praisejimmy/CapstoneProjectOWL/README.md

# CapstoneProjectOWL
CPE capstone repository for Project OWL
