praisejimmy/CapstoneProjectOWL/Hardware/README

Capstone Project RAFT Hardware
***
Ryan Myers
Tristan Chutka
Jake Loveland
Noah Palumbo
***

This folder contains all hardware design files for the RAFT system.
Autodesk EAGLE is used for circuit and PCB design.
