praisejimmy/CapstoneProjectOWL/Hardware/RAFT_DuckLink_RFH_BoM_2020Jan24.xlsx

Qty | Value | Device | Package | Ref Des | Description | DIGI-KEY_PART_NUMBER | DIGI-KEY_PURCHASE_URL | MF | MPN | PACKAGE.1
18 | 0.1uF | GCM155R71C104KA55J | CAPC1005X55N | C4, C6, C7, C8, C9, C10, C16, C18, C19, C20, C21, C34, C35, C36, C52, C55, C56, C62 | Cap Ceramic 0.1uF 16V X7R 10% Pad SMD 0402 125Â°C Automotive T/R | 490-7998-1-ND | https://www.digikey.com/product-detail/en/murata-electronics/GCM155R71C104KA55J/490-7998-1-ND/4380283 | Murata | GCM155R71C104KA55J | 1005 Taiyo Yuden
3 | 0R | CRCW04020000Z0ED | RESC1005X40N | R2, R3, R4 | RESISTOR, 0402, 0R, FULL REEL | 541-0.0JCT-ND | https://www.digikey.com/product-detail/en/vishay-dale/CRCW04020000Z0ED/541-0.0JCT-ND/1182611 | Vishay | CRCW04020000Z0ED | 1005 Panasonic Electronic Components
4 | 1.0uF | GCM155C71A105KE38D | CAPC1005X70N | C54, C59, C60, C61 | Cap Ceramic 1uF 10V X7S 10% Pad SMD 0402 125C Automotive T/R |  |  | Murata | GCM155C71A105KE38D | 1005 Murata
1 | 1.5pF | GCM1555C1H1R5JA16D | CAPC1005X55N | C26 | CAP AUTO-GRADE 1.5PF 50VDC C0G 5% SMD 0402 | 490-16452-1-ND | https://www.digikey.com/product-detail/en/murata-electronics/GCM1555C1H1R5JA16D/490-16452-1-ND/7363434 | Murata Electronics | GCM1555C1H1R5JA16D | 1005 Taiyo Yuden
1 | 1.5uH | LQM18PN1R5MFRL | INDC1608X95N | L9 | FIXED IND 1.5UH 800MA 288 MOHM | 490-17890-1-ND | https://www.digikey.com/product-detail/en/murata-electronics/LQM18PN1R5MFRL/490-17890-1-ND/8540126 | Murata | LQM18PN1R5MFRL | 1608 Murata
1 | 1.7pF | GCM1555C1H1R7CA16D | CAPC1005X55N | C12 | CAP CER 1.7PF 50V NP0 0402 | GCM1555C1H1R7CA16D-ND | https://www.digikey.com/product-detail/en/murata-electronics/GCM1555C1H1R7CA16D/GCM1555C1H1R7CA16D-ND/4903569 | Murata | GCM1555C1H1R7CA16D | 1005 Taiyo Yuden
1 | 1.8pF | GCM1555C1H1R8CA16D | CAPC1005X55N | C30 | CAP AUTO-GRADE 1.8PF 50VDC C0G 0.25PF SMD 0402 | 490-17746-1-ND | https://www.digikey.com/product-detail/en/murata-electronics/GCM1555C1H1R8CA16D/490-17746-1-ND/8539982 | Murata Electronics | GCM1555C1H1R8CA16D | 1005 Taiyo Yuden
1 | 10 | CRCW040210R0JNEDC | RESC1005X35N | R15 |  | 541-4122-1-ND | https://www.digikey.com/product-detail/en/vishay-dale/CRCW040210R0JNEDC/541-4122-1-ND/7928805 | Vishay | CRCW040210R0JNEDC | 1005 Yageo
3 | 100k | CRCW0402100KFKED | RESC1005X40N | R19, R5, R10 | RES, THICK FILM, 100K, 1%, 0.063W, 0402 | 541-100KLCT-ND | https://www.digikey.com/product-detail/en/vishay-dale/CRCW0402100KFKED/541-100KLCT-ND/1183351 | Vishay | CRCW0402100KFKED | 1005 Panasonic Electronic Components
2 | 100pF | GCM1555C1H101JA16D | CAPC1005X55N | C5, C33 | Cap Ceramic 100pF 50V C0G 10% Pad SMD 0402 125Â°C Automotive T/R | 490-10669-1-ND | https://www.digikey.com/product-detail/en/murata-electronics/GCM1555C1H101JA16D/490-10669-1-ND/5251436 | Murata | GCM1555C1H101JA16D | 1005 Taiyo Yuden
3 | 10K | CRCW040210K0JNED | RESC1005X40N | R16, R17, R9 | RES, THICK FILM, 10K, 5%, 0.063W, 0402, | 541-10KJCT-ND | https://www.digikey.com/product-detail/en/vishay-dale/CRCW040210K0JNED/541-10KJCT-ND/1182708 | Vishay Dale | CRCW040210K0JNED | 1005 Panasonic Electronic Components
3 | 10nF | GCM155R71H103KA55D | CAPC1005X55N | C14, C15, C25 | 10000pF Â±10% 50V Ceramic Capacitor X7R 0402 (1005 Metric)
1 | 10nH | LQG15HS10NJ02D | INDC1005X55N | L3 | Ind RF Chip Multi-Layer 10nH 5% 100MHz 8Q-Factor Air 300mA 0402 Paper T/R | 490-2623-1-ND | https://www.digikey.com/product-detail/en/murata-electronics/LQG15HS10NJ02D/490-2623-1-ND/662903 | Murata | LQG15HS10NJ02D | 1005 Murata
8 | 10uF | GRM155C80J106ME11D | CAPC1005X70N | C40, C50, C51, C53, C63, C64, C65, C68 | 10µF ±20% 6.3V Ceramic Capacitor X6S 0402 (1005 Metric) | 490-13233-1-ND | https://www.digikey.com/product-detail/en/murata-electronics/GRM155C80J106ME11D/490-13233-1-ND/5877441 | Murata Electronics | GRM155C80J106ME11D | 1005 Murata
1 | 10uH | LQM18FN100M00D | INDC1608X90N | L10 | Inductor Power Chip Shielded Multi-Layer 10uH 20% 1MHz Ferrite 50mA 1.17Ohm DCR 0603 T/R | 490-4025-1-ND | https://www.digikey.com/product-detail/en/murata-electronics/LQM18FN100M00D/490-4025-1-ND/1016285 | Murata Electronics | LQM18FN100M00D | 1608 Murata
1 | 150k | CRCW0402150KFKEDC | RESC1005X35N | R7 |  | 541-4008-1-ND | https://www.digikey.com/product-detail/en/vishay-dale/CRCW0402150KFKEDC/541-4008-1-ND/7928691 | Vishay Dale | CRCW0402150KFKEDC | 1005 Yageo
1 | 15K | CRCW040215K0JNED | RESC1005X40N | R1 | Res Thick Film 0402 15K Ohm 5% 1/16W Â±200ppm/Â°C Molded SMD SMD Paper T/R | 541-15KJCT-ND | https://www.digikey.com/product-detail/en/vishay-dale/CRCW040215K0JNED/541-15KJCT-ND/1182712 | Vishay Dale | CRCW040215K0JNED | 1005 Panasonic Electronic Components
9 | 15pF | GCM1555C1H150JA16D | CAPC1005X55N | C1, C17, C22, C31, C32, C43, C44, C45, C46 | Cap Ceramic 15pF 50V C0G 5% Pad SMD 0402 125C Automotive T/R | 490-11147-1-ND | https://www.digikey.com/product-detail/en/murata-electronics/GCM1555C1H150JA16D/490-11147-1-ND/5332987 | Murata | GCM1555C1H150JA16D | 1005 Taiyo Yuden
2 | 1nF | GCM155R71H102KA37D | CAPC1005X55N | C11 | Cap Ceramic 0.001uF 50V X7R 10% Pad SMD 0402 125C Automotive T/R | 490-4761-1-ND | https://www.digikey.com/product-detail/en/murata-electronics/GCM155R71H102KA37D/490-4761-1-ND/1641680 | Murata | GCM155R71H102KA37D | 1005 Taiyo Yuden
3 | 1uF | GCM155C71A105KE38D | CAPC1005X70N | C37, C38, C39 | Cap Ceramic 1uF 10V X7S 10% Pad SMD 0402 125C Automotive T/R | 490-13409-1-ND | https://www.digikey.com/product-detail/en/murata-electronics/GCM155C71A105KE38D/490-13409-1-ND/6012281 | Murata | GCM155C71A105KE38D | 1005 Murata
1 | 2.2uF | GRM155D80J225ME95D | CAPC1005X55N | C58 | CAP CER 2.2UF 6.3V X6T 0402 | 490-10450-1-ND | https://www.digikey.com/product-detail/en/murata-electronics/GRM155D80J225ME95D/490-10450-1-ND/5026360 | Murata | GRM155D80J225ME95D | 1005 Taiyo Yuden
1 | 20m | ERJ-3BWFR020V | RESC1608X55N | R_SR |  | P17461CT-ND | https://www.digikey.com/product-detail/en/panasonic-electronic-components/ERJ-3BWFR020V/P17461CT-ND/5647945 | Panasonic | ERJ-3BWFR020V | 1608 Panasonic Electronic Components
1 | 22pF | GCM1555C1H220JA16J | CAPC1005X55N | C67 | Cap Ceramic 22pF 50V C0G 5% Pad SMD 0402 125C Automotive T/R | 490-17747-1-ND | https://www.digikey.com/product-detail/en/murata-electronics/GCM1555C1H220JA16J/490-17747-1-ND/8539983 | Murata | GCM1555C1H220JA16J | 1005 Taiyo Yuden
3 | 22uF | GRM188R60J226MEA0D | CAPC1608X100N | C47, C48, C49 | Cap Ceramic 22uF 6.3V X5R 20% Pad SMD 0603 85Â°C T/R | 490-7611-1-ND | https://www.digikey.com/product-detail/en/murata-electronics/GRM188R60J226MEA0D/490-7611-1-ND/4280544 | Murata | GRM188R60J226MEA0D | 1608 Murata
2 | 270pF | GRM1555C1H271JA01D | CAPC1005X55N | C41, C42 | Multilayer Ceramic Capacitor, GRM Series, 270 pF, 5%, C0G / NP0, 50 V, 0402 [1005 Metric] | 490-1294-1-ND | https://www.digikey.com/product-detail/en/murata-electronics/GRM1555C1H271JA01D/490-1294-1-ND/587902 | Murata | GRM1555C1H271JA01D | 1005 Taiyo Yuden
1 | 2k | CRCW04022K00FKED | RESC1005X40N | R14 | RESISTOR, 0402, 2K, 1%, FULL REEL | 541-2.00KLCT-ND | https://www.digikey.com/product-detail/en/vishay-dale/CRCW04022K00FKED/541-2.00KLCT-ND/1183155 | Vishay Dale | CRCW04022K00FKED | 1005 Panasonic Electronic Components
1 | 2N7002 | 2N7002 | SOT23 | Q3 |  |  |  | STMicroelectronics | 2N7002 | SOT-23-3 Vishay
1 | 2nH | LQG15HN2N0C02D | INDC1005X55N | L7 | FIXED IND 2NH 900MA 90 MOHM | 490-15076-1-ND | https://www.digikey.com/product-detail/en/murata-electronics/LQG15HN2N0C02D/490-15076-1-ND/6799741 | Murata | LQG15HN2N0C02D | 1005 Murata
1 | 32.768kHz | FC-13532.768KA-AG0 | OSCCC150X320X80-2N | Y1 | FC-135 series 32.768kHz Â±20ppm Crystal 9pF 50 kOhms, -40Â°C ~ 85Â°C, Surface Mount 2-SMD, No Lead |  |  | EPSON | FC-135R 32.7680KA-AC3 | SMD-2 Epson
2 | 32MHz | NX2016SA-32M | SMD-4 | U$1, U$2 | 32MHz Crystal 10pF 60 Ohms 4-SMD, No Lead
1 | 33nF | LQG15HS33NJ02D | INDC1005X55N | L2 | LQG Series 0402 33 nH Â±5 % Tol. 200 mA SMT High Frequency Multilayer Inductor | 490-2629-1-ND | https://www.digikey.com/product-detail/en/murata-electronics/LQG15HS33NJ02D/490-2629-1-ND/662909 | Murata | LQG15HS33NJ02D | 1005 Murata
1 | 33pF | GCM1555C1H330JA16D | CAPC1005X55N | C27 | 33pF Â±5% 50V Ceramic Capacitor C0G, NP0 0402 (1005 Metric) |  |  | Murata | GCM1555C1H330JA16D | 1005 Taiyo Yuden
1 | 36k | CRCW040236K0FKED | RESC1005X40N | R13 | Surface Mount Thick Film Resistor, AEC-Q200 CRCW Series, 36 kohm, 63 mW, - 1%, 50 V | 541-36.0KLCT-ND | https://www.digikey.com/product-detail/en/vishay-dale/CRCW040236K0FKED/541-36.0KLCT-ND/1183299 | Vishay | CRCW040236K0FKED | 1005 Panasonic Electronic Components
1 | 4.7k | CRCW04024K70JNEDC | RESC1005X35N | R8 | D10/CRCW0402-C 200 4K7 5% ET7 | 541-3974-1-ND | https://www.digikey.com/product-detail/en/vishay-dale/CRCW04024K70JNEDC/541-3974-1-ND/7928657 | Vishay | CRCW04024K70JNEDC | 1005 Yageo
2 | 4.7pF | GCM1555C1H4R7CA16D | CAPC1005X55N | C28, C29 | Cap Ceramic 4.7pF 50V C0G 0.25pF SMD 0402 125Â°C Paper T/R | 490-12652-1-ND | https://www.digikey.com/product-detail/en/murata-electronics/GCM1555C1H4R7CA16D/490-12652-1-ND/5797621 | Murata Electronics | GCM1555C1H4R7CA16D | 1005 Taiyo Yuden
2 | 4.7uF | GRM155R60J475ME87D | CAPC1005X55N | C57, C66 | Cap Ceramic 4.7uF 6.3V X5R 20% SMD 0402 85Â°C Paper T/R |  |  | Murata | GRM155R60J475ME87D | 1005 Taiyo Yuden
1 | 40MHz | R2520-40 | SMD-4 | U$3 | 40MHz Â±10ppm Crystal 12pF 60 Ohms 4-SMD, No Lead
1 | 470k | CRCW0402470KFKEDC | RESC1005X35N | R6 |  | 541-4081-1-ND | https://www.digikey.com/product-detail/en/vishay-dale/CRCW0402470KFKEDC/541-4081-1-ND/7928764 | Vishay | CRCW0402470KFKEDC | 1005 Yageo
2 | 470pF | GCM1555C1H471JA16D | CAPC1005X55N | C2, C13 | Cap Ceramic 470pF 50V C0G/NP0 5% Pad SMD 0402 125C Automotive T/R | 490-4758-1-ND | https://www.digikey.com/product-detail/en/murata-electronics/GCM1555C1H471JA16D/490-4758-1-ND/1641677 | Murata | GCM1555C1H471JA16D | 1005 Taiyo Yuden
2 | 47nF | GCM155R71C473KA37D | CAPC1005X55N | C23, C24 | Cap Ceramic 0.047uF 16V X7R 10% Pad SMD 0402 125C Automotive T/R | 490-6042-1-ND | https://www.digikey.com/product-detail/en/murata-electronics/GCM155R71C473KA37D/490-6042-1-ND/3845242 | Murata | GCM155R71C473KA37D | 1005 Taiyo Yuden
3 | 499R | CRCW0402499RFKEDC | RESC1005X35N | R11, R12, R18 | 499 Ohms Â±1% 0.063W, 1/16W Chip Resistor 0402 (1005 Metric) Thick Film | 541-4007-1-ND | https://www.digikey.com/product-detail/en/vishay-dale/CRCW0402499RFKEDC/541-4007-1-ND/7928690 | Vishay | CRCW0402499RFKEDC | 1005 Yageo
2 | 5.6nH | LQG15HS5N6C02D | INDC1005X55N | L4, L8 | FIXED IND 5.6NH 650MA 180 MOHM | 490-15129-1-ND | https://www.digikey.com/product-detail/en/murata-electronics/LQG15HS5N6C02D/490-15129-1-ND/6799794 | Murata | LQG15HS5N6C02D | 1005 Murata
1 | 6.8nH | LQG15HS6N8J02D | INDC1005X55N | L1 | 6.8nH Unshielded Multilayer Inductor 600mA 240mOhm Max 0402 (1005 Metric)
1 | 7.5nH | LQG15HN7N5H02D | INDC1005X55N | L6 | FIXED IND 7.5NH 500MA 240 MOHM | 490-15095-1-ND | https://www.digikey.com/product-detail/en/murata-electronics/LQG15HN7N5H02D/490-15095-1-ND/6799760 | Murata | LQG15HN7N5H02D | 1005 Murata
1 | 750pF | GCM1885C2A751JA16D | CAPC1608X90N | C3 | Cap Ceramic 750pF 100V C0G 5% SMD 0603 125Â°C Paper T/R | GCM1885C2A751JA16D-ND | https://www.digikey.com/product-detail/en/murata-electronics/GCM1885C2A751JA16D/GCM1885C2A751JA16D-ND/2591804 | Murata | GCM1885C2A751JA16D | 1608 Murata
1 | 8.2nH | LQG15HS8N2J02D | INDC1005X55N | L5 | Ind RF Chip Multi-Layer 8.2nH 5% 100MHz 8Q-Factor Air 300mA 0402 Paper T/R | 490-2622-6-ND | https://www.digikey.com/product-detail/en/murata-electronics/LQG15HS8N2J02D/490-2622-6-ND/1825762 | Murata | LQG15HS8N2J02D | 1005 Murata
3 | AMPHENOL_132134 | AMPHENOL_132134 | AMPHENOL_132134-15 | J1, J2, J3 | Rf Coaxial, Sma, Straight Jack, Pcb |  |  | Amphenol RF | 132134-15 | None
1 | BAT54C | BAT54C | SOT23 | D2 | Schottky Diodes
1 | BQ24650RVAR | BQ24650RVAR | QFN50P350X350X100-17N | U8 | Synchronous Switch-Mode Battery Charge Controller |  |  | Texas Instruments | BQ24650RVAR | VFQFN-16 Murata Power Solutions
1 | ESP32-D0WD | ESP32-D0WD | QFN35P500X500X90-49N | U3 | ESP32 is a single 2.4 GHz Wi-Fi-and-Bluetooth combo chip designed with the TSMC ultra-low-power 40 nm technology. It is designed to achieve the best power and RF performance, showing robustness, versatility and reliability in a wide variety of applications and power scenarios. |  |  | Espressif Systems | ESP32-D0WD | VFQFN-48 Espressif Systems
1 | INTERFACE-CP2102-GMR(QFN28) | INTERFACE-CP2102-GMR(QFN28) | QFN28G_0.5-5X5MM | U5 | 310070003 |  |  | Silicon | CP2102-GMR | VFQFN-28 Vishay Siliconix
2 | LTST-C190GKT | LTST-C190GKT | 0603 | D3, D4 | https://octopart.com/ltst-c190gkt-lite-on-549821 |  |  | Lite-On Inc. | LTST-C190GKT | 0603 Lite-On
1 | MAX2771ETI+ | MAX2771ETI+ | QFN50P500X500X80-29N | U2 | None |  |  | Maxim Integrated | MAX2771ETI+ | TQFN-28 Maxim
1 | Micro-USB | 105017-0001FIXED | MOLEX_105017-0001 | J4 |  | Through Hole | WM1399CT-ND |  |  | 1050170001
1 | PDS1040-13 | PDS1040-13 | DIO_PDS1040-13 | D1 | PDS1040 Series 40 V 10 A Surface Mount Schottky Barrier Rectifier - PowerDIÂ™ 5 |  |  | Diodes Inc. | PDS1040-13 | PowerDI™ 5 Diodes Inc.
2 | PE4259 | PE4259 | SOT65P215X110-6N | U6 | SPDT High Power UltraCMOS 10 MHzâ€“3.0 GHz RF Switch |  |  | pSemi | PE4259 | SOT-363 Peregrine Semiconductor
1 | SI7288DP | SI7288DP | POWERPAK-SO8_1 | Q2 | Trans MOSFET N-CH 40V 10An Vishay SI7288DP-T1-GE3 Dual N-channel MOSFET Transistor, 20 A, 40 V, 8-Pin PowerPAK SO
1 | SIA817EDJ | SIA817EDJ | SC70-6L-DUAL | Q1 | P-Channel 30V 4.5A (Tc) 1.9W (Ta), 6.5W (Tc) Surface Mount PowerPAKÂ® SC-70-6 Dual
1 | SP0503BAHT | SP0503BAHT | SOT143 | U7 |  | SP0503BAHT-ND | https://www.digikey.com/product-detail/en/littelfuse-inc/SP0503BAHT/SP0503BAHT-ND/485122 | Littelfuse Inc. | SP0503BAHT | SOT-143 Littelfuse
1 | SX1276 | SX1276 | QFN65P600X600X100-29N | U1 | RF Transceiver FSK/GFSK/MSK/GMSK/LoRa/OOK 137MHz to 1020MHz 28-Pin QFN |  |  | Semtech Corporation | SX1276 | VQFN-28 Semtech Corporation
1 | TPS63070RNMT | TPS63070RNMT | QFN50P250X300X100-15N | U9 | Wide Input Voltage (2V-16V) Buck-Boost Converter 15-VQFN-HR |  |  | Texas Instruments | TPS63070RNMT | VQFN-15 Texas Instruments
1 | W25Q16BVSSIG | W25Q16BVSSIG | SOIC127P790X216-8N | U4 | Flash, pin, soic, flash, Memory, Semiconductors and Actives, serial, ic |  |  | Winbond | W25Q16BVSSIG | SOIC-8 Winbond
