praisejimmy/CapstoneProjectOWL/Hardware/schematics/DuckLink_RFH_schematics_2.0.pdf

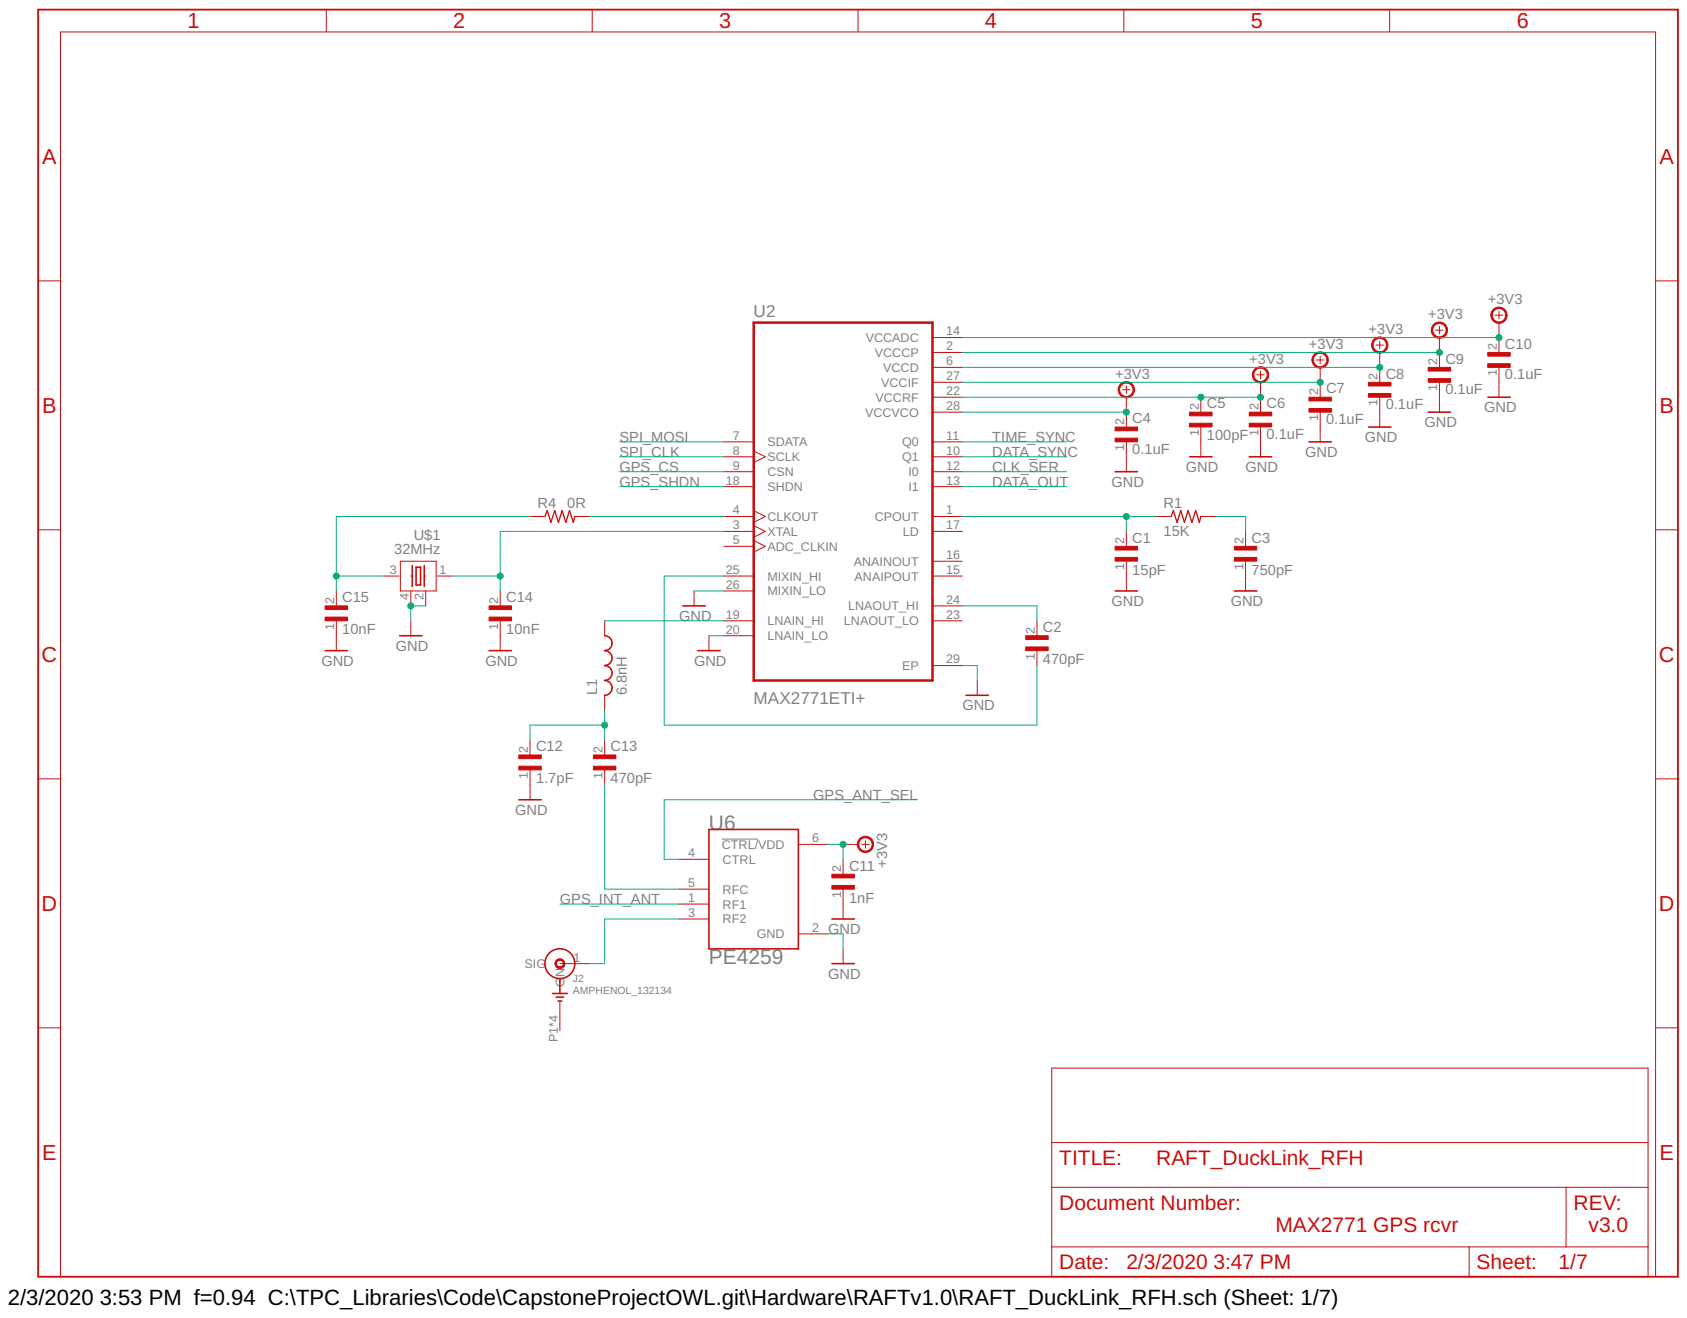
[picture p1: page 1]

2 VCCD
6 VCCIF
27 VCCRF 22 VCCVCO

Document Number: MAX2771 GPS rcvr | REV: v3.0

Date: 2/3/2020 3:47 PM | Sheet: 1/7

2/3/2020 3:53 PM f=0.94 C:\TPC_Libraries\Code\CapstoneProjectOWL.git\Hardware\RAFTv1.0\RAFT_DuckLink_RFH.sch (Sheet: 1/7)

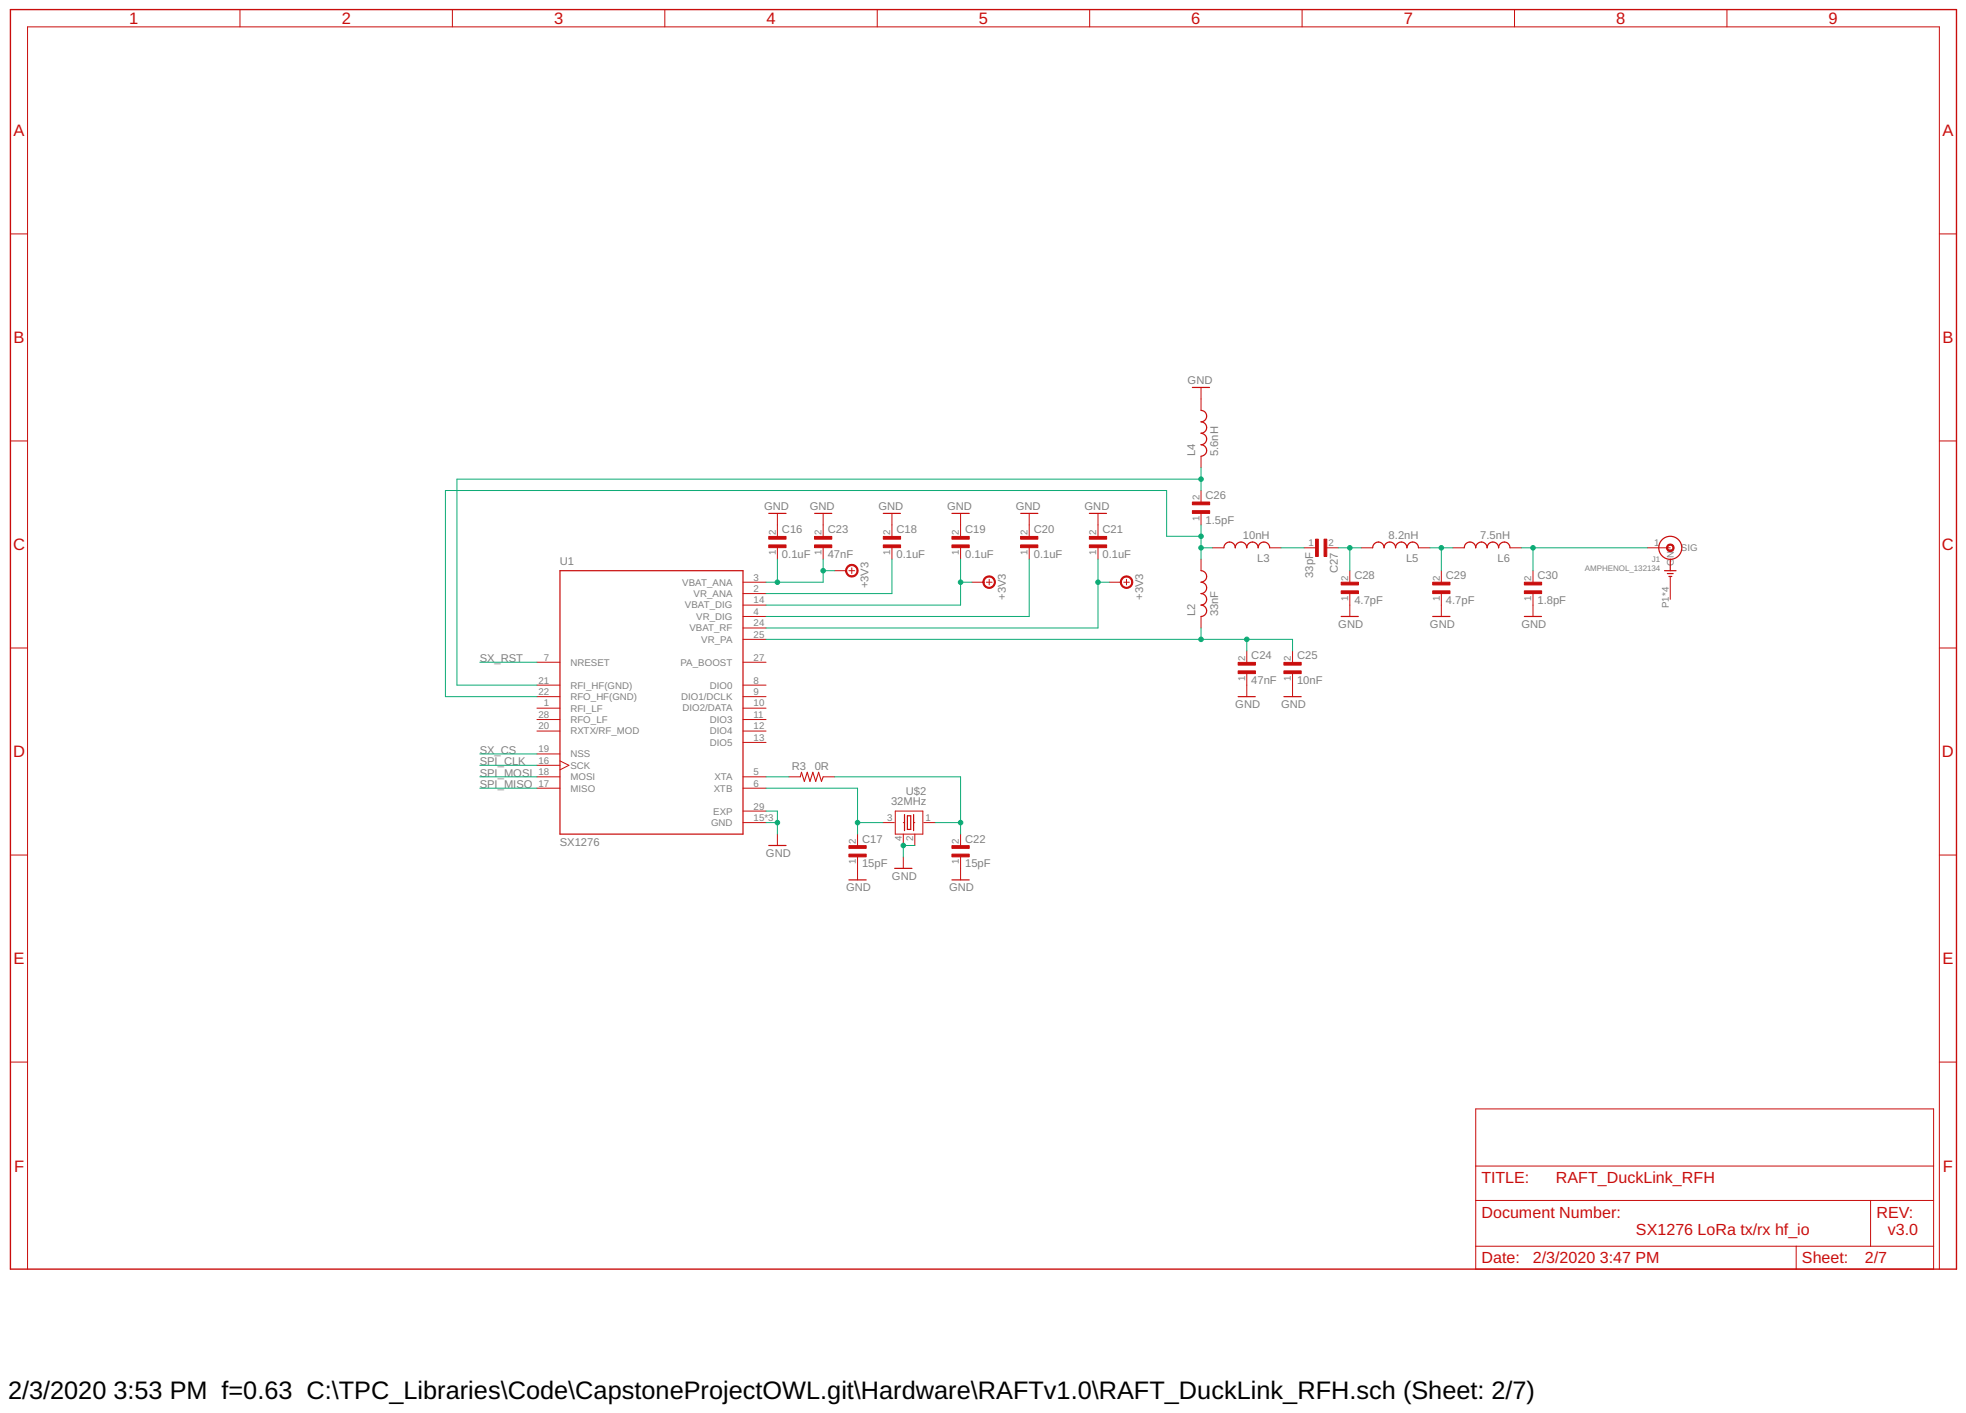
[picture p2: page 2]

2/3/2020 3:53 PM f=0.63 C:\TPC_Libraries\Code\CapstoneProjectOWL.git\Hardware\RAFTv1.0\RAFT_DuckLink_RFH.sch (Sheet: 2/7)

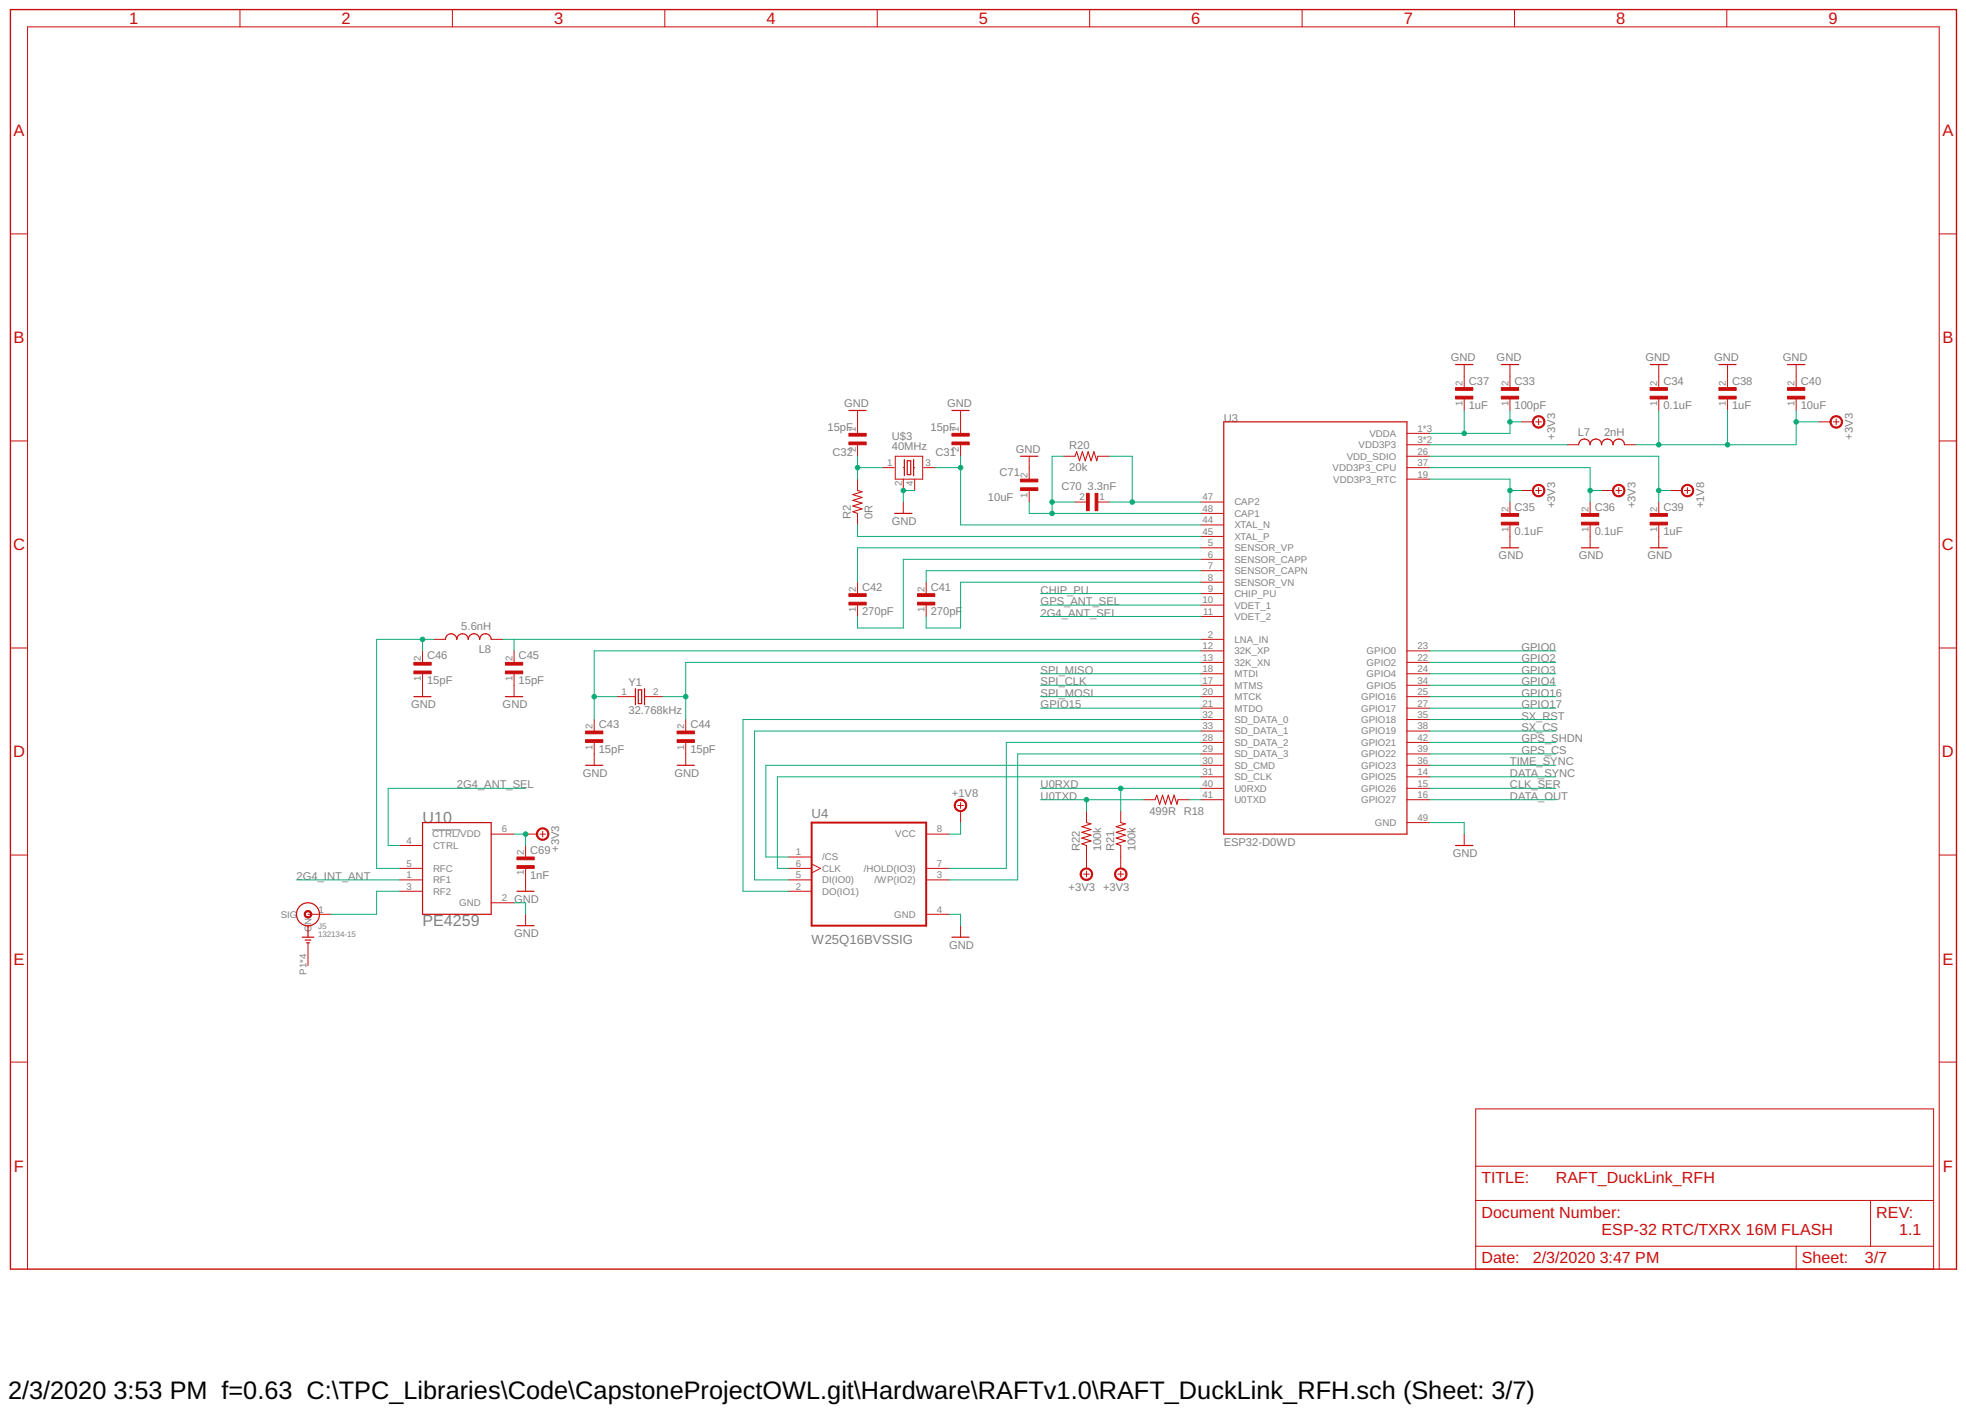
[picture p3: page 3]

2/3/2020 3:53 PM f=0.63 C:\TPC_Libraries\Code\CapstoneProjectOWL.git\Hardware\RAFTv1.0\RAFT_DuckLink_RFH.sch (Sheet: 3/7)

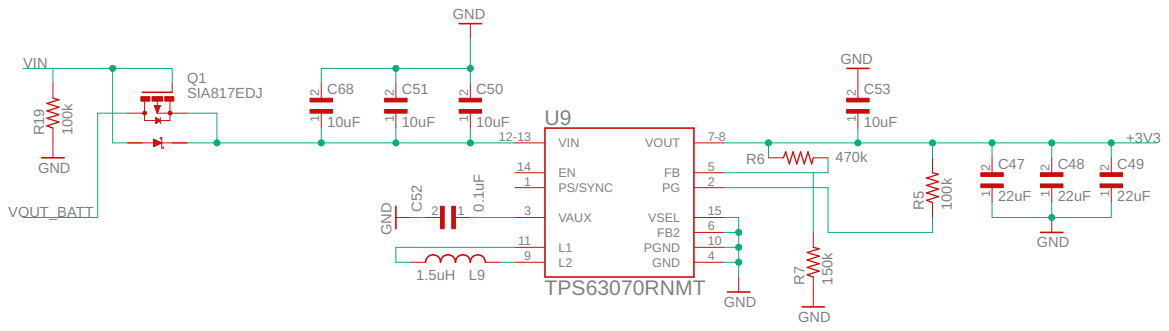
[picture p4: page 4]

2/3/2020 3:53 PM f=0.94 C:\TPC_Libraries\Code\CapstoneProjectOWL.git\Hardware\RAFTv1.0\RAFT_DuckLink_RFH.sch (Sheet: 4/7)

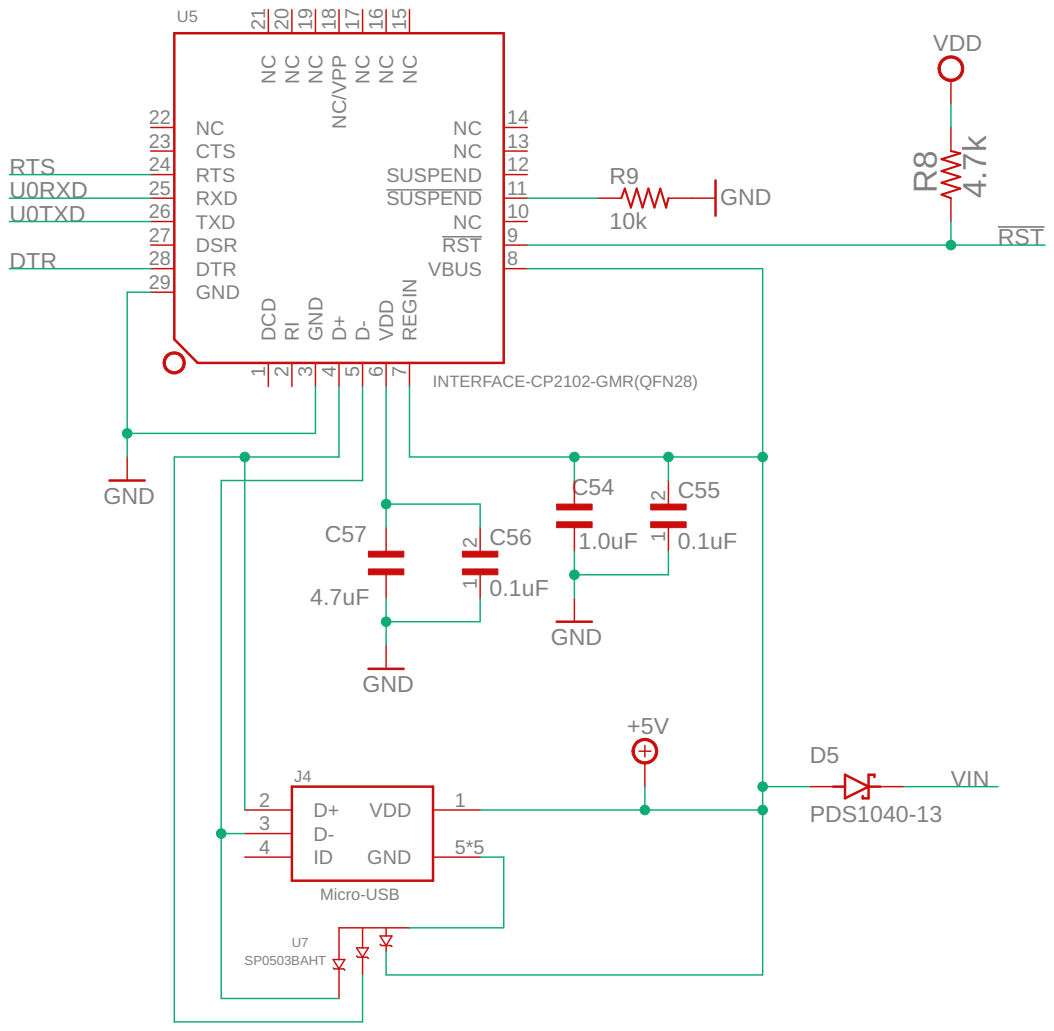
[picture p5: page 5]

2/3/2020 3:53 PM f=0.94 C:\TPC_Libraries\Code\CapstoneProjectOWL.git\Hardware\RAFTv1.0\RAFT_DuckLink_RFH.sch (Sheet: 5/7)

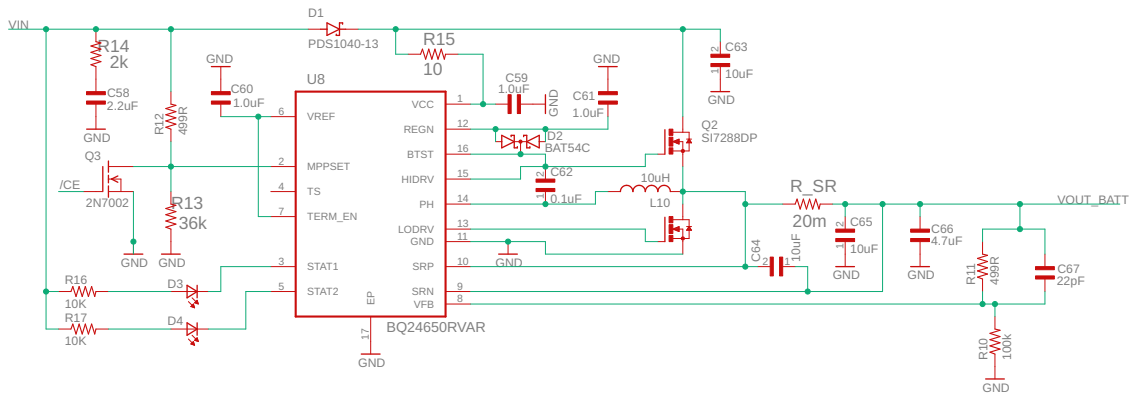
[picture p6: page 6]

2/3/2020 3:53 PM f=0.94 C:\TPC_Libraries\Code\CapstoneProjectOWL.git\Hardware\RAFTv1.0\RAFT_DuckLink_RFH.sch (Sheet: 6/7)

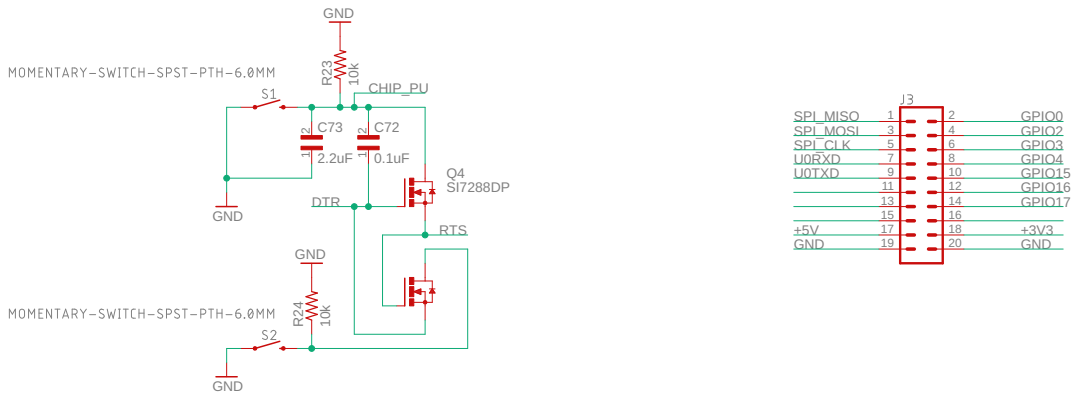
[picture p7: page 7]

2/3/2020 3:53 PM f=0.94 C:\TPC_Libraries\Code\CapstoneProjectOWL.git\Hardware\RAFTv1.0\RAFT_DuckLink_RFH.sch (Sheet: 7/7)
