praisejimmy/CapstoneProjectOWL/Hardware/schematics/DuckLink_RFH_schematics_2.1.pdf

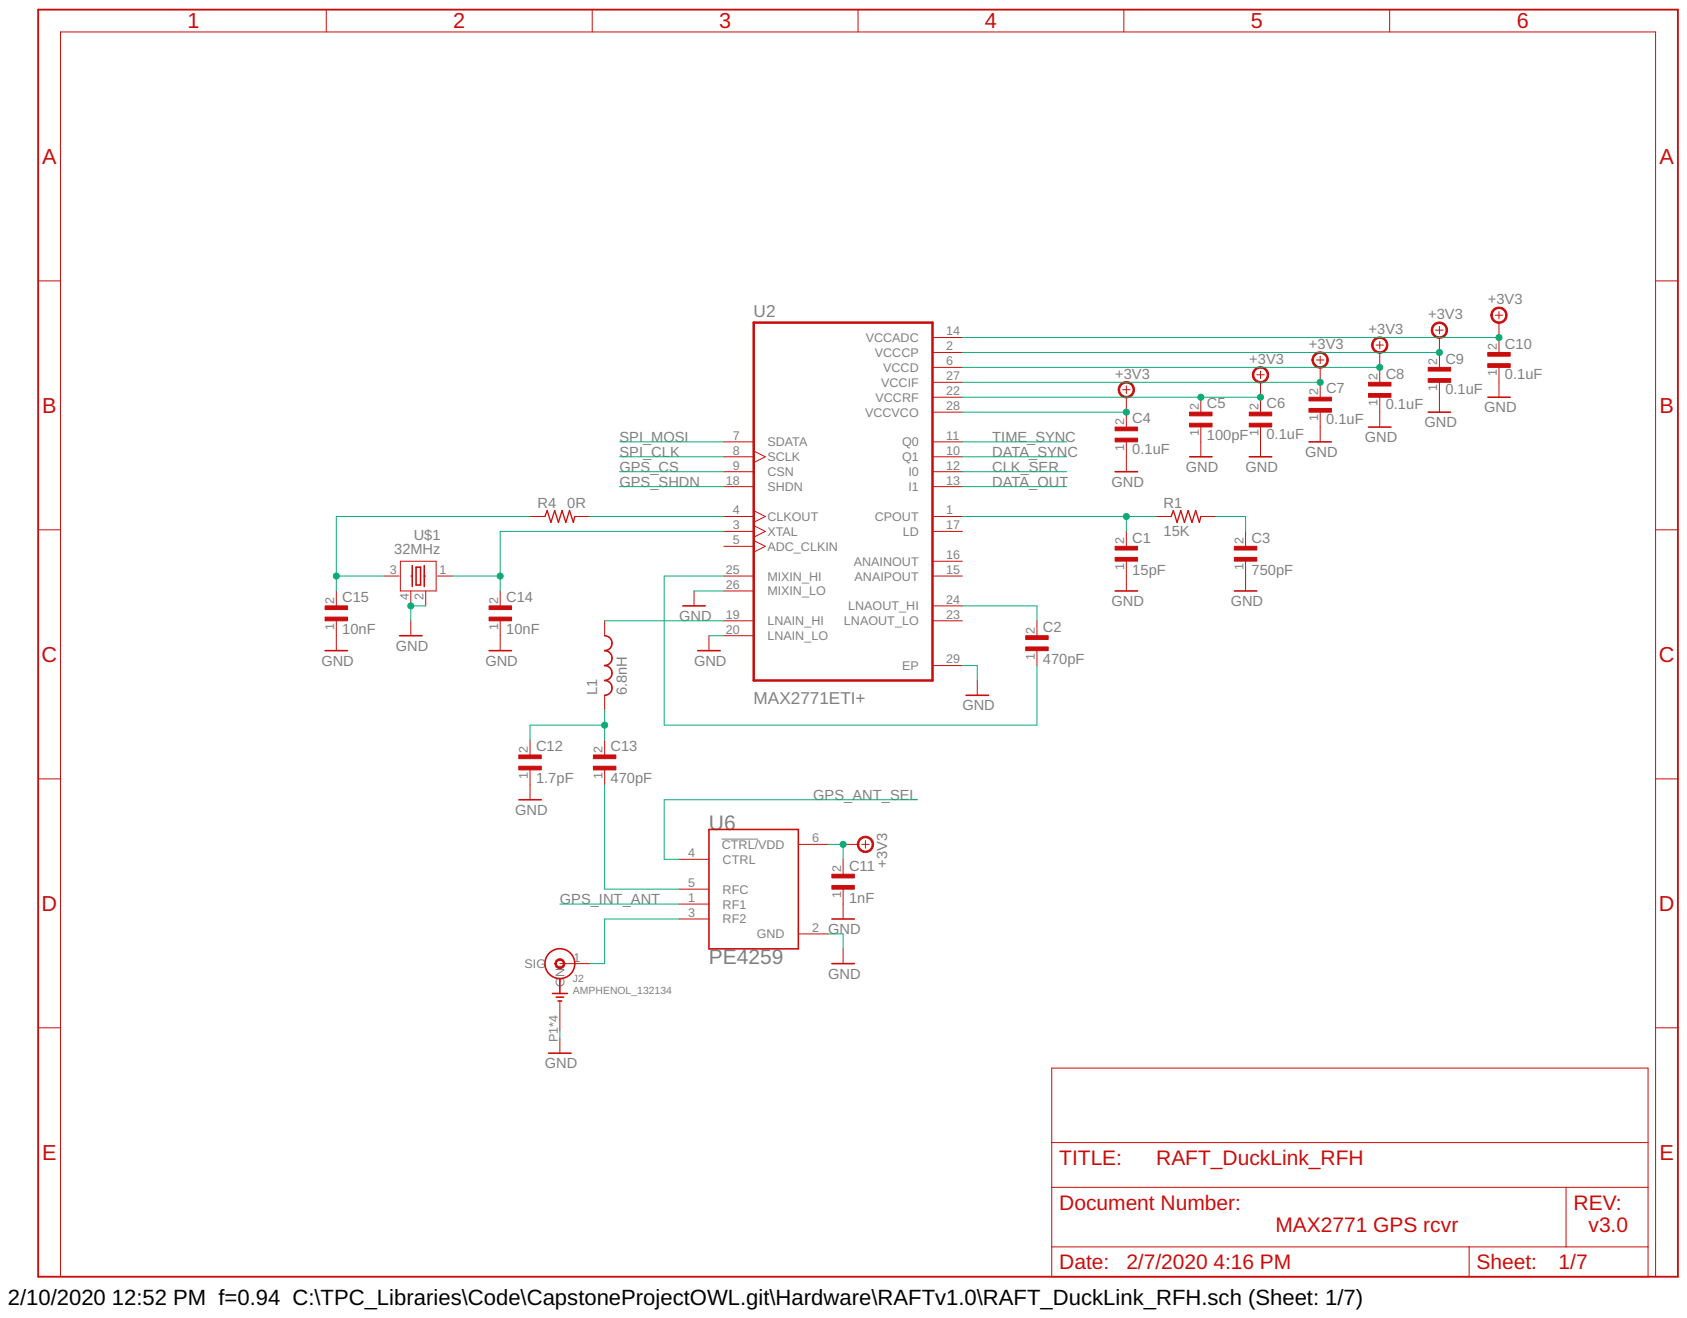
[picture p8: page 1]

2 VCCD
6 VCCIF
27 VCCRF 22 VCCVCO

Document Number: MAX2771 GPS rcvr | REV: v3.0

Date: 2/7/2020 4:16 PM | Sheet: 1/7

2/10/2020 12:52 PM f=0.94 C:\TPC_Libraries\Code\CapstoneProjectOWL.git\Hardware\RAFTv1.0\RAFT_DuckLink_RFH.sch (Sheet: 1/7)

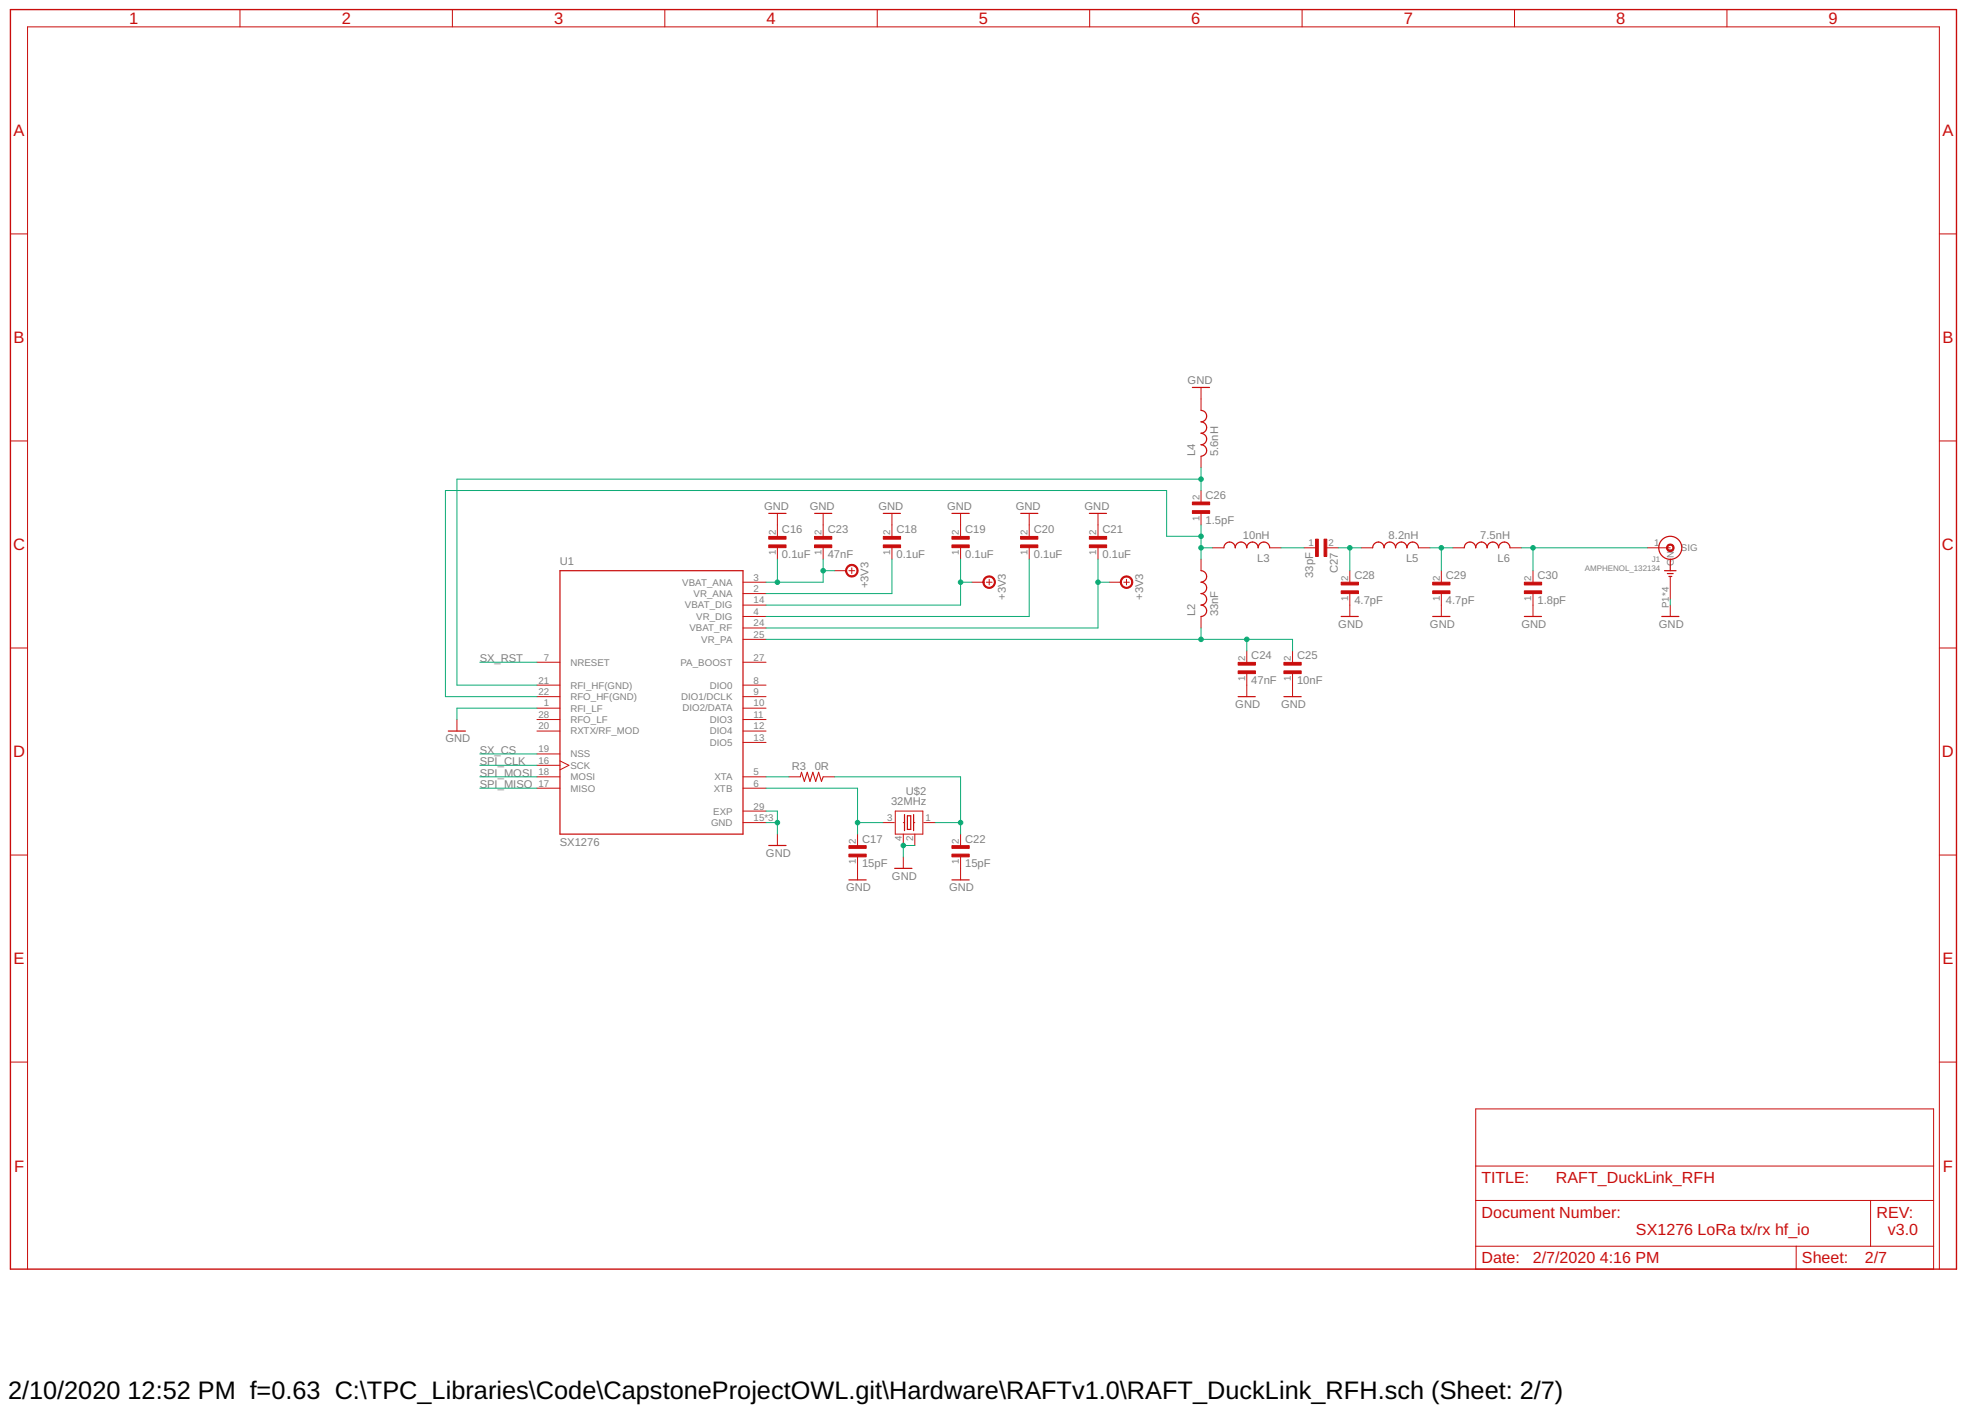
[picture p9: page 2]

2/10/2020 12:52 PM f=0.63 C:\TPC_Libraries\Code\CapstoneProjectOWL.git\Hardware\RAFTv1.0\RAFT_DuckLink_RFH.sch (Sheet: 2/7)

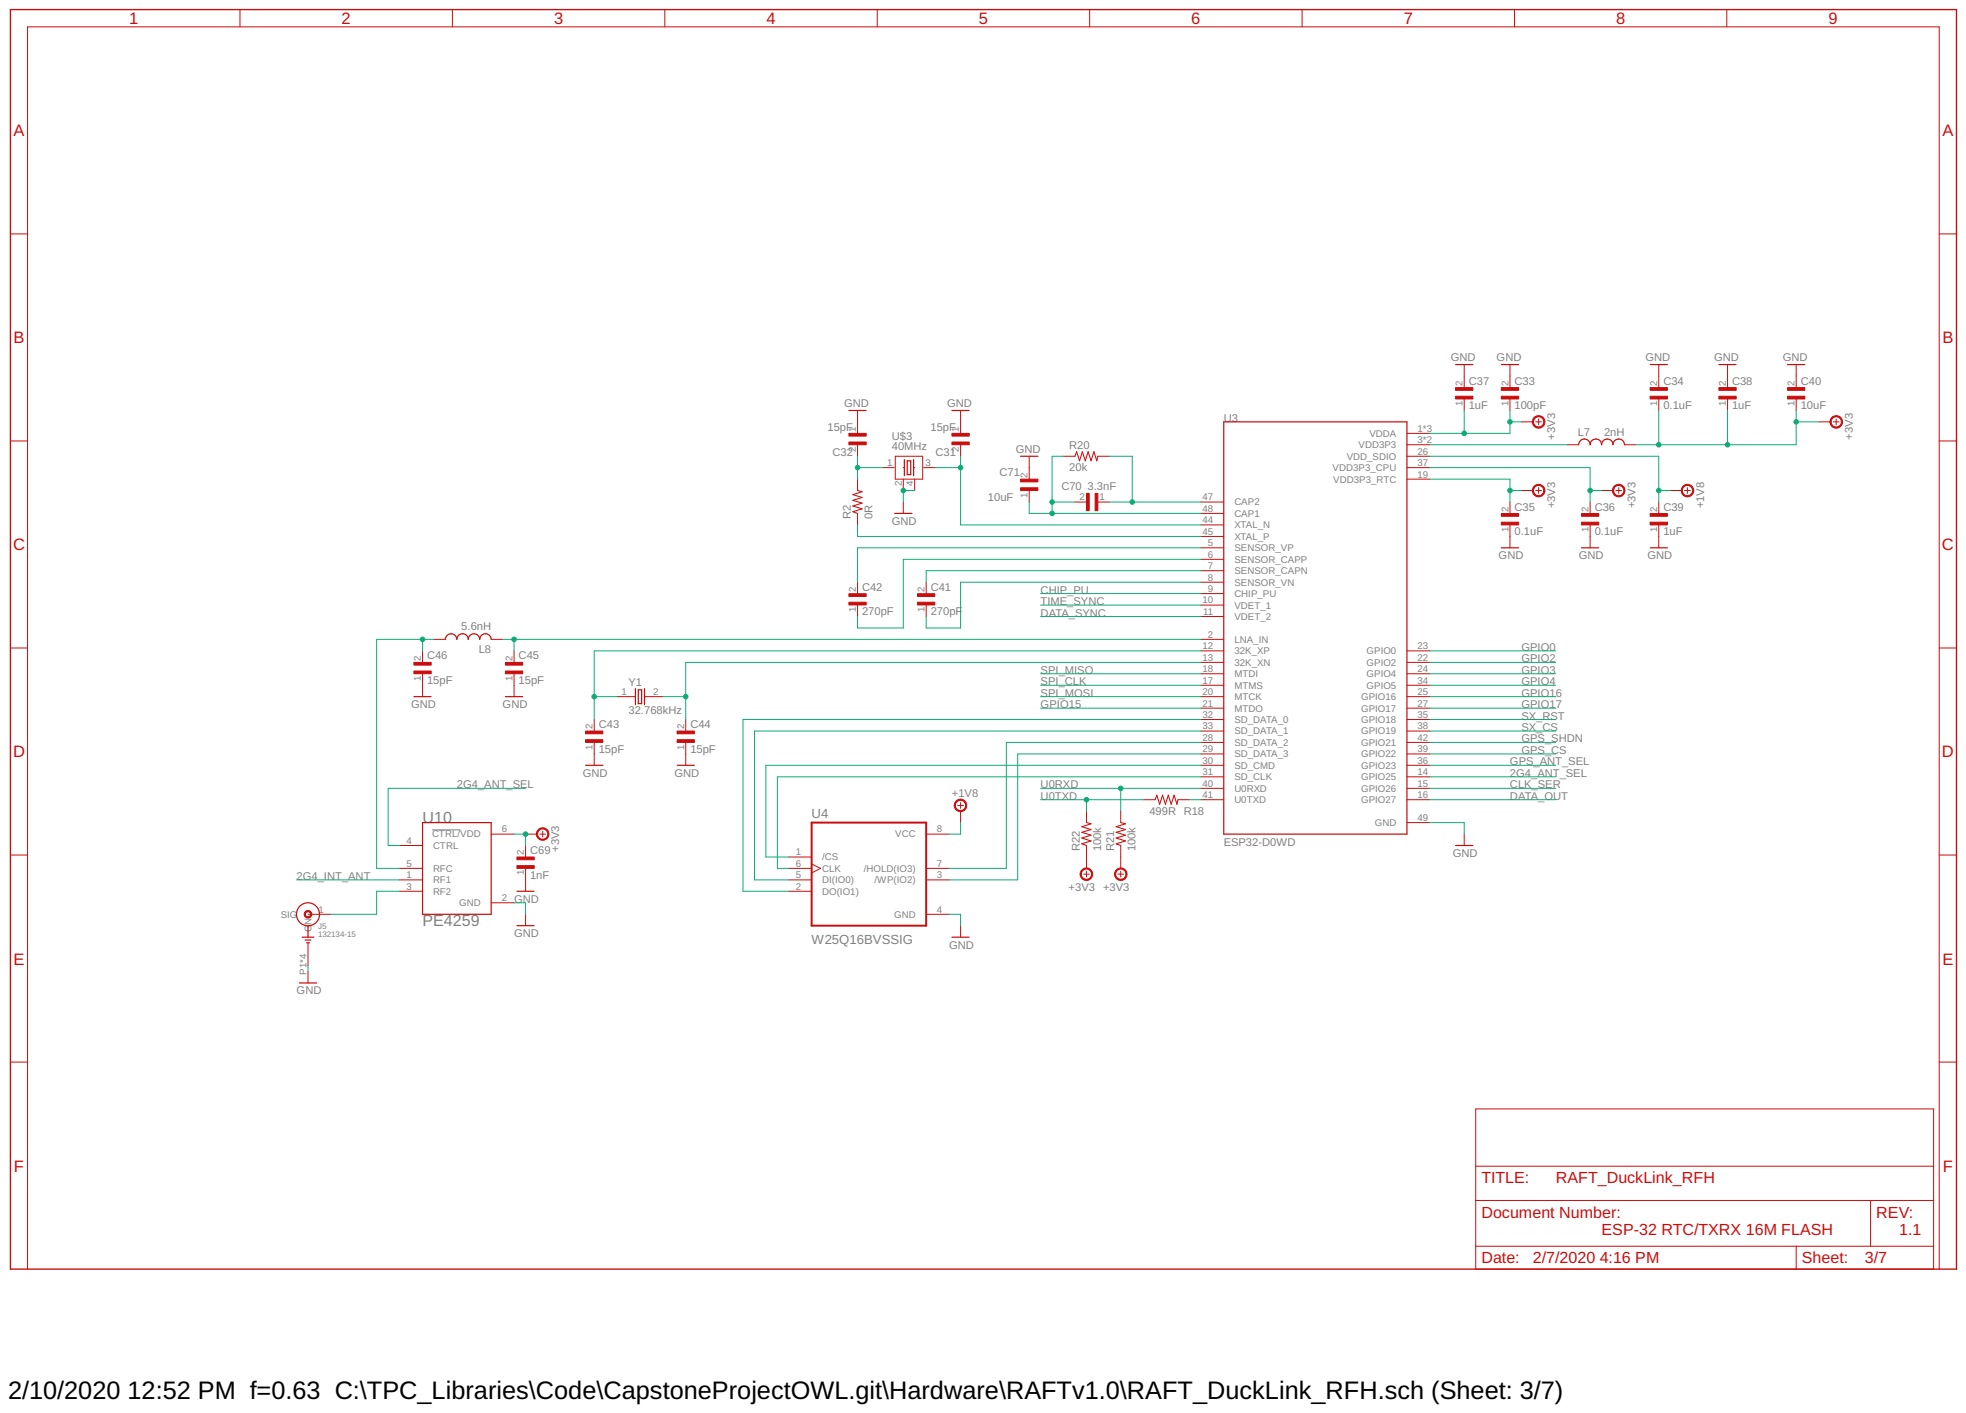
[picture p10: page 3]

2/10/2020 12:52 PM f=0.63 C:\TPC_Libraries\Code\CapstoneProjectOWL.git\Hardware\RAFTv1.0\RAFT_DuckLink_RFH.sch (Sheet: 3/7)

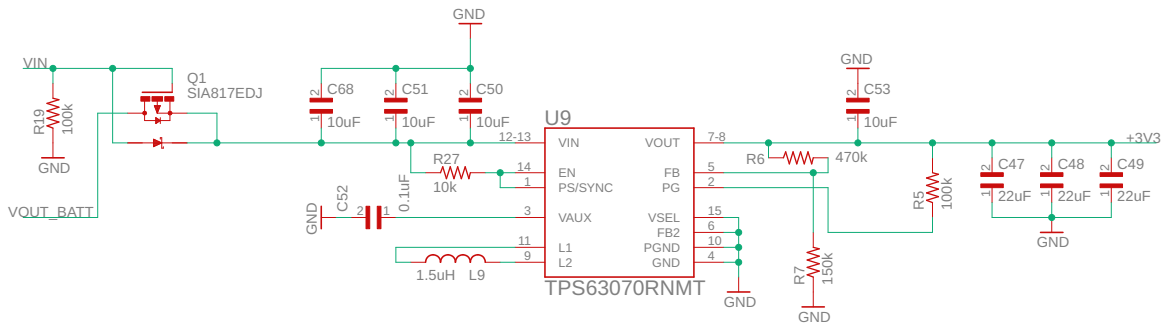
[picture p11: page 4]

2/10/2020 12:52 PM f=0.94 C:\TPC_Libraries\Code\CapstoneProjectOWL.git\Hardware\RAFTv1.0\RAFT_DuckLink_RFH.sch (Sheet: 4/7)

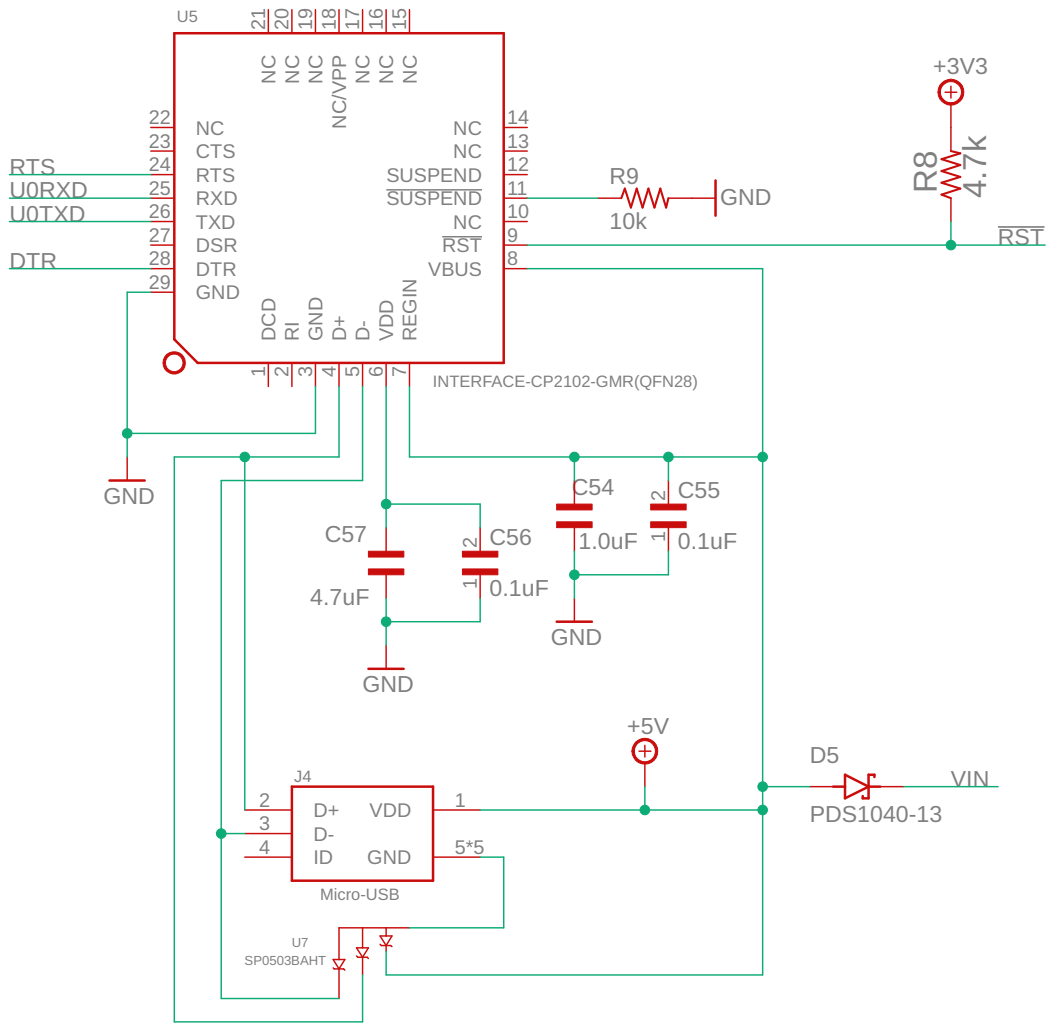
[picture p12: page 5]

2/10/2020 12:52 PM f=0.94 C:\TPC_Libraries\Code\CapstoneProjectOWL.git\Hardware\RAFTv1.0\RAFT_DuckLink_RFH.sch (Sheet: 5/7)

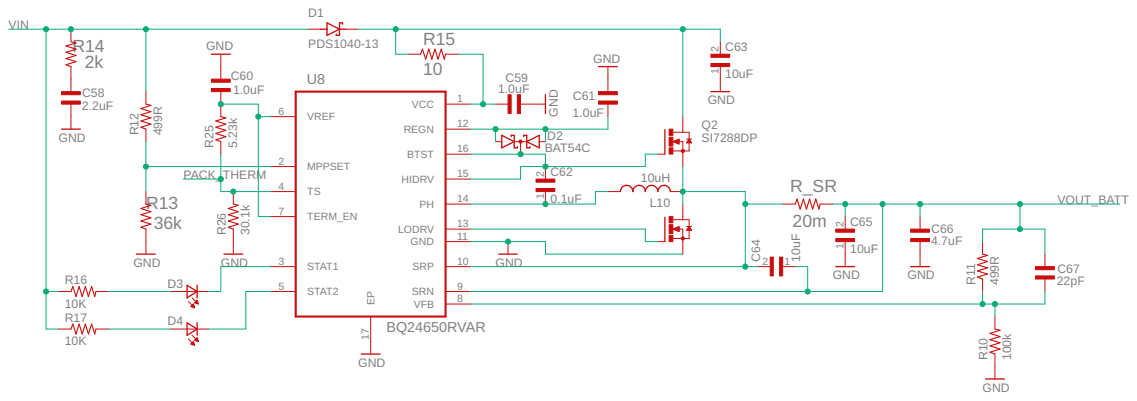
[picture p13: page 6]

2/10/2020 12:52 PM f=0.94 C:\TPC_Libraries\Code\CapstoneProjectOWL.git\Hardware\RAFTv1.0\RAFT_DuckLink_RFH.sch (Sheet: 6/7)

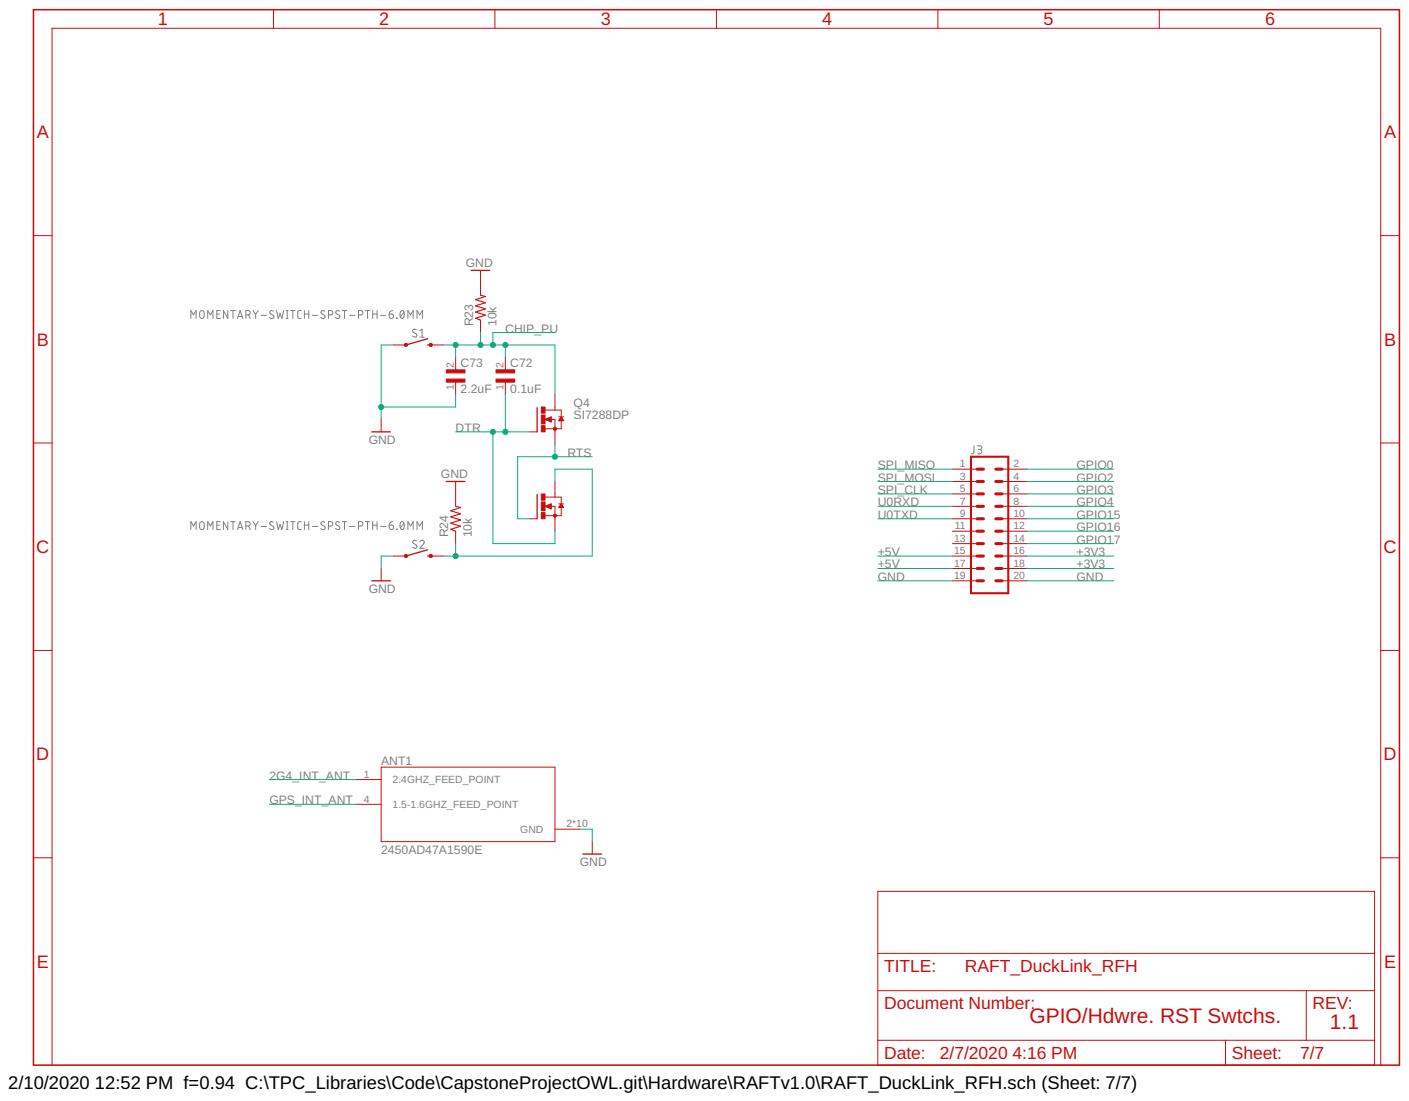
[picture p14: page 7]

2/10/2020 12:52 PM f=0.94 C:\TPC_Libraries\Code\CapstoneProjectOWL.git\Hardware\RAFTv1.0\RAFT_DuckLink_RFH.sch (Sheet: 7/7)
