praisejimmy/CapstoneProjectOWL/Hardware/schematics/DuckLink_GPS_MAX2771_schematic_1.0.0.pdf

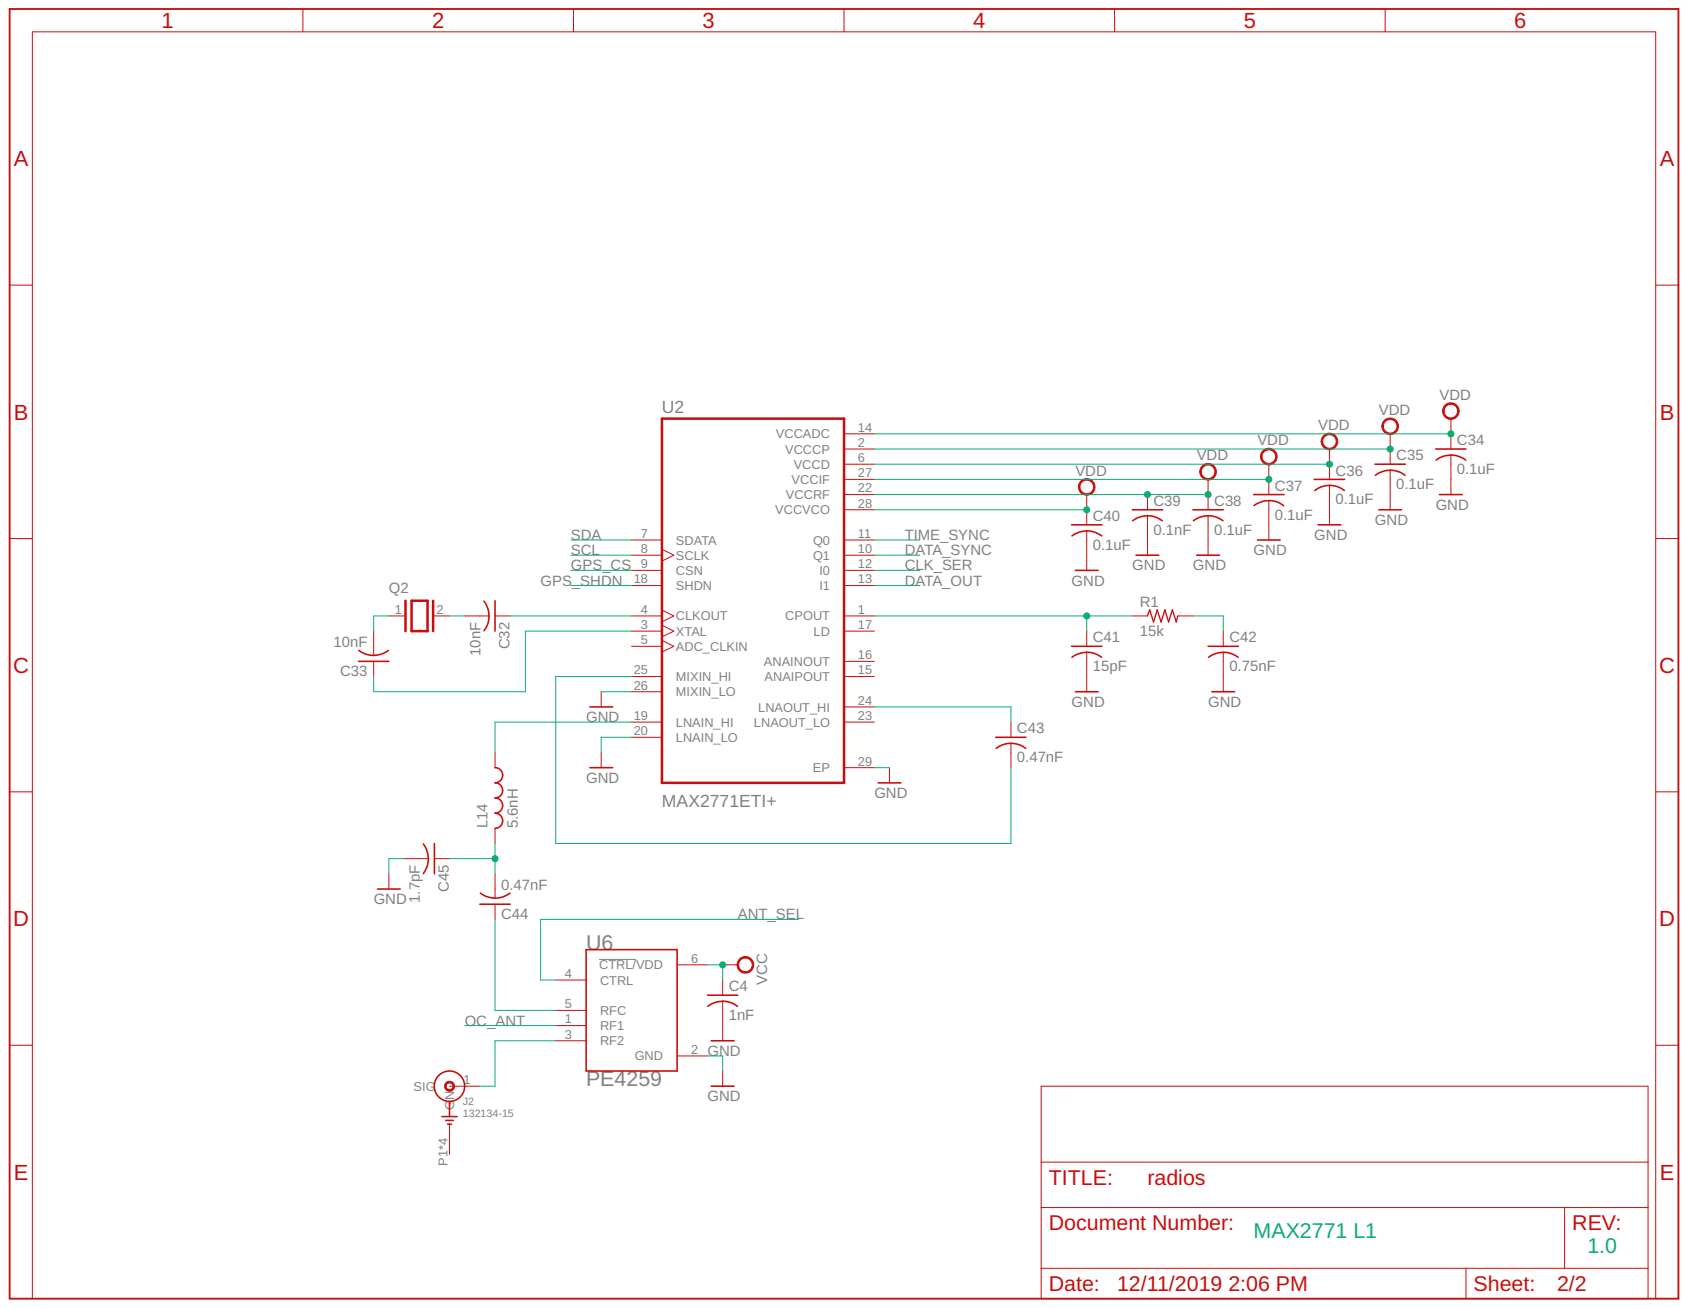
[picture p15: page 1]

2 VCCD VDD
6 VCCIF VDD
27 VCCRF
22 VCCVCO 28 | R1

VDD

Document Number: MAX2771 L1 | REV: 1.0

Date: 12/11/2019 2:06 PM | Sheet: 2/2
