praisejimmy/CapstoneProjectOWL/Hardware/schematics/DuckLink_LoRa_SX1276_schematic_1.2.0.pdf

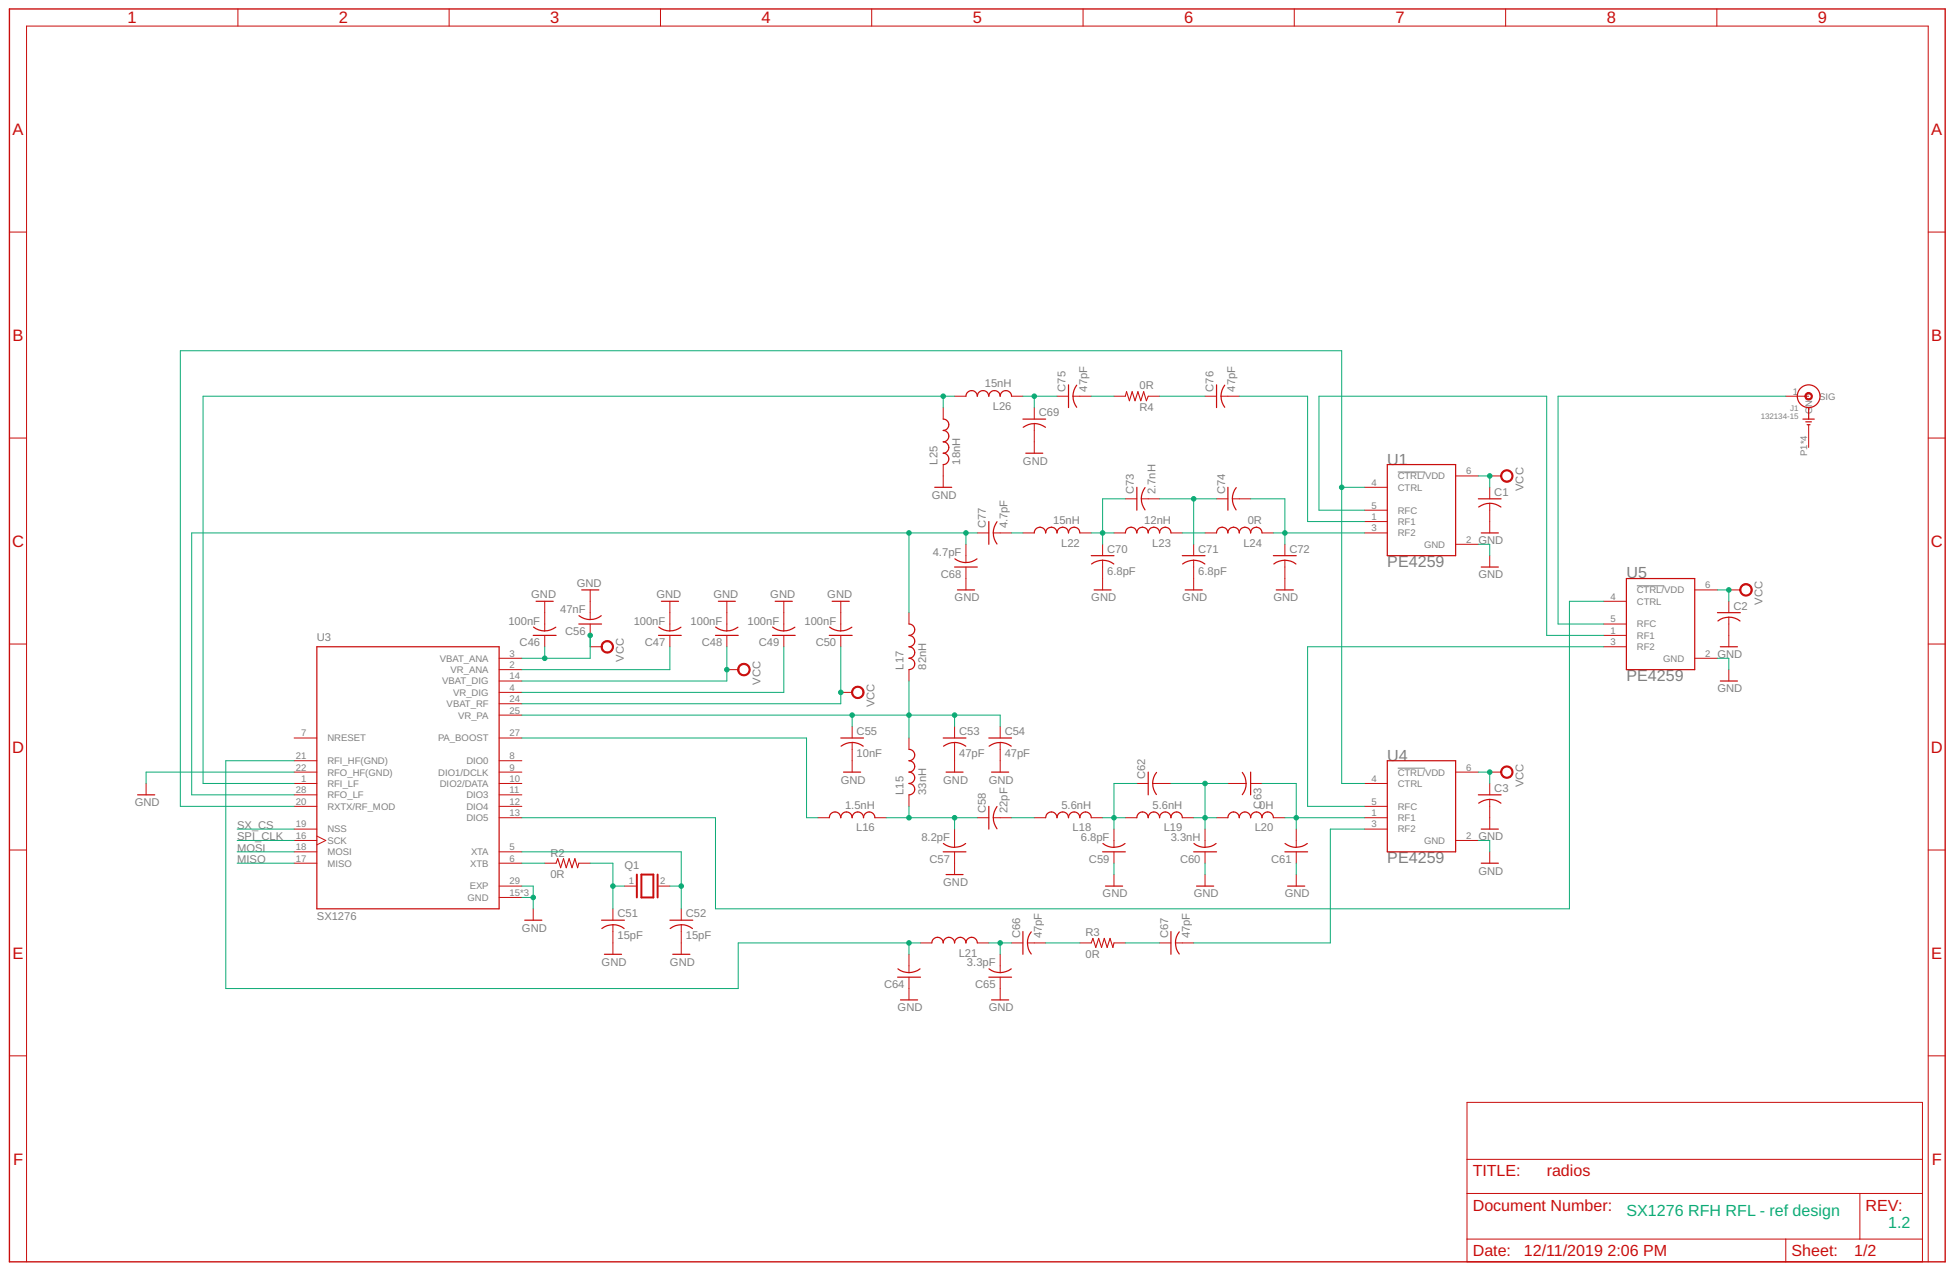
[picture p16: page 1]
