praisejimmy/CapstoneProjectOWL/Hardware/RAFTv1.0/RAFT_DuckLink_NA.sch

## EAGLE design Hardware/RAFTv1.0/RAFT_DuckLink_NA.sch (2019-12-28)

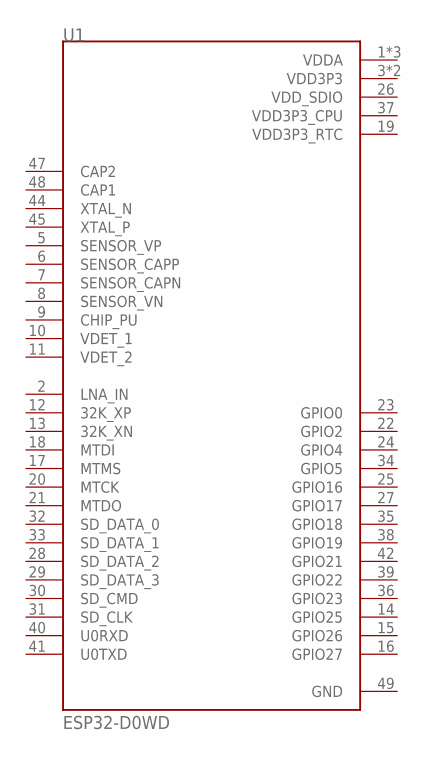
[picture p17: schematic RAFT_DuckLink_NA.sch, sheet 1]

Parts:
U1: ESP32-D0WD; QFN35P500X500X90-49N

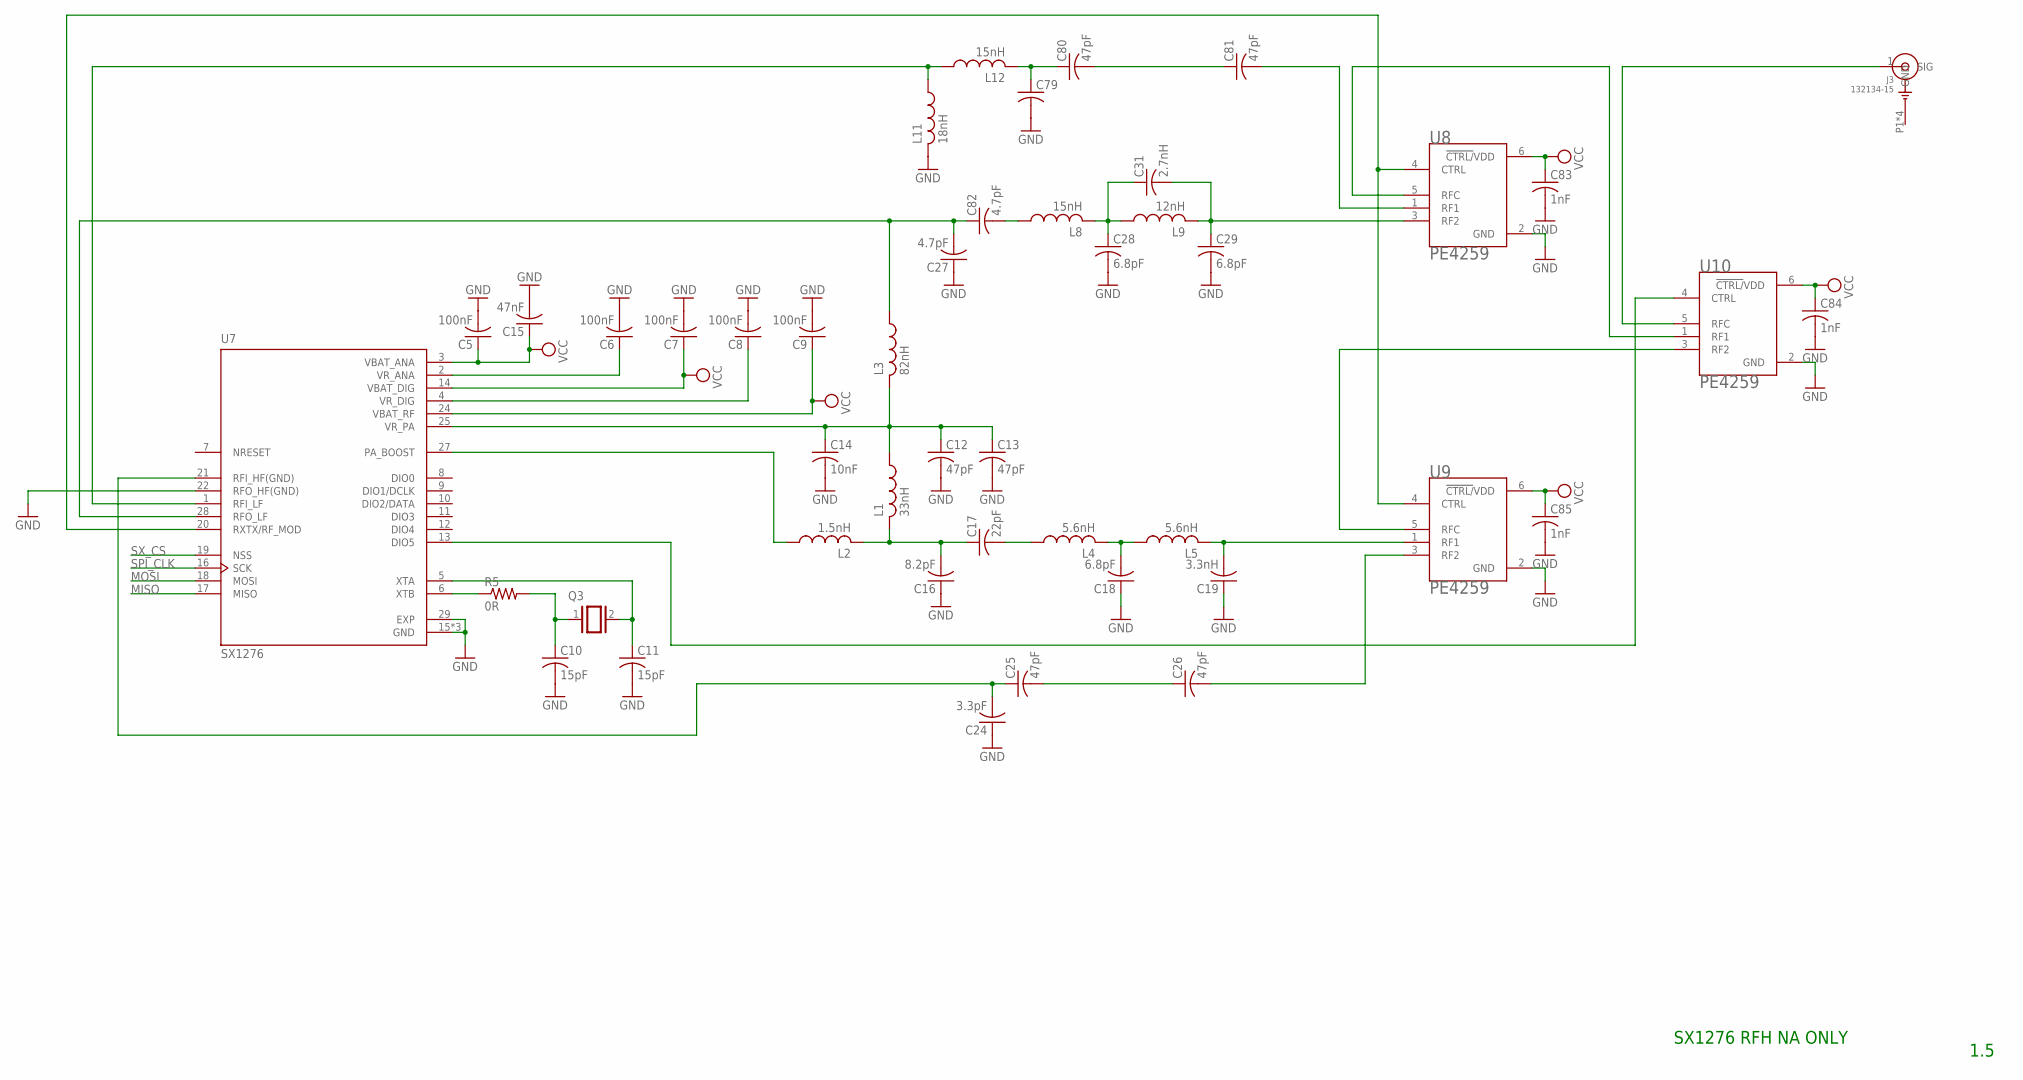
[picture p18: schematic RAFT_DuckLink_NA.sch, sheet 2]

Parts:
C5, C6, C7, C8, C9: 100nF; C0805
C10, C11: 15pF; C0805
C12, C13, C25, C26, C80, C81: 47pF; C0805
C14: 10nF; C0805
C15: 47nF; C0805
C16: 8.2pF; C0805
C17: 22pF; C0805
C18, C28, C29: 6.8pF; C0805
C19: 3.3nH; C0805
C24: 3.3pF; C0805
C27, C82: 4.7pF; C0805
C31: 2.7nH; C0805
C79: C-USC0805; C0805
C83, C84, C85: 1nF; C0805
J3: 132134-15; AMPHENOL_132134-15
L1: 33nH; L3225M
L2: 1.5nH; L3225M
L3: 82nH; L3225M
L4, L5: 5.6nH; L3225M
L8, L12: 15nH; L3225M
L9: 12nH; L3225M
L11: 18nH; L3225M
Q3: XTAL/S; QS
R5: 0R; R0805
U7: SX1276; QFN65P600X600X100-29N
U8, U9, U10: PE4259; SOT65P215X110-6N

Connections:
GND: C5.2, C6.2, C7.2, C8.2, C9.2, C10.2, C11.2, C12.2, C13.2, C14.2, C15.2, C16.1, C18.1, C19.1, C24.1, C27.1, C28.2, C29.2, C79.2, C83.2, C84.2, C85.2, L11.2, U7.15 (GND), U7.22 (RFO_HF(GND)), U7.29 (EXP), U8.2 (GND), U9.2 (GND), U10.2 (GND)
MISO: U7.17 (MISO)
MOSI: U7.18 (MOSI)
unnamed: C6.1, U7.2 (VR_ANA)
unnamed: C8.1, U7.4 (VR_DIG)
unnamed: C10.1, Q3.1, R5.2
unnamed: C11.1, Q3.2, U7.5 (XTA)
unnamed: R5.1, U7.6 (XTB)
unnamed: C12.1, C13.1, C14.1, L1.1, L3.2, U7.25 (VR_PA)
unnamed: L2.1, U7.27 (PA_BOOST)
unnamed: C27.2, C82.1, L3.1, U7.28 (RFO_LF)
unnamed: C17.2, L4.1
unnamed: C18.2, L4.2, L5.1
unnamed: C19.2, L5.2, U9.1 (RF1)
unnamed: C80.2, C81.1
unnamed: C24.2, C25.1, U7.21 (RFI_HF(GND))
unnamed: C25.2, C26.1
unnamed: C26.2, U9.3 (RF2)
unnamed: C16.2, C17.1, L1.2, L2.2
unnamed: C28.1, C31.1, L8.2, L9.1
unnamed: C29.1, C31.2, L9.2, U8.3 (RF2)
unnamed: L11.1, L12.1, U7.1 (RFI_LF)
unnamed: C79.1, C80.1, L12.2
unnamed: C81.2, U8.1 (RF1)
unnamed: C82.2, L8.1
unnamed: U7.20 (RXTX/RF_MOD), U8.4 (CTRL), U9.4 (CTRL)
unnamed: U8.5 (RFC), U10.1 (RF1)
unnamed: U9.5 (RFC), U10.3 (RF2)
unnamed: J3.1 (SIG), U10.5 (RFC)
unnamed: U7.13 (DIO5), U10.4 (CTRL)
SPI_CLK: U7.16 (SCK)
SX_CS: U7.19 (NSS)
VCC: C5.1, C7.1, C9.1, C15.1, C83.1, C84.1, C85.1, U7.3 (VBAT_ANA), U7.14 (VBAT_DIG), U7.24 (VBAT_RF), U8.6 (!CTRL/!VDD), U9.6 (!CTRL/!VDD), U10.6 (!CTRL/!VDD)

Notes on the sheet:
SX1276 RFH NA ONLY
1.5

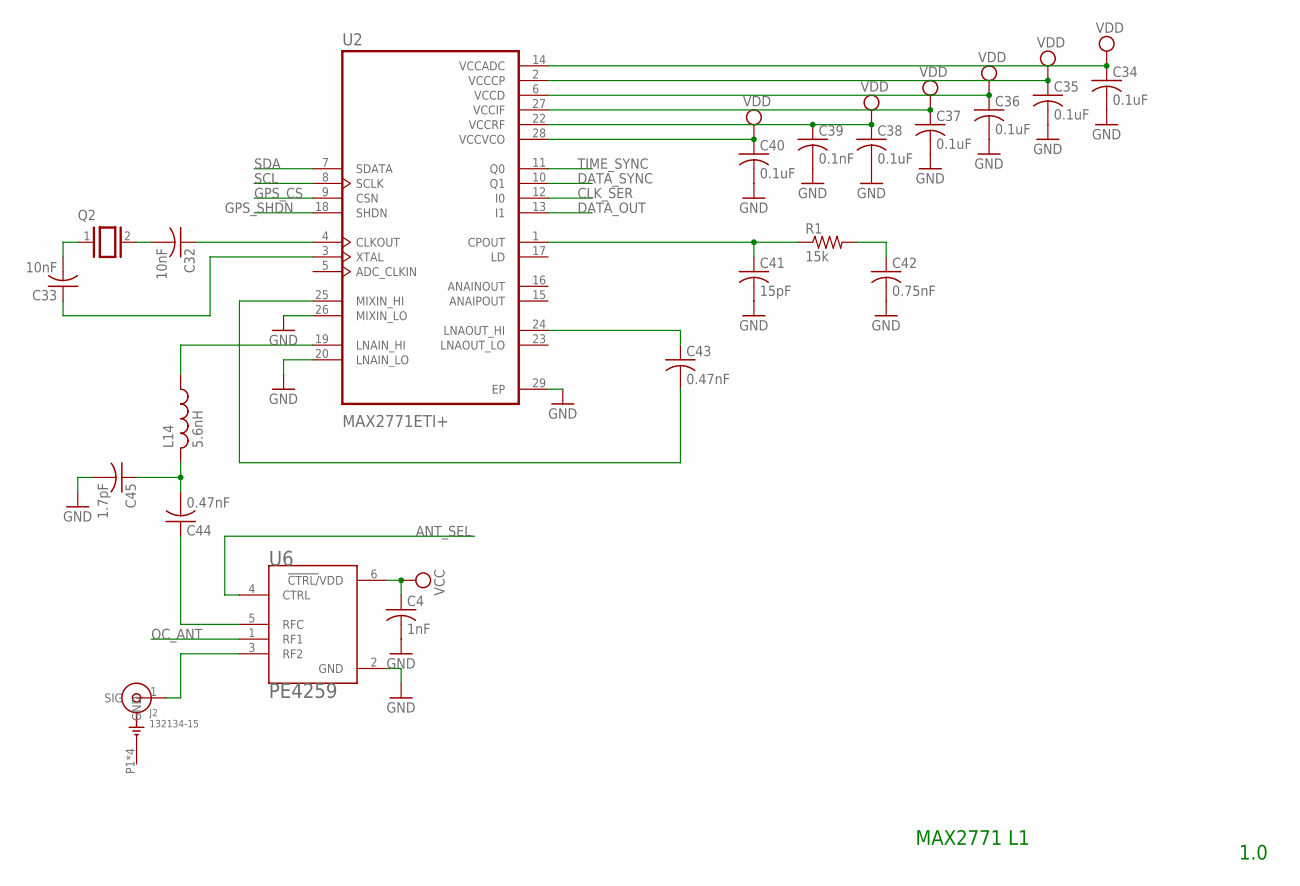
[picture p19: schematic RAFT_DuckLink_NA.sch, sheet 3]

Parts:
C4: 1nF; C0805
C32, C33: 10nF; C050-030X075
C34, C35, C36, C37, C38, C40: 0.1uF; C050-030X075
C39: 0.1nF; C050-030X075
C41: 15pF; C050-030X075
C42: 0.75nF; C050-030X075
C43, C44: 0.47nF; C0805
C45: 1.7pF; C0805
J2: 132134-15; AMPHENOL_132134-15
L14: 5.6nH; L3225M
Q2: XTAL/S; QS
R1: 15k; R0805
U2: MAX2771ETI+; QFN50P500X500X80-29N
U6: PE4259; SOT65P215X110-6N

Connections:
ANT_SEL: U6.4 (CTRL)
CLK_SER: U2.12 (I0)
DATA_OUT: U2.13 (I1)
DATA_SYNC: U2.10 (Q1)
GND: C4.2, C34.2, C35.2, C36.2, C37.2, C38.2, C39.2, C40.2, C41.2, C42.2, C45.2, U2.20 (LNAIN_LO), U2.26 (MIXIN_LO), U2.29 (EP), U6.2 (GND)
GPS_CS: U2.9 (CSN)
GPS_SHDN: U2.18 (SHDN)
unnamed: C44.1, U6.5 (RFC)
unnamed: C33.2, Q2.1
unnamed: J2.1 (SIG), U6.3 (RF2)
unnamed: C33.1, U2.3 (XTAL)
unnamed: C32.2, Q2.2
unnamed: C32.1, U2.4 (CLKOUT)
unnamed: C41.1, R1.1, U2.1 (CPOUT)
unnamed: C42.1, R1.2
unnamed: L14.1, U2.19 (LNAIN_HI)
unnamed: C43.1, U2.24 (LNAOUT_HI)
unnamed: C44.2, C45.1, L14.2
unnamed: C43.2, U2.25 (MIXIN_HI)
OC_ANT: U6.1 (RF1)
SCL: U2.8 (SCLK)
SDA: U2.7 (SDATA)
TIME_SYNC: U2.11 (Q0)
VCC: C4.1, U6.6 (!CTRL/!VDD)
VDD: C34.1, C35.1, C36.1, C37.1, C38.1, C39.1, C40.1, U2.2 (VCCCP), U2.6 (VCCD), U2.14 (VCCADC), U2.22 (VCCRF), U2.27 (VCCIF), U2.28 (VCCVCO)

Notes on the sheet:
1.0
MAX2771 L1
