praisejimmy/CapstoneProjectOWL/Hardware/RAFTv1.0/RAFT_DuckLink_RFH.sch

## EAGLE design Hardware/RAFTv1.0/RAFT_DuckLink_RFH.sch (2020-02-10)

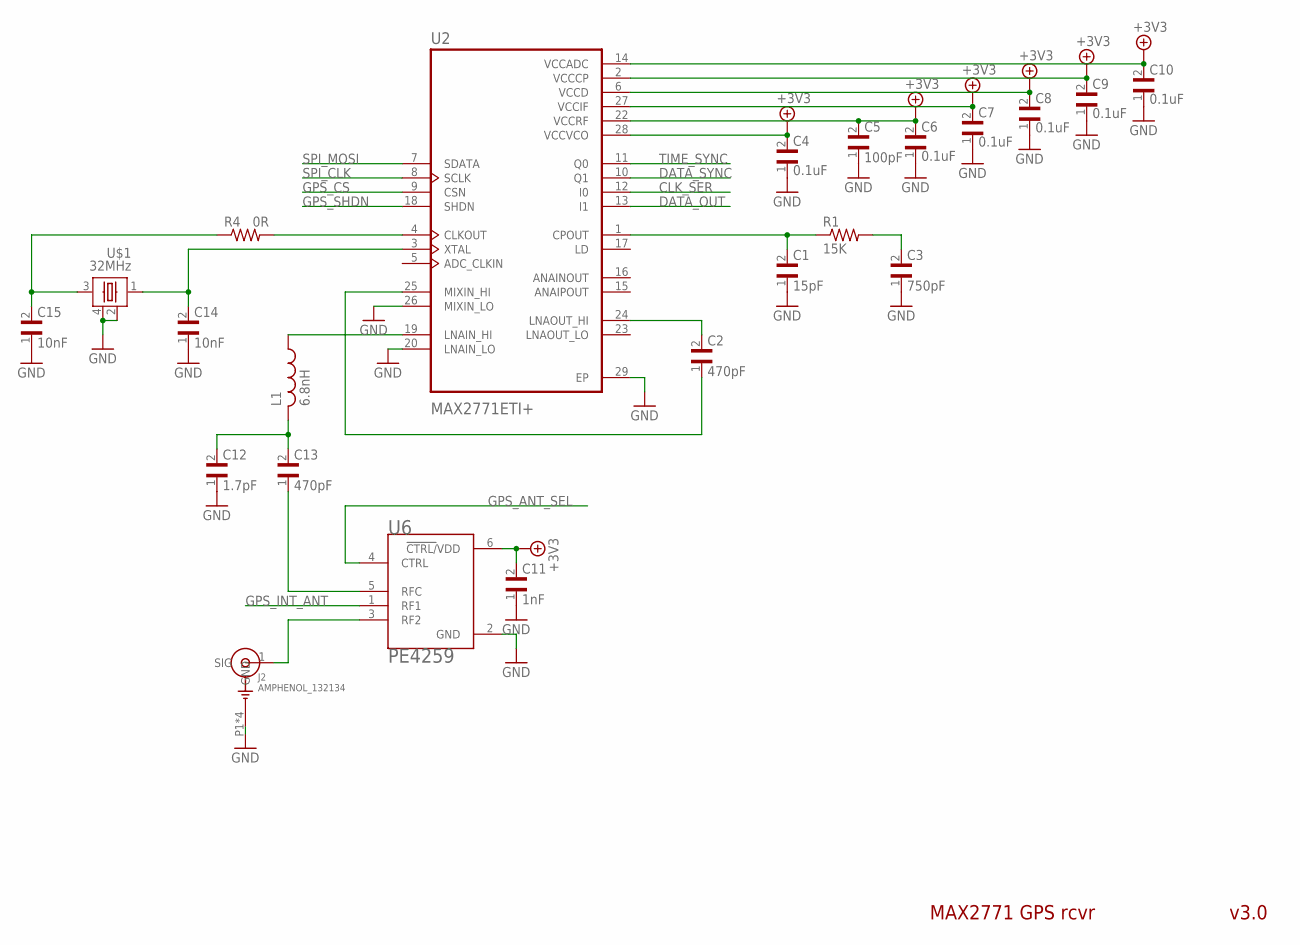
[picture p20: schematic RAFT_DuckLink_RFH.sch, sheet 1]

Parts:
C1: 15pF; CAPC1005X55N
C2, C13: 470pF; CAPC1005X55N
C3: 750pF; CAPC1608X90N
C4, C6, C7, C8, C9, C10: 0.1uF; CAPC1005X55N
C5: 100pF; CAPC1005X55N
C11: 1nF; CAPC1005X55N
C12: 1.7pF; CAPC1005X55N
C14, C15: 10nF; CAPC1005X55N
J2: AMPHENOL_132134; AMPHENOL_132134-15
L1: 6.8nH; INDC1005X55N
R1: 15K; RESC1005X40N
R4: 0R; RESC1005X40N
U2: MAX2771ETI+; QFN50P500X500X80-29N
U6: PE4259; SOT65P215X110-6N
U$1: 32MHz; SMD-4

Connections:
+3.3V: C4.2, C5.2, C6.2, C7.2, C8.2, C9.2, C10.2, C11.2, U2.2 (VCCCP), U2.6 (VCCD), U2.14 (VCCADC), U2.22 (VCCRF), U2.27 (VCCIF), U2.28 (VCCVCO), U6.6 (!CTRL/!VDD)
CLK_SER: U2.12 (I0)
DATA_OUT: U2.13 (I1)
DATA_SYNC: U2.10 (Q1)
GND: C1.1, C3.1, C4.1, C5.1, C6.1, C7.1, C8.1, C9.1, C10.1, C11.1, C12.1, C14.1, C15.1, J2.P1 (GND), U2.20 (LNAIN_LO), U2.26 (MIXIN_LO), U2.29 (EP), U6.2 (GND), U$1.2, U$1.4
GPS_ANT_SEL: U6.4 (CTRL)
GPS_CS: U2.9 (CSN)
GPS_INT_ANT: U6.1 (RF1)
GPS_SHDN: U2.18 (SHDN)
unnamed: C1.2, R1.1, U2.1 (CPOUT)
unnamed: C3.2, R1.2
unnamed: C2.2, U2.24 (LNAOUT_HI)
unnamed: C2.1, U2.25 (MIXIN_HI)
unnamed: L1.1, U2.19 (LNAIN_HI)
unnamed: C13.1, U6.5 (RFC)
unnamed: J2.1 (SIG), U6.3 (RF2)
unnamed: C12.2, C13.2, L1.2
unnamed: C15.2, R4.1, U$1.3
unnamed: C14.2, U2.3 (XTAL), U$1.1
unnamed: R4.2, U2.4 (CLKOUT)
SPI_CLK: U2.8 (SCLK)
SPI_MOSI: U2.7 (SDATA)
TIME_SYNC: U2.11 (Q0)

Notes on the sheet:
MAX2771 GPS rcvr
v3.0

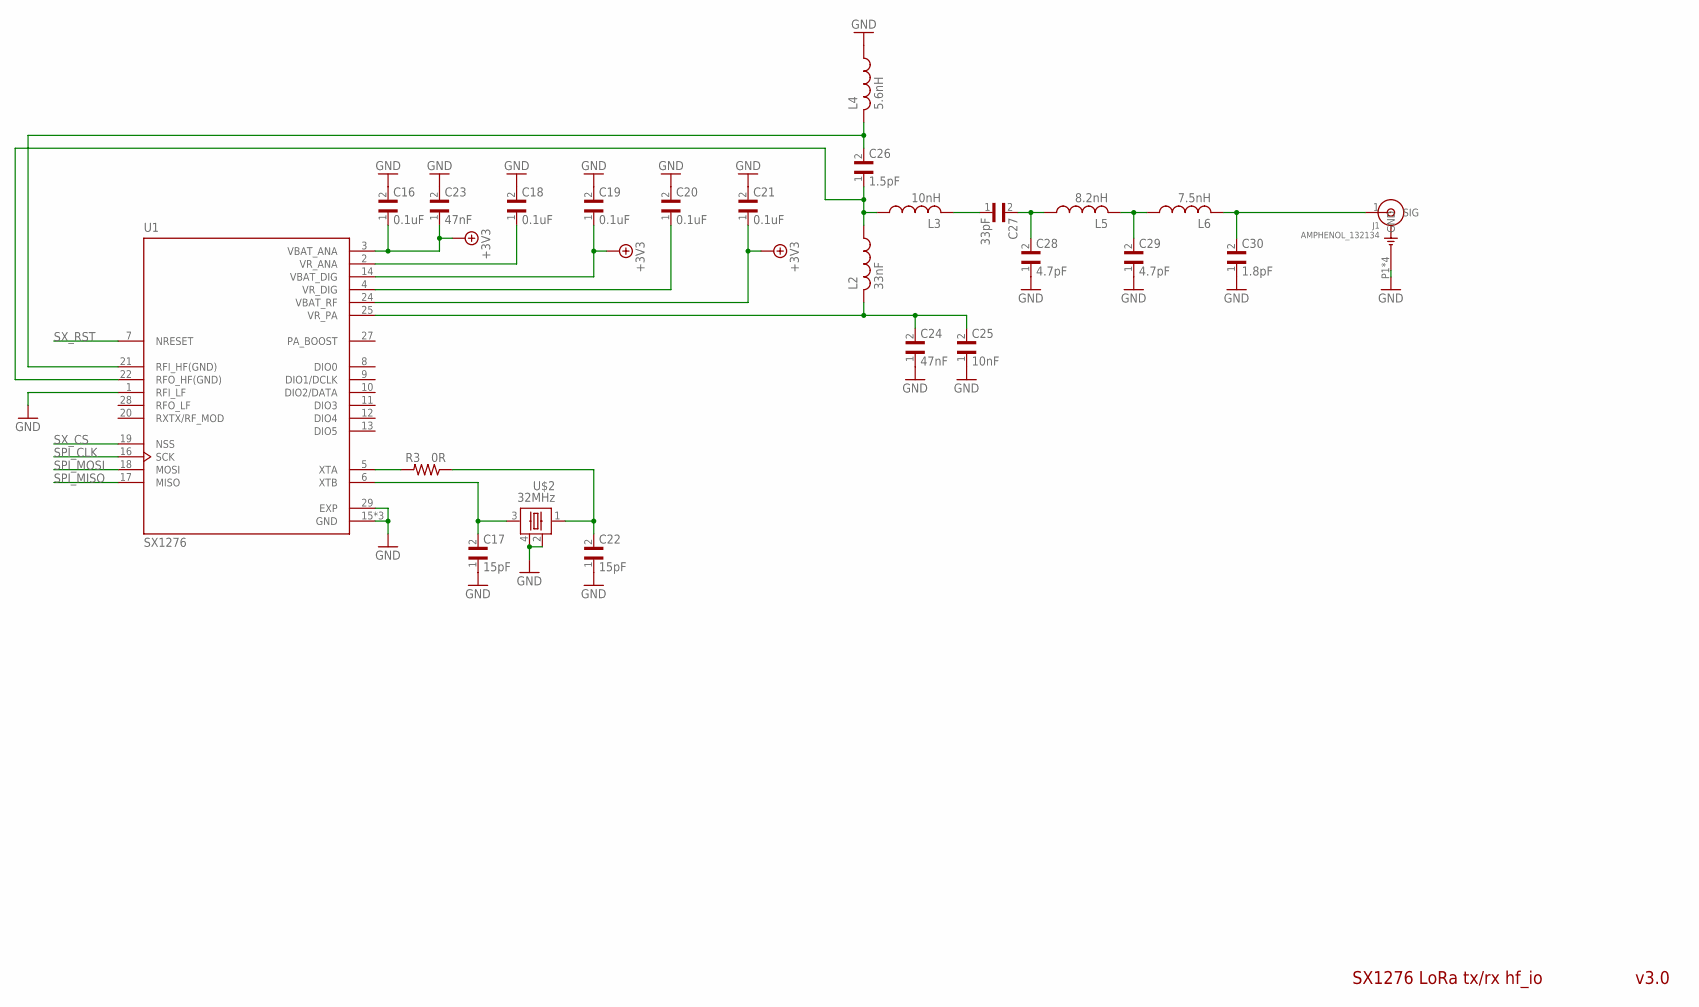
[picture p21: schematic RAFT_DuckLink_RFH.sch, sheet 2]

Parts:
C16, C18, C19, C20, C21: 0.1uF; CAPC1005X55N
C17, C22: 15pF; CAPC1005X55N
C23, C24: 47nF; CAPC1005X55N
C25: 10nF; CAPC1005X55N
C26: 1.5pF; CAPC1005X55N
C27: 33pF; CAPC1005X55N
C28, C29: 4.7pF; CAPC1005X55N
C30: 1.8pF; CAPC1005X55N
J1: AMPHENOL_132134; AMPHENOL_132134-15
L2: 33nF; INDC1005X55N
L3: 10nH; INDC1005X55N
L4: 5.6nH; INDC1005X55N
L5: 8.2nH; INDC1005X55N
L6: 7.5nH; INDC1005X55N
R3: 0R; RESC1005X40N
U1: SX1276; QFN65P600X600X100-29N
U$2: 32MHz; SMD-4

Connections:
+3.3V: C16.1, C19.1, C21.1, C23.1, U1.3 (VBAT_ANA), U1.14 (VBAT_DIG), U1.24 (VBAT_RF)
GND: C16.2, C17.1, C18.2, C19.2, C20.2, C21.2, C22.1, C23.2, C24.1, C25.1, C28.1, C29.1, C30.1, J1.P1 (GND), L4.1, U1.1 (RFI_LF), U1.15 (GND), U1.29 (EXP), U$2.2, U$2.4
unnamed: C24.2, C25.2, L2.2, U1.25 (VR_PA)
unnamed: C18.1, U1.2 (VR_ANA)
unnamed: C22.2, R3.1, U$2.1
unnamed: C20.1, U1.4 (VR_DIG)
unnamed: C17.2, U1.6 (XTB), U$2.3
unnamed: C26.1, L2.1, L3.1, U1.22 (RFO_HF(GND))
unnamed: C26.2, L4.2, U1.21 (RFI_HF(GND))
unnamed: C27.1, L3.2
unnamed: C27.2, C28.2, L5.1
unnamed: C29.2, L5.2, L6.1
unnamed: C30.2, J1.1 (SIG), L6.2
unnamed: R3.2, U1.5 (XTA)
SPI_CLK: U1.16 (SCK)
SPI_MISO: U1.17 (MISO)
SPI_MOSI: U1.18 (MOSI)
SX_CS: U1.19 (NSS)
SX_RST: U1.7 (NRESET)

Notes on the sheet:
SX1276 LoRa tx/rx hf_io
v3.0

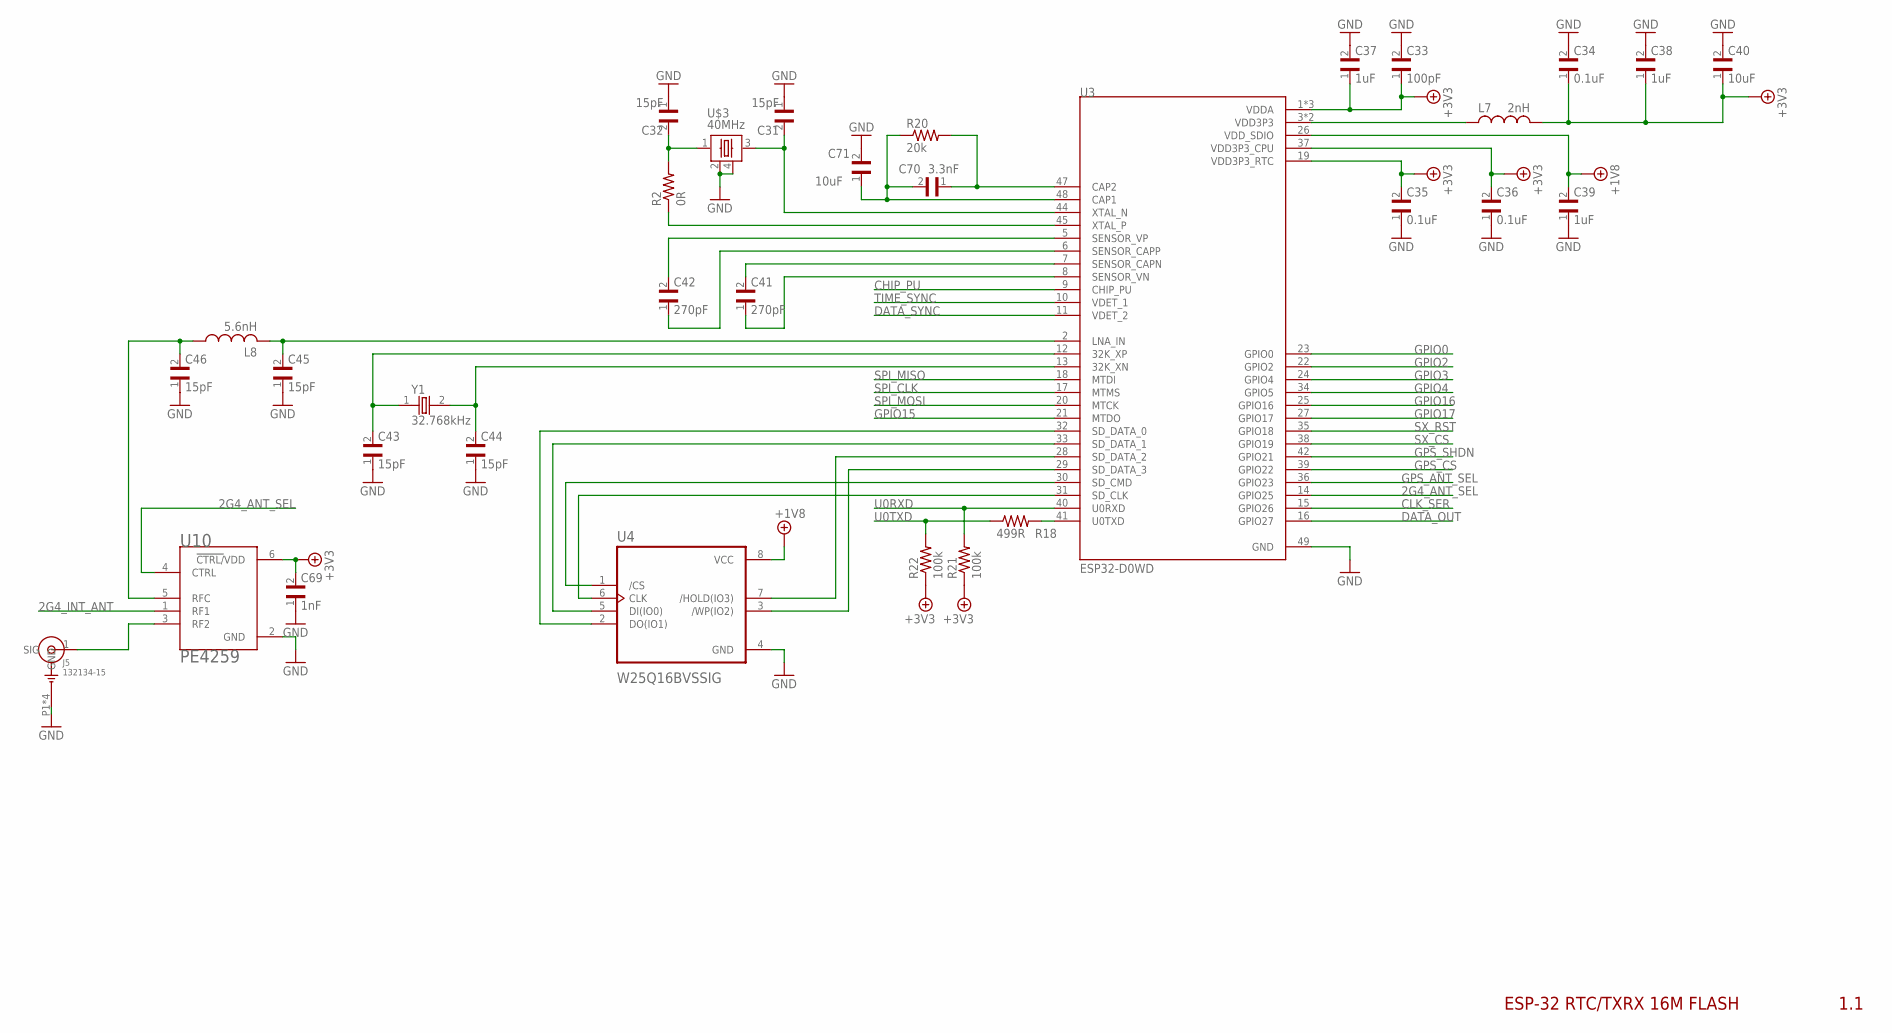
[picture p22: schematic RAFT_DuckLink_RFH.sch, sheet 3]

Parts:
C31, C32, C43, C44, C45, C46: 15pF; CAPC1005X55N
C33: 100pF; CAPC1005X55N
C34, C35, C36: 0.1uF; CAPC1005X55N
C37, C38, C39: 1uF; CAPC1005X70N
C40, C71: 10uF; CAPC1005X70N
C41, C42: 270pF; CAPC1005X55N
C69: 1nF; CAPC1005X55N
C70: 3.3nF; CAPC1005X55N
J5: 132134-15; AMPHENOL_132134-15
L7: 2nH; INDC1005X55N
L8: 5.6nH; INDC1005X55N
R2: 0R; RESC1005X40N
R18: 499R; RESC1005X35N
R20: 20k; RESC1005X35N
R21, R22: 100k; RESC1005X40N
U3: ESP32-D0WD; QFN35P500X500X90-49N
U4: W25Q16BVSSIG; SOIC127P790X216-8N
U10: PE4259; SOT65P215X110-6N
U$3: 40MHz; SMD-4
Y1: 32.768kHz; OSCCC150X320X80-2N

Connections:
2G4_ANT_SEL: U3.14 (GPIO25), U10.4 (CTRL)
2G4_INT_ANT: U10.1 (RF1)
+1.8V: C39.2, U3.26 (VDD_SDIO), U4.8 (VCC)
+3.3V: C33.1, C34.1, C35.2, C36.2, C37.1, C38.1, C40.1, C69.2, L7.2, R21.1, R22.1, U3.1 (VDDA), U3.19 (VDD3P3_RTC), U3.37 (VDD3P3_CPU), U10.6 (!CTRL/!VDD)
CHIP_PU: U3.9 (CHIP_PU)
CLK_SER: U3.15 (GPIO26)
DATA_OUT: U3.16 (GPIO27)
DATA_SYNC: U3.11 (VDET_2)
GND: C31.1, C32.1, C33.2, C34.2, C35.1, C36.1, C37.2, C38.2, C39.1, C40.2, C43.1, C44.1, C45.1, C46.1, C69.1, C71.2, J5.P1 (GND), U3.49 (GND), U4.4 (GND), U10.2 (GND), U$3.2, U$3.4
GPIO0: U3.23 (GPIO0)
GPIO2: U3.22 (GPIO2)
GPIO3: U3.24 (GPIO4)
GPIO4: U3.34 (GPIO5)
GPIO15: U3.21 (MTDO)
GPIO16: U3.25 (GPIO16)
GPIO17: U3.27 (GPIO17)
GPS_ANT_SEL: U3.36 (GPIO23)
GPS_CS: U3.39 (GPIO22)
GPS_SHDN: U3.42 (GPIO21)
unnamed: R2.1, U3.45 (XTAL_P)
unnamed: C31.2, U3.44 (XTAL_N), U$3.3
unnamed: L7.1, U3.3 (VDD3P3)
unnamed: C41.1, U3.8 (SENSOR_VN)
unnamed: C41.2, U3.7 (SENSOR_CAPN)
unnamed: C42.1, U3.6 (SENSOR_CAPP)
unnamed: C42.2, U3.5 (SENSOR_VP)
unnamed: C32.2, R2.2, U$3.1
unnamed: R18.2, U3.41 (U0TXD)
unnamed: U3.30 (SD_CMD), U4.1 (/CS)
unnamed: U3.31 (SD_CLK), U4.6 (CLK)
unnamed: U3.28 (SD_DATA_2), U4.7 (/HOLD(IO3))
unnamed: U3.29 (SD_DATA_3), U4.3 (/WP(IO2))
unnamed: U3.33 (SD_DATA_1), U4.5 (DI(IO0))
unnamed: U3.32 (SD_DATA_0), U4.2 (DO(IO1))
unnamed: C43.2, U3.12 (32K_XP), Y1.1
unnamed: C46.2, L8.1, U10.5 (RFC)
unnamed: C44.2, U3.13 (32K_XN), Y1.2
unnamed: C45.2, L8.2, U3.2 (LNA_IN)
unnamed: J5.1 (SIG), U10.3 (RF2)
unnamed: C70.1, R20.2, U3.47 (CAP2)
unnamed: C70.2, C71.1, R20.1, U3.48 (CAP1)
SPI_CLK: U3.17 (MTMS)
SPI_MISO: U3.18 (MTDI)
SPI_MOSI: U3.20 (MTCK)
SX_CS: U3.38 (GPIO19)
SX_RST: U3.35 (GPIO18)
TIME_SYNC: U3.10 (VDET_1)
U0RXD: R21.2, U3.40 (U0RXD)
U0TXD: R18.1, R22.2

Notes on the sheet:
1.1
ESP-32 RTC/TXRX 16M FLASH

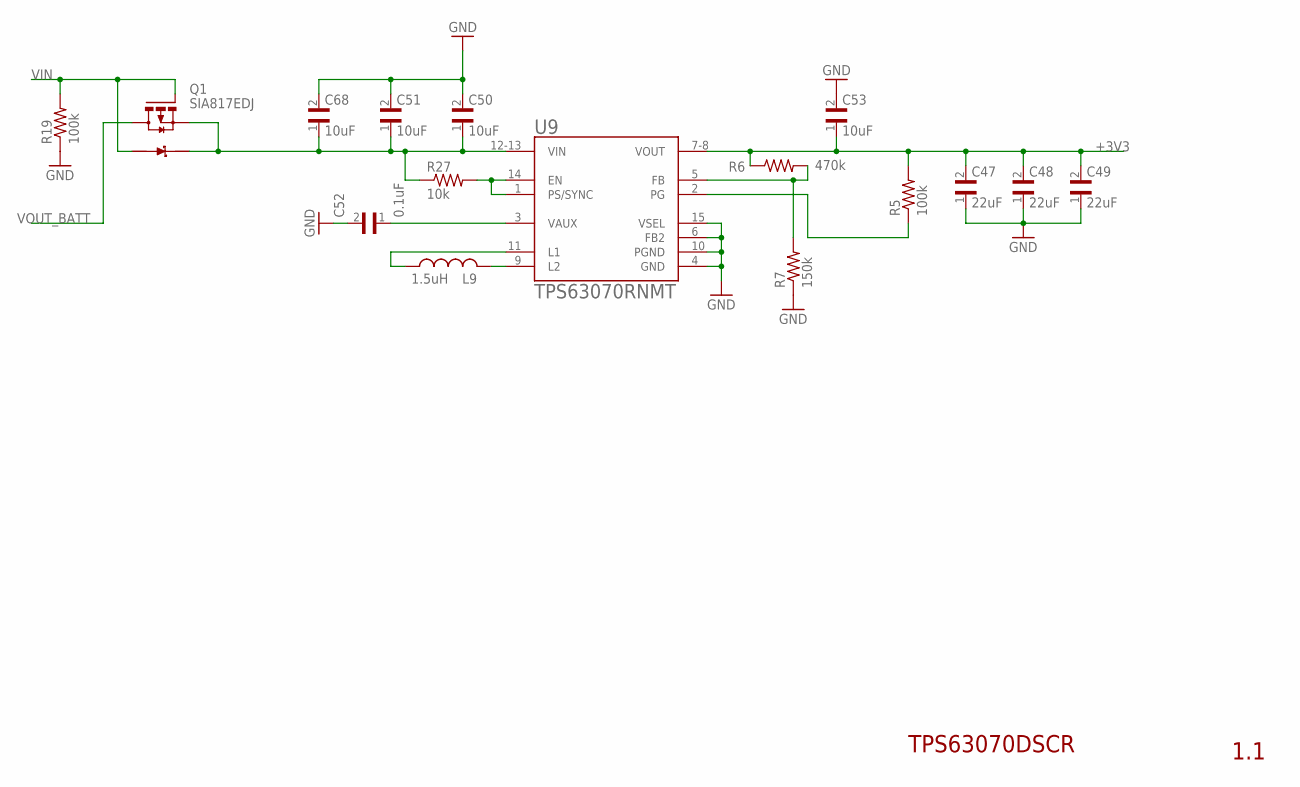
[picture p23: schematic RAFT_DuckLink_RFH.sch, sheet 4]

Parts:
C47, C48, C49: 22uF; CAPC1608X100N
C50, C51, C53, C68: 10uF; CAPC1005X70N
C52: 0.1uF; CAPC1005X55N
L9: 1.5uH; INDC1608X95N
Q1: SIA817EDJ; SC70-6L-DUAL
R5, R19: 100k; RESC1005X40N
R6: 470k; RESC1005X35N
R7: 150k; RESC1005X35N
R27: 10k; RESC1005X40N
U9: TPS63070RNMT; QFN50P250X300X100-15N

Connections:
+3V3: C47.2, C48.2, C49.2, C53.1, R5.2, R6.1, U9.7-8 (VOUT)
GND: C47.1, C48.1, C49.1, C50.2, C51.2, C52.2, C53.2, C68.2, R7.1, R19.1, U9.4 (GND), U9.6 (FB2), U9.10 (PGND), U9.15 (VSEL)
unnamed: C52.1, U9.3 (VAUX)
unnamed: L9.1, U9.11 (L1)
unnamed: L9.2, U9.9 (L2)
unnamed: R5.1, U9.2 (PG)
unnamed: R6.2, R7.2, U9.5 (FB)
unnamed: R27.2, U9.1 (PS/SYNC), U9.14 (EN)
VIN: Q1.P$1 (A), Q1.P$5 (G), R19.2
VIN_SYS: C50.1, C51.1, C68.1, Q1.P$4 (S), Q1.P$6 (K), R27.1, U9.12-13 (VIN)
VOUT_BATT: Q1.P$3 (D)

Notes on the sheet:
TPS63070DSCR
1.1

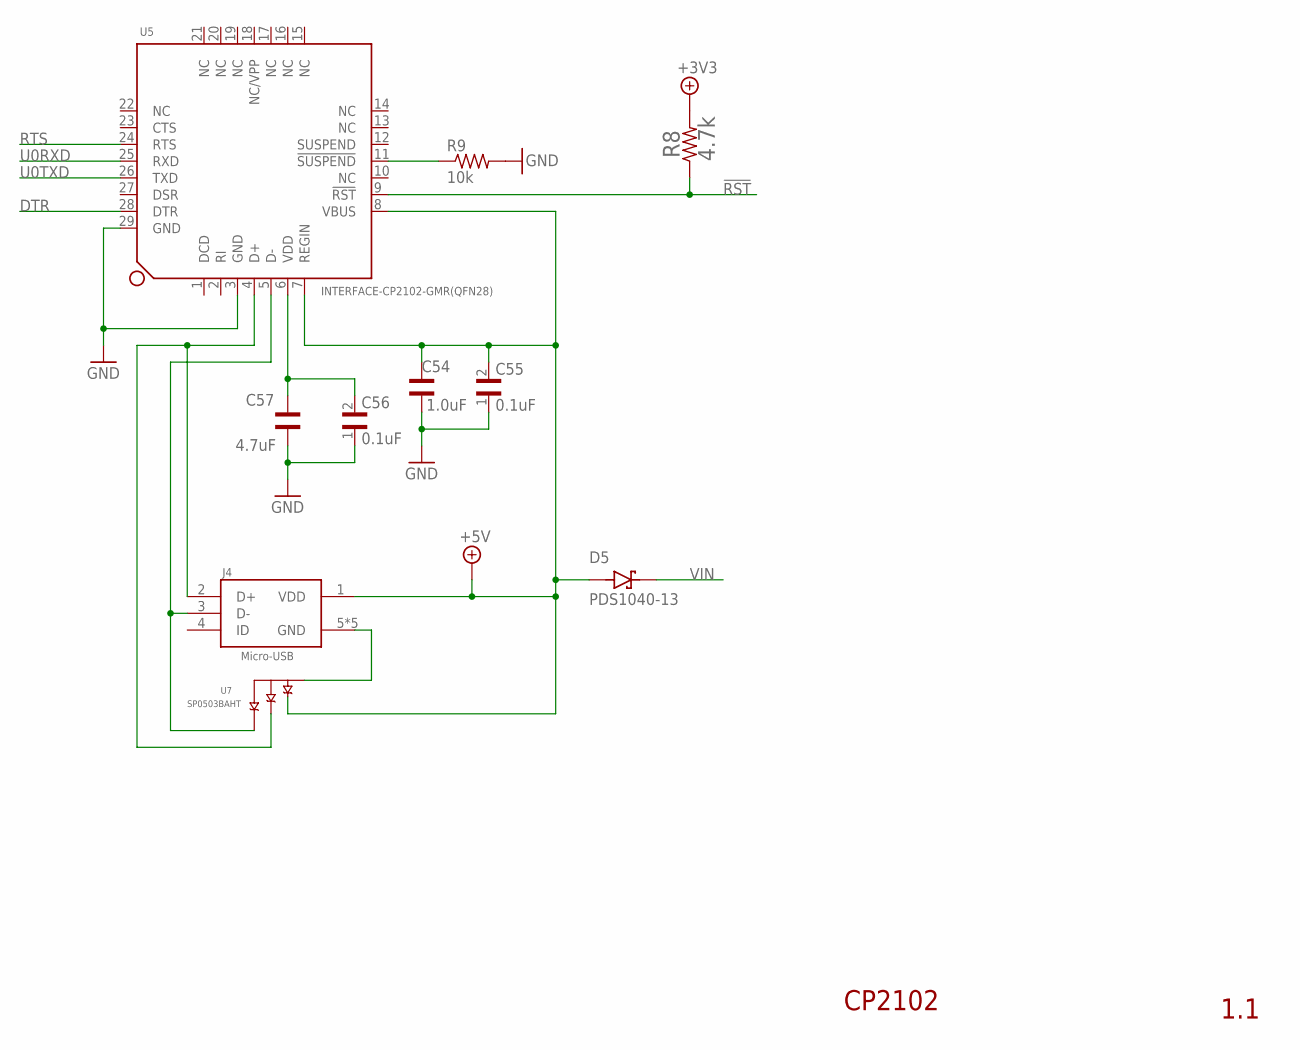
[picture p24: schematic RAFT_DuckLink_RFH.sch, sheet 5]

Parts:
C54: 1.0uF; CAPC1005X70N
C55, C56: 0.1uF; CAPC1005X55N
C57: 4.7uF; CAPC1005X55N
D5: PDS1040-13; DIO_PDS1040-13
J4: Micro-USB; MOLEX_105017-0001
R8: 4.7k; RESC1005X35N
R9: 10k; RESC1005X40N
U5: INTERFACE-CP2102-GMR(QFN28); QFN28G_0.5-5X5MM
U7: SP0503BAHT; SOT143

Connections:
!RST: R8.1, U5.9 (!RST)
+3.3V: R8.2
+5V: C54.2, C55.2, D5.1 (A), J4.1 (VDD), U5.7 (REGIN), U5.8 (VBUS), U7.2 (A)
DTR: U5.28 (DTR)
GND: C54.1, C55.1, C56.1, C57.1, R9.2, U5.3 (GND), U5.29 (GND)
unnamed: R9.1, U5.11 (!SUSPEND)
unnamed: C56.2, C57.2, U5.6 (VDD)
unnamed: J4.3 (D-), U5.5 (D-), U7.4 (C)
unnamed: J4.2 (D+), U5.4 (D+), U7.3 (B)
unnamed: J4.5 (GND), U7.1 (GND)
RTS: U5.24 (RTS)
U0RXD: U5.25 (RXD)
U0TXD: U5.26 (TXD)
VIN: D5.3 (K)

Notes on the sheet:
CP2102
1.1

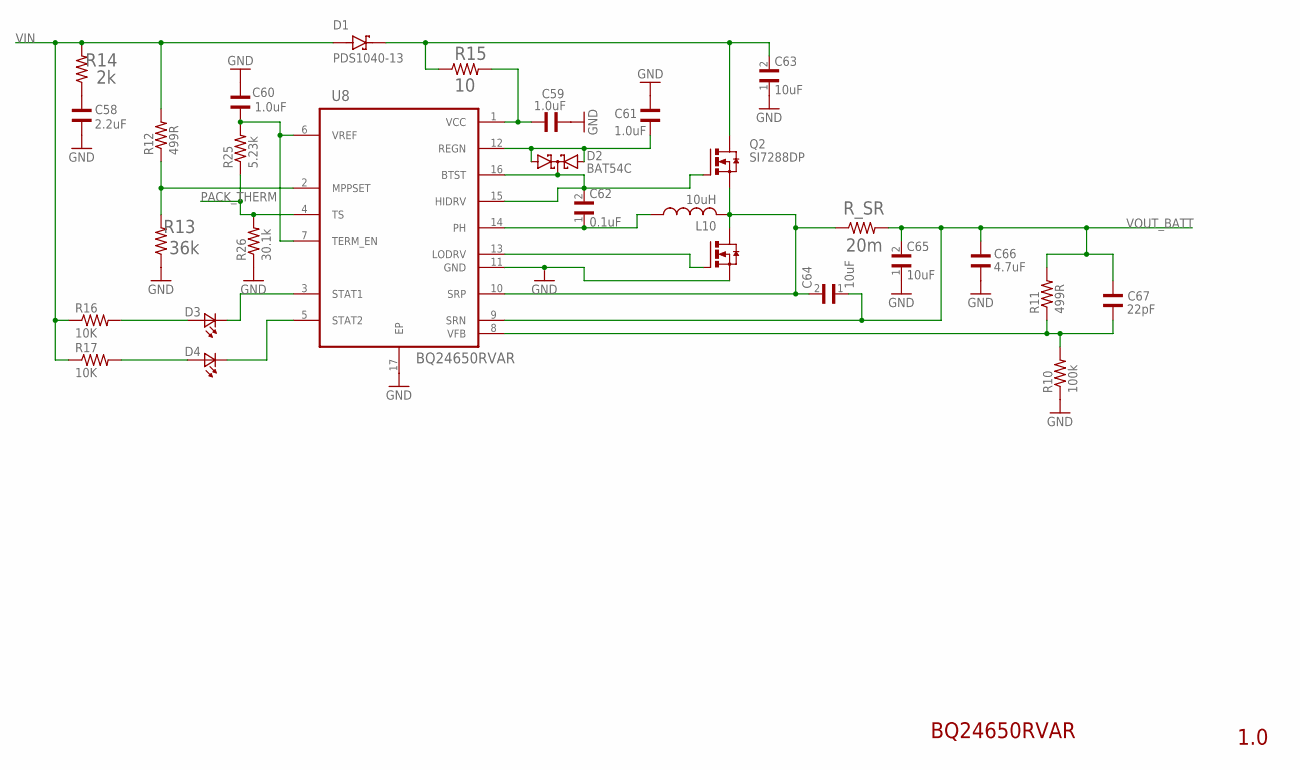
[picture p25: schematic RAFT_DuckLink_RFH.sch, sheet 6]

Parts:
C58: 2.2uF; CAPC1005X55N
C59, C60, C61: 1.0uF; CAPC1005X70N
C62: 0.1uF; CAPC1005X55N
C63, C64, C65: 10uF; CAPC1005X70N
C66: 4.7uF; CAPC1005X55N
C67: 22pF; CAPC1005X55N
D1: PDS1040-13; DIO_PDS1040-13
D2: BAT54C; SOT23
D3, D4: LTST-C190GKT; 0603
L10: 10uH; INDC1608X90N
Q2: SI7288DP; POWERPAK-SO8_1
R10: 100k; RESC1005X40N
R11, R12: 499R; RESC1005X35N
R13: 36k; RESC1005X40N
R14: 2k; RESC1005X40N
R15: 10; RESC1005X35N
R16, R17: 10K; RESC1005X40N
R25: 5.23k; RESC1005X40N
R26: 30.1k; RESC1005X40N
R_SR: 20m; RESC1608X55N
U8: BQ24650RVAR; QFN50P350X350X100-17N

Connections:
GND: C58.1, C59.2, C60.2, C61.2, C63.1, C65.1, C66.1, Q2.3 (S1), R10.1, R13.1, R26.1, U8.11 (GND), U8.17 (EP)
unnamed: Q2.4 (G1), U8.13 (LODRV)
unnamed: C60.1, R25.2, U8.6 (VREF), U8.7 (TERM_EN)
unnamed: R12.1, R13.2, U8.2 (MPPSET)
unnamed: C59.1, R15.2, U8.1 (VCC)
unnamed: C61.1, D2.1 (A1), D2.2 (A2), U8.12 (REGN)
unnamed: C62.2, D2.3 (CC), Q2.2 (G), U8.15 (HIDRV), U8.16 (BTST)
unnamed: C67.1, R10.2, R11.1, U8.8 (VFB)
unnamed: C64.2, L10.2, Q2.1 (S), Q2.5 (D1), R_SR.1, U8.10 (SRP)
unnamed: D4.2 (A2), R17.2
unnamed: D3.2 (A2), R16.2
unnamed: D4.1 (K2), U8.5 (STAT2)
unnamed: D3.1 (K2), U8.3 (STAT1)
unnamed: C62.1, L10.1, U8.14 (PH)
unnamed: C58.2, R14.1
PACK_THERM: R25.1, R26.2, U8.4 (TS)
SC_VIN: C63.2, D1.3 (K), Q2.7 (D), R15.1
VIN: D1.1 (A), R12.2, R14.2, R16.1, R17.1
VOUT_BATT: C64.1, C65.2, C66.2, C67.2, R11.2, R_SR.2, U8.9 (SRN)

Notes on the sheet:
BQ24650RVAR
1.0

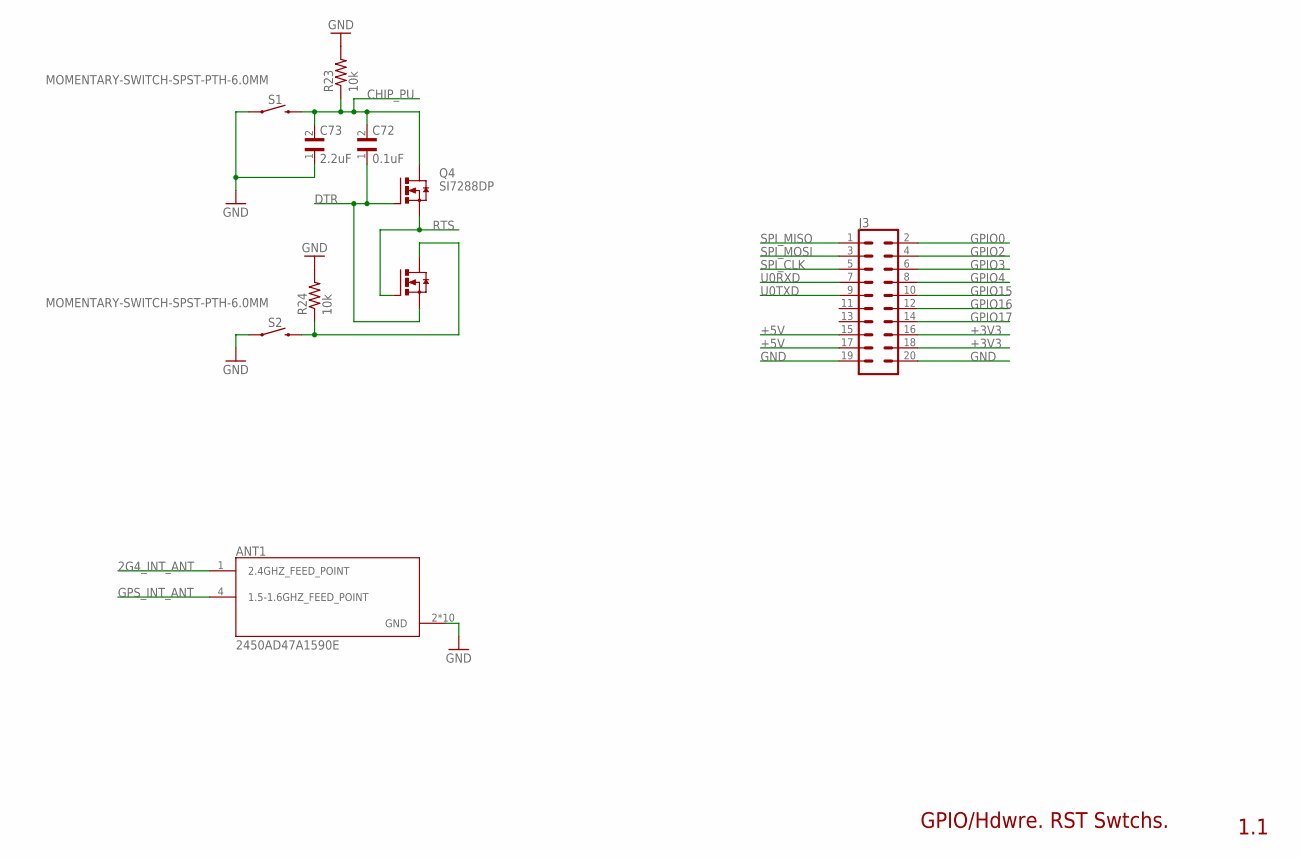
[picture p26: schematic RAFT_DuckLink_RFH.sch, sheet 7]

Parts:
ANT1: 2450AD47A1590E; ANT_2450AD47A1590E
C72: 0.1uF; CAPC1005X55N
C73: 2.2uF; CAPC1005X55N
J3: CONN_10X2; 2X10
Q4: SI7288DP; POWERPAK-SO8_1
R23, R24: 10k; RESC1005X40N
S1, S2: MOMENTARY-SWITCH-SPST-PTH-6.0MM; TACTILE_SWITCH_PTH_6.0MM

Connections:
2G4_INT_ANT: ANT1.1 (2.4GHZ_FEED_POINT)
+3V3: J3.16, J3.18
+5V: J3.15, J3.17
CHIP_PU: C72.2, C73.2, Q4.7 (D), R23.1, S1.3 (2)
DTR: C72.1, Q4.2 (G), Q4.3 (S1)
GND: ANT1.2 (GND), C73.1, J3.19, J3.20, R23.2, R24.2, S1.1, S2.1
GPIO0: J3.2
GPIO2: J3.4
GPIO3: J3.6
GPIO4: J3.8
GPIO15: J3.10
GPIO16: J3.12
GPIO17: J3.14
GPS_INT_ANT: ANT1.4 (1.5-1.6GHZ_FEED_POINT)
unnamed: Q4.5 (D1), R24.1, S2.3 (2)
RTS: Q4.1 (S), Q4.4 (G1)
SPI_CLK: J3.5
SPI_MISO: J3.1
SPI_MOSI: J3.3
U0RXD: J3.7
U0TXD: J3.9

Notes on the sheet:
GPIO/Hdwre. RST Swtchs.
1.1
