praisejimmy/CapstoneProjectOWL/Hardware/RAFTv1.0/RAFT_DuckLink_ReferenceDesigns.sch

## EAGLE design Hardware/RAFTv1.0/RAFT_DuckLink_ReferenceDesigns.sch (2019-12-28)

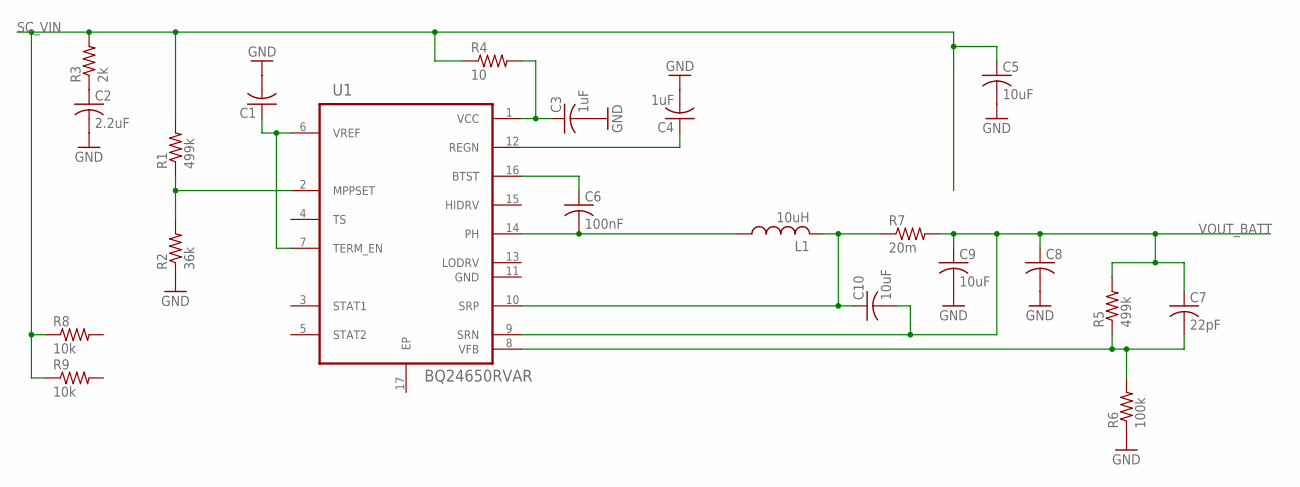
[picture p27: schematic RAFT_DuckLink_ReferenceDesigns.sch, sheet 1]

Parts:
C1, C8: C-USC0805; C0805
C2: 2.2uF; C0805
C3, C4: 1uF; C0805
C5, C9, C10: 10uF; C0805
C6: 100nF; C0805
C7: 22pF; C0805
L1: 10uH; L3225M
R1, R5: 499k; R0805
R2: 36k; R0805
R3: 2k; R0805
R4: 10; R0805
R6: 100k; R0805
R7: 20m; R0805
R8, R9: 10k; R0805
U1: BQ24650RVAR; QFN50P350X350X100-17N

Connections:
GND: C1.2, C2.2, C3.2, C4.2, C5.2, C8.2, C9.2, R2.1, R6.1
unnamed: R1.1, R2.2, U1.2 (MPPSET)
unnamed: C1.1, U1.6 (VREF), U1.7 (TERM_EN)
unnamed: C2.1, R3.1
unnamed: C3.1, R4.2, U1.1 (VCC)
unnamed: C4.1, U1.12 (REGN)
unnamed: C6.2, L1.1, U1.14 (PH)
unnamed: C6.1, U1.16 (BTST)
unnamed: C7.2, R5.1, R6.2, U1.8 (VFB)
unnamed: C10.1, L1.2, R7.1, U1.10 (SRP)
SC_VIN: C5.1, R1.2, R3.2, R4.1, R8.1, R9.1
VOUT_BATT: C7.1, C8.1, C9.1, C10.2, R5.2, R7.2, U1.9 (SRN)
