praisejimmy/CapstoneProjectOWL/Hardware/RAFTv1.0/RAFT_DuckLink_ReferenceDesigns.sch

## EAGLE design Hardware/RAFTv1.0/RAFT_DuckLink_ReferenceDesigns.sch (continued)

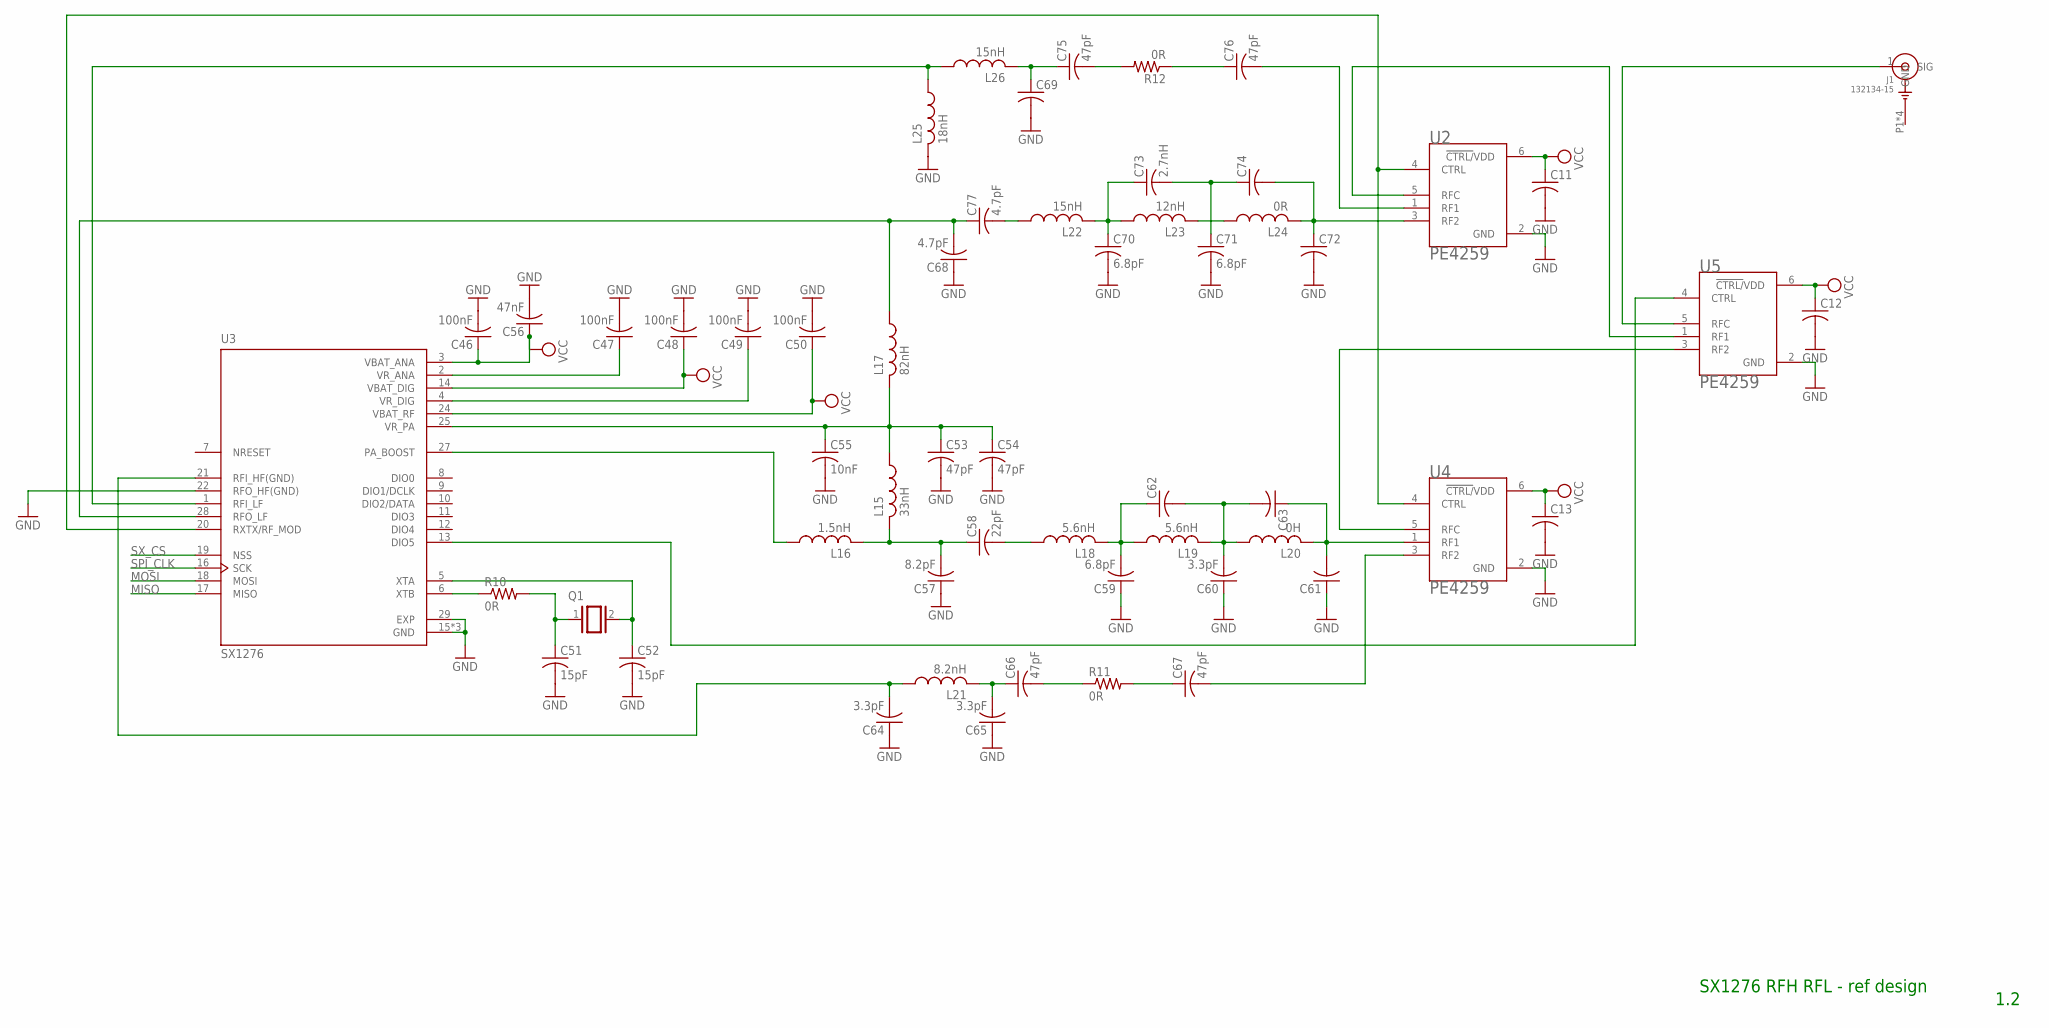
[picture p28: schematic RAFT_DuckLink_ReferenceDesigns.sch, sheet 2]

Parts:
C11, C12, C13, C61, C62, C63, C69, C72, C74: C-USC0805; C0805
C46, C47, C48, C49, C50: 100nF; C0805
C51, C52: 15pF; C0805
C53, C54, C66, C67, C75, C76: 47pF; C0805
C55: 10nF; C0805
C56: 47nF; C0805
C57: 8.2pF; C0805
C58: 22pF; C0805
C59, C70, C71: 6.8pF; C0805
C60, C64, C65: 3.3pF; C0805
C68, C77: 4.7pF; C0805
C73: 2.7nH; C0805
J1: 132134-15; AMPHENOL_132134-15
L15: 33nH; L3225M
L16: 1.5nH; L3225M
L17: 82nH; L3225M
L18, L19: 5.6nH; L3225M
L20: 0H; L3225M
L21: 8.2nH; L3225M
L22, L26: 15nH; L3225M
L23: 12nH; L3225M
L24: 0R; L3225M
L25: 18nH; L3225M
Q1: XTAL/S; QS
R10, R11, R12: 0R; R0805
U2, U4, U5: PE4259; SOT65P215X110-6N
U3: SX1276; QFN65P600X600X100-29N

Connections:
GND: C11.2, C12.2, C13.2, C46.2, C47.2, C48.2, C49.2, C50.2, C51.2, C52.2, C53.2, C54.2, C55.2, C56.2, C57.1, C59.1, C60.1, C61.1, C64.1, C65.1, C68.1, C69.2, C70.2, C71.2, C72.2, L25.2, U2.2 (GND), U3.15 (GND), U3.22 (RFO_HF(GND)), U3.29 (EXP), U4.2 (GND), U5.2 (GND)
MISO: U3.17 (MISO)
MOSI: U3.18 (MOSI)
unnamed: U2.5 (RFC), U5.1 (RF1)
unnamed: U4.5 (RFC), U5.3 (RF2)
unnamed: J1.1 (SIG), U5.5 (RFC)
unnamed: U3.13 (DIO5), U5.4 (CTRL)
unnamed: R10.1, U3.6 (XTB)
unnamed: C47.1, U3.2 (VR_ANA)
unnamed: C51.1, Q1.1, R10.2
unnamed: C49.1, U3.4 (VR_DIG)
unnamed: C52.1, Q1.2, U3.5 (XTA)
unnamed: C53.1, C54.1, C55.1, L15.1, L17.2, U3.25 (VR_PA)
unnamed: C68.2, C77.1, L17.1, U3.28 (RFO_LF)
unnamed: C57.2, C58.1, L15.2, L16.2
unnamed: L16.1, U3.27 (PA_BOOST)
unnamed: C58.2, L18.1
unnamed: C59.2, C62.1, L18.2, L19.1
unnamed: C60.2, C62.2, C63.2, L19.2, L20.1
unnamed: C61.2, C63.1, L20.2, U4.1 (RF1)
unnamed: C70.1, C73.1, L22.2, L23.1
unnamed: C64.2, L21.1, U3.21 (RFI_HF(GND))
unnamed: C65.2, C66.1, L21.2
unnamed: C66.2, R11.1
unnamed: C67.1, R11.2
unnamed: C67.2, U4.3 (RF2)
unnamed: C77.2, L22.1
unnamed: C71.1, C73.2, C74.1
unnamed: L23.2, L24.1
unnamed: C72.1, C74.2, L24.2, U2.3 (RF2)
unnamed: L25.1, L26.1, U3.1 (RFI_LF)
unnamed: C69.1, C75.1, L26.2
unnamed: C75.2, R12.2
unnamed: C76.1, R12.1
unnamed: C76.2, U2.1 (RF1)
unnamed: U2.4 (CTRL), U3.20 (RXTX/RF_MOD), U4.4 (CTRL)
SPI_CLK: U3.16 (SCK)
SX_CS: U3.19 (NSS)
VCC: C11.1, C12.1, C13.1, C46.1, C48.1, C50.1, C56.1, U2.6 (!CTRL/!VDD), U3.3 (VBAT_ANA), U3.14 (VBAT_DIG), U3.24 (VBAT_RF), U4.6 (!CTRL/!VDD), U5.6 (!CTRL/!VDD)

Notes on the sheet:
SX1276 RFH RFL - ref design
1.2
