praisejimmy/CapstoneProjectOWL/Hardware/RAFTv1.0/RAFT_DuckLink_Universal.sch

## EAGLE design Hardware/RAFTv1.0/RAFT_DuckLink_Universal.sch (2020-01-08)


Parts:
C4: 1nF; C0805
C32, C33: 10nF; C050-030X075
C34, C35, C36, C37, C38, C40: 0.1uF; C050-030X075
C39: 0.1nF; C050-030X075
C41: 15pF; C050-030X075
C42: 0.75nF; C050-030X075
C43, C44: 0.47nF; C0805
C45: 1.7pF; C0805
J2: 132134-15; AMPHENOL_132134-15
L14: 5.6nH; L3225M
Q2: XTAL/S; QS
R1: 15k; R0805
U2: MAX2771ETI+; QFN50P500X500X80-29N
U6: PE4259; SOT65P215X110-6N

Connections:
ANT_SEL: U6.4 (CTRL)
CLK_SER: U2.12 (I0)
DATA_OUT: U2.13 (I1)
DATA_SYNC: U2.10 (Q1)
GND: C4.2, C34.2, C35.2, C36.2, C37.2, C38.2, C39.2, C40.2, C41.2, C42.2, C45.2, U2.20 (LNAIN_LO), U2.26 (MIXIN_LO), U2.29 (EP), U6.2 (GND)
GPS_CS: U2.9 (CSN)
GPS_SHDN: U2.18 (SHDN)
unnamed: C44.1, U6.5 (RFC)
unnamed: C33.2, Q2.1
unnamed: J2.1 (SIG), U6.3 (RF2)
unnamed: C33.1, U2.3 (XTAL)
unnamed: C32.2, Q2.2
unnamed: C32.1, U2.4 (CLKOUT)
unnamed: C41.1, R1.1, U2.1 (CPOUT)
unnamed: C42.1, R1.2
unnamed: L14.1, U2.19 (LNAIN_HI)
unnamed: C43.1, U2.24 (LNAOUT_HI)
unnamed: C44.2, C45.1, L14.2
unnamed: C43.2, U2.25 (MIXIN_HI)
OC_ANT: U6.1 (RF1)
SCL: U2.8 (SCLK)
SDA: U2.7 (SDATA)
TIME_SYNC: U2.11 (Q0)
VCC: C4.1, U6.6 (!CTRL/!VDD)
VDD: C34.1, C35.1, C36.1, C37.1, C38.1, C39.1, C40.1, U2.2 (VCCCP), U2.6 (VCCD), U2.14 (VCCADC), U2.22 (VCCRF), U2.27 (VCCIF), U2.28 (VCCVCO)

Notes on the sheet:
1.0
MAX2771 L1

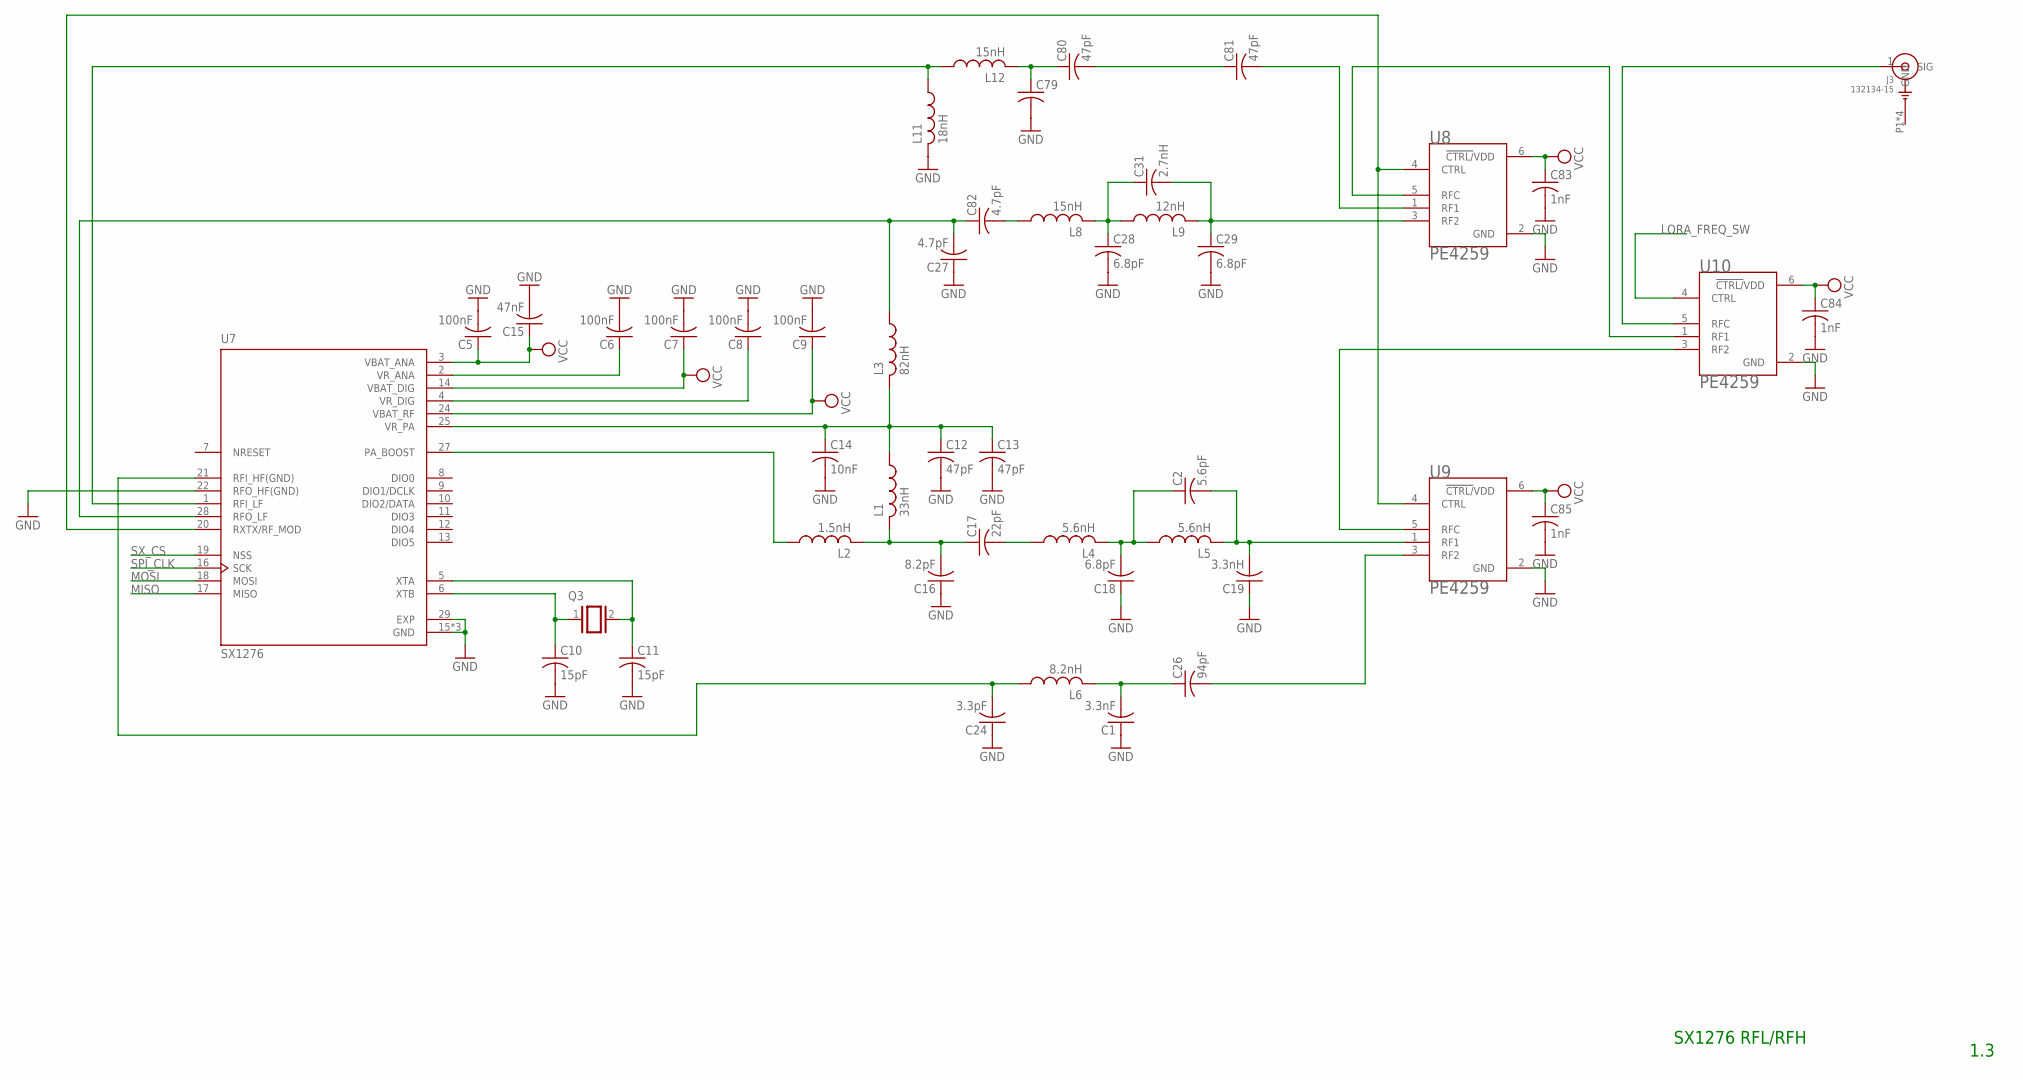
[picture p29: schematic RAFT_DuckLink_Universal.sch, sheet 2]

Parts:
C1: 3.3nF; C0805
C2: 5.6pF; C0805
C5, C6, C7, C8, C9: 100nF; C0805
C10, C11: 15pF; C0805
C12, C13, C80, C81: 47pF; C0805
C14: 10nF; C0805
C15: 47nF; C0805
C16: 8.2pF; C0805
C17: 22pF; C0805
C18, C28, C29: 6.8pF; C0805
C19: 3.3nH; C0805
C24: 3.3pF; C0805
C26: 94pF; C0805
C27, C82: 4.7pF; C0805
C31: 2.7nH; C0805
C79: C-USC0805; C0805
C83, C84, C85: 1nF; C0805
J3: 132134-15; AMPHENOL_132134-15
L1: 33nH; L3225M
L2: 1.5nH; L3225M
L3: 82nH; L3225M
L4, L5: 5.6nH; L3225M
L6: 8.2nH; L3225M
L8, L12: 15nH; L3225M
L9: 12nH; L3225M
L11: 18nH; L3225M
Q3: XTAL/S; QS
U7: SX1276; QFN65P600X600X100-29N
U8, U9, U10: PE4259; SOT65P215X110-6N

Connections:
GND: C1.1, C5.2, C6.2, C7.2, C8.2, C9.2, C10.2, C11.2, C12.2, C13.2, C14.2, C15.2, C16.1, C18.1, C19.1, C24.1, C27.1, C28.2, C29.2, C79.2, C83.2, C84.2, C85.2, L11.2, U7.15 (GND), U7.22 (RFO_HF(GND)), U7.29 (EXP), U8.2 (GND), U9.2 (GND), U10.2 (GND)
LORA_FREQ_SW: U10.4 (CTRL)
MISO: U7.17 (MISO)
MOSI: U7.18 (MOSI)
unnamed: C1.2, C26.1, L6.2
unnamed: C6.1, U7.2 (VR_ANA)
unnamed: C8.1, U7.4 (VR_DIG)
unnamed: C10.1, Q3.1, U7.6 (XTB)
unnamed: C11.1, Q3.2, U7.5 (XTA)
unnamed: C12.1, C13.1, C14.1, L1.1, L3.2, U7.25 (VR_PA)
unnamed: L2.1, U7.27 (PA_BOOST)
unnamed: C27.2, C82.1, L3.1, U7.28 (RFO_LF)
unnamed: C17.2, L4.1
unnamed: C2.1, C18.2, L4.2, L5.1
unnamed: C2.2, C19.2, L5.2, U9.1 (RF1)
unnamed: C80.2, C81.1
unnamed: C24.2, L6.1, U7.21 (RFI_HF(GND))
unnamed: C26.2, U9.3 (RF2)
unnamed: C16.2, C17.1, L1.2, L2.2
unnamed: C28.1, C31.1, L8.2, L9.1
unnamed: C29.1, C31.2, L9.2, U8.3 (RF2)
unnamed: L11.1, L12.1, U7.1 (RFI_LF)
unnamed: C79.1, C80.1, L12.2
unnamed: C81.2, U8.1 (RF1)
unnamed: C82.2, L8.1
unnamed: U7.20 (RXTX/RF_MOD), U8.4 (CTRL), U9.4 (CTRL)
unnamed: U8.5 (RFC), U10.1 (RF1)
unnamed: U9.5 (RFC), U10.3 (RF2)
unnamed: J3.1 (SIG), U10.5 (RFC)
SPI_CLK: U7.16 (SCK)
SX_CS: U7.19 (NSS)
VCC: C5.1, C7.1, C9.1, C15.1, C83.1, C84.1, C85.1, U7.3 (VBAT_ANA), U7.14 (VBAT_DIG), U7.24 (VBAT_RF), U8.6 (!CTRL/!VDD), U9.6 (!CTRL/!VDD), U10.6 (!CTRL/!VDD)

Notes on the sheet:
SX1276 RFL/RFH
1.3

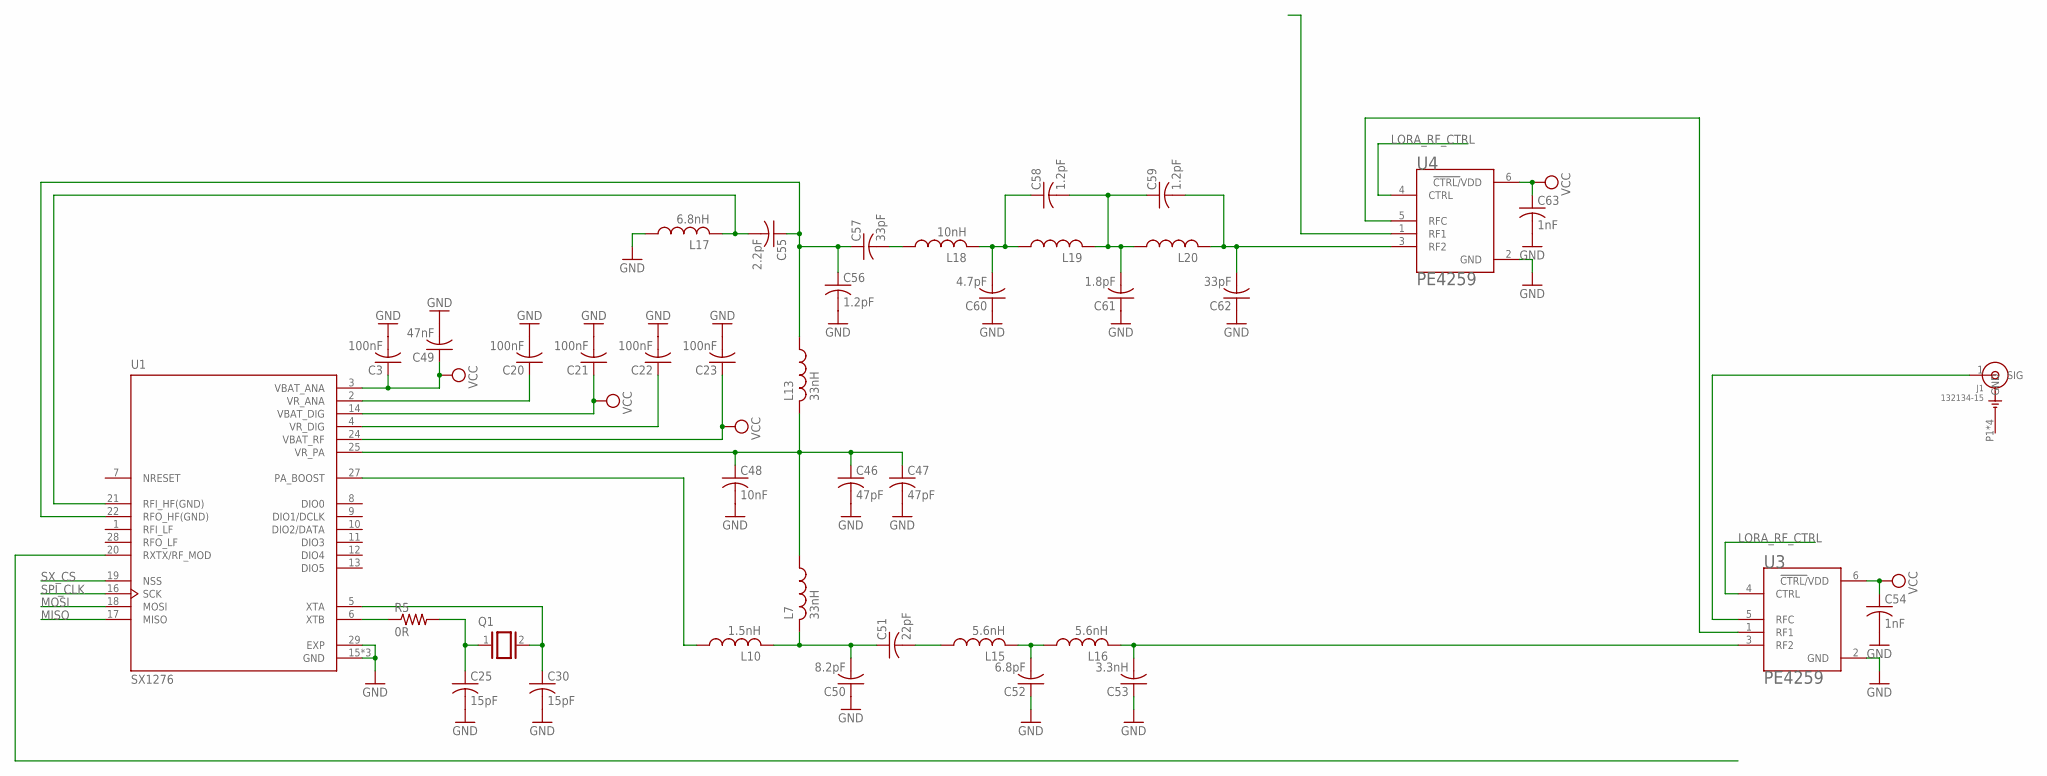
[picture p30: schematic RAFT_DuckLink_Universal.sch, sheet 3]

Parts:
C3, C20, C21, C22, C23: 100nF; C0805
C25, C30: 15pF; C0805
C46, C47: 47pF; C0805
C48: 10nF; C0805
C49: 47nF; C0805
C50: 8.2pF; C0805
C51: 22pF; C0805
C52: 6.8pF; C0805
C53: 3.3nH; C0805
C54, C63: 1nF; C0805
C55: 2.2pF; C0805
C56, C58, C59: 1.2pF; C0805
C57, C62: 33pF; C0805
C60: 4.7pF; C0805
C61: 1.8pF; C0805
J1: 132134-15; AMPHENOL_132134-15
L7, L13: 33nH; L3225M
L10: 1.5nH; L3225M
L15, L16: 5.6nH; L3225M
L17: 6.8nH; L3225M
L18: 10nH; L3225M
L19, L20: L-USL3225M; L3225M
Q1: XTAL/S; QS
R5: 0R; R0805
U1: SX1276; QFN65P600X600X100-29N
U3, U4: PE4259; SOT65P215X110-6N

Connections:
GND: C3.2, C20.2, C21.2, C22.2, C23.2, C25.2, C30.2, C46.2, C47.2, C48.2, C49.2, C50.1, C52.1, C53.1, C54.2, C56.2, C60.1, C61.1, C62.1, C63.2, L17.1, U1.15 (GND), U1.29 (EXP), U3.2 (GND), U4.2 (GND)
LORA_RF_CTRL: U3.4 (CTRL), U4.4 (CTRL)
MISO: U1.17 (MISO)
MOSI: U1.18 (MOSI)
unnamed: C20.1, U1.2 (VR_ANA)
unnamed: C22.1, U1.4 (VR_DIG)
unnamed: C25.1, Q1.1, R5.2
unnamed: C30.1, Q1.2, U1.5 (XTA)
unnamed: R5.1, U1.6 (XTB)
unnamed: C46.1, C47.1, C48.1, L7.1, L13.2, U1.25 (VR_PA)
unnamed: L10.1, U1.27 (PA_BOOST)
unnamed: C55.1, C56.1, C57.1, L13.1, U1.22 (RFO_HF(GND))
unnamed: C51.2, L15.1
unnamed: C52.2, L15.2, L16.1
unnamed: C53.2, L16.2, U3.3 (RF2)
unnamed: C50.2, C51.1, L7.2, L10.2
unnamed: C55.2, L17.2, U1.21 (RFI_HF(GND))
unnamed: C57.2, L18.1
unnamed: C58.2, C59.1, C61.2, L19.2, L20.1
unnamed: C59.2, C62.2, L20.2, U4.3 (RF2)
unnamed: C58.1, C60.2, L18.2, L19.1
unnamed: J1.1 (SIG), U3.5 (RFC)
unnamed: U3.1 (RF1), U4.5 (RFC)
SPI_CLK: U1.16 (SCK)
SX_CS: U1.19 (NSS)
VCC: C3.1, C21.1, C23.1, C49.1, C54.1, C63.1, U1.3 (VBAT_ANA), U1.14 (VBAT_DIG), U1.24 (VBAT_RF), U3.6 (!CTRL/!VDD), U4.6 (!CTRL/!VDD)
