praisejimmy/CapstoneProjectOWL/Firmware/RAFT/main/lora_task.h

#ifndef PROJECT_LORA_TASK_H
#define PROJECT_LORA_TASK_H

#define RF_FREQUENCY                                915000000 // Hz

#define TX_OUTPUT_POWER                             14        // dBm

#define LORA_BANDWIDTH                              0         // [0: 125 kHz,1: 250 kHz,2: 500 kHz,3: Reserved]
#define LORA_SPREADING_FACTOR                       7         // [SF7..SF12]
#define LORA_CODINGRATE                             1         // [1: 4/5,2: 4/6,3: 4/7,4: 4/8]
#define LORA_PREAMBLE_LENGTH                        8         // Same for Tx and Rx
#define LORA_SYMBOL_TIMEOUT                         5         // Symbols
#define LORA_FIX_LENGTH_PAYLOAD_ON                  false
#define LORA_IQ_INVERSION_ON                        false


int8_t RssiValue;
int8_t SnrValue;

#define RX_TIMEOUT_VALUE                            1000
#define BUFFER_SIZE                                 64 // Define the payload size here

/*!
 * Radio events function pointer
 */
static RadioEvents_t RadioEvents;

/*!
 * \brief Function to be executed on Radio Tx Done event
 */
void OnTxDone( void );

/*!
 * \brief Function to be executed on Radio Rx Done event
 */
void OnRxDone( uint8_t *payload, uint16_t size, int16_t rssi, int8_t snr );

/*!
 * \brief Function executed on Radio Tx Timeout event
 */
void OnTxTimeout( void );

/*!
 * \brief Function executed on Radio Rx Timeout event
 */
void OnRxTimeout( void );

/*!
 * \brief Function executed on Radio Rx Error event
 */
void OnRxError( void );


void LoraTaskEntry();

void LoraTaskFunc();




#endif //PROJECT_LORA_TASK_H
