praisejimmy/CapstoneProjectOWL/(commit log)

2019-12-03 added datasheets, libraries for some modules, removed epf (hopefully that wont affect anything)
    [radios.sch]
2019-12-09 lora and gps schematics
    [radios.sch]
2019-12-12 finalized gps. ref design for lora. renamed some libraries. added datasheets and started mcu schematic
    [mcu.sch, radios.sch]
2019-12-12 changed more libraries. replaced eeprom and flash mem, added datasheets
    [mcu.sch]
2019-12-28 finalized universal LoRa schematic. started power schematic. renamed schematics
    [RAFT_DuckLink_NA.sch, RAFT_DuckLink_ReferenceDesigns.sch, RAFT_DuckLink_Universal.sch, mcu.sch]
2019-12-28 rerouted lora rf selector, removed unnecessary resistor
    [RAFT_DuckLink_Universal.sch]
2020-01-08 lora rfh changed to low power mode. begin schematic for pa/rfl/rfh universal module
    [RAFT_DuckLink_RFH.sch, RAFT_DuckLink_Universal.sch]
2020-01-10 started MCU layout. added supply library
    [RAFT_DuckLink_RFH.sch]
2020-01-11 Added bq24650 MPPT Solar Charger datasheet
2020-01-13 Added ST1L08SPU33R
    3.3V Step Down
2020-01-13 Added Noah Schematics folder and Charger schematic for review
    Charger: Added missing components, renamed each component to coincide with datasheet example. Note, most of the previous components placed before my work are 0805 sizing so if the goal is 0402 then we will have to fix all of the older components to reflect that.
    [BQ24650_Charger.sch]
2020-01-14 Removed old 3V3 regulator datasheet
2020-01-14 started 0420 footprint conversion
    [RAFT_DuckLink_RFH.sch, RAFT_DuckLink_RFH_old.sch, SX1276MB1JCS_e344v01a_BOM.xls]
2020-01-14 datasheet for usb to uart bridge
2020-01-15 Added 3V3 Regulator Schematic
    [RAFT_DuckLink_LDO_3V3.sch]
2020-01-15 Added UART_Bridge Schematic
    [RAFT_DuckLink_UART_Bridge.sch]
2020-01-15 updated libraries, started replacing components with model specified parts (gps 99% complete)
    [RAFT_DuckLink_LDO_3V3.sch, RAFT_DuckLink_UART_Bridge.sch, SX1276MB1JCS_e344v01a_BOM.xls]
2020-01-15 this didnt work well. heres the new library
    [RAFT_DuckLink_RFH.sch]
2020-01-15 Replacing bq sch
    [BQ24650_Charger.sch]
2020-01-15 Updated Charger Schematic
    Updated components to be 0402 PACKAGES
    [RAFT_DuckLink_Charger.sch]
2020-01-15 Added PDF versions of schematics just in case
2020-01-17 Updated UART Bridge with specific components
    [RAFT_DuckLink_UART_Bridge.sch]
2020-01-17 Removed old LDO sch
    [RAFT_DuckLink_LDO_3V3.sch]
2020-01-17 Removed charger PDF
2020-01-17 added more parts. completed gps, lora
    [RAFT_DuckLink_RFH.sch]
2020-01-17 Added updated charger pdf w/ components
2020-01-17 Added updated Charger with specified components
    [RAFT_DuckLink_Charger.sch]
2020-01-17 Updated charger sch and pdf with specific components
2020-01-17 Updated charger sch and pdf w/ specific components
2020-01-17 Updated charger sch w/ specified components
    Getting upload failures so trying one file at a time
2020-01-17 Updated charger sch w/ components
2020-01-17 charger pdf w/ components
2020-01-17 Updated schems w/ specific components
    [RAFT_DuckLink_3V3_Reg.sch]
2020-01-17 started mcu. added 1.8v source for vddsdio
    [RAFT_DuckLink_RFH.sch]
2020-01-17 more for mcu
    [RAFT_DuckLink_RFH.sch]
2020-01-20 mcu completed
    [RAFT_DuckLink_RFH.sch]
2020-01-20 remove old schematic
    [RAFT_DuckLink_RFH_old.sch]
2020-01-20 added all designs to DuckLink schematic. renamed library
    [RAFT_DuckLink_RFH.sch]
2020-01-23 Removed old TPS63060DSCR regulator datasheet
2020-01-23 Add new TPS63070 3V3 regulator datasheet
2020-01-23 Remove old regulator PDF
2020-01-23 Remove old regulato schematic
    [RAFT_DuckLink_3V3_Reg.sch]
2020-01-23 Added new TPS63070 3V3 Regulator Sch and PDF
    [RAFT_DuckLink_3V3_Reg.sch]
2020-01-23 added load sharing system
    [RAFT_DuckLink_RFH.sch]
2020-01-23 consolidated components
    [RAFT_DuckLink_RFH.sch]
2020-01-25 CAP connection and 2G4 antenna switch for MCU
    [RAFT_DuckLink_RFH.sch, RAFT_DuckLink_RFH_BoM_2020Jan24.xlsx]
2020-01-25 fixed component inconsistencies
    [RAFT_DuckLink_RFH.sch]
2020-01-29 final gpio connections
    [RAFT_DuckLink_RFH.sch]
2020-01-30 fixed uart, updated pins
    [RAFT_DuckLink_RFH.sch]
2020-01-30 added libs for headers and switches (SparkFun). added sch page for io headers
    [RAFT_DuckLink_RFH.sch]
2020-01-31 Initial firmware push, successfully compiled and flashed onto board
2020-02-03 GPIO and rst switches for cpu/usb-uart
    [RAFT_DuckLink_RFH.sch]
2020-02-03 mirrored pin definitions spreadsheet into git
    [POwl_HHDuckLink_PCB_PinDefs.xlsx]
2020-02-03 typo/final edits
    [RAFT_DuckLink_RFH.sch]
2020-02-03 PDF schematics
    [RAFT_DuckLink_RFH.sch]
2020-02-04 replaced schematics for voltage regulator
2020-02-04 added internal antenna
    [RAFT_DuckLink_RFH.sch]
2020-02-04 added second 3V3 and 5V gpio header rails
    [RAFT_DuckLink_RFH.sch]
2020-02-06 removed pull up resistors on uart present from designer confusion
    [RAFT_DuckLink_RFH.sch]
2020-02-06 remove old schematics
    [RAFT_DuckLink_3V3_Reg.sch, RAFT_DuckLink_Charger.sch, RAFT_DuckLink_UART_Bridge.sch]
2020-02-06 Added JST Connector and V_BAT label
    changed VOUT_BATT -> V_BAT
2020-02-08 fixed ERC issues
    [RAFT_DuckLink_RFH.sch]
2020-02-10 latest pdf export of schematics
2020-02-18 Reverted back to C, Started lora task
    [duck_task.c, duck_task.h, hash_table.c, lora_task.c, lora_task.h, main.c, mama_task.c, mama_task.h]
2020-03-05 Using new LoRa library. Added print statements
2020-03-10 Added prints
