praisejimmy/CapstoneProjectOWL/(notices)

Notices in the files:
parts and their libraries:
rcl-raft: COPYRIGHT: Copyright (C) 2018 Accelerated Designs. All rights reserved
rcl-raft: COPYRIGHT: Copyright (C) 2015 Accelerated Designs. All rights reserved
SparkFun-Connectors: Licensing: Creative Commons ShareAlike 4.0 International - https://creativecommons.org/licenses/by-sa/4.0
